aliloay/smart-lab-portal/docs/knowledge/obsidian/vault/12 - Generated Reports/Workflow drift.md

---
type: "report"
generated: true
updated: "2026-11-03T07:00:07+02:00"
---

# Workflow drift

New: none
Deleted: none
Changed:

No workflow was edited, activated or run. Accept the current state as the new baseline with `kb.py drift --accept`.
