aliloay/smart-lab-portal/docs/knowledge/obsidian/vault/02 - Systems/Environment monitoring.md

---
type: "system"
generated: true
updated: "2026-11-04T00:02:39+02:00"
---
# Environment monitoring

> Generated hub: notes whose path or workflow name matches this system's rules (shown). A navigation aid, not a verified dependency map.

- [[automation_n8n_json_08-sensor-thresholds.json]] (rule `(?i)sensor|environment|hazard`)
- [[automation_n8n_json_13-environment-hazard-escalation.json]] (rule `(?i)sensor|environment|hazard`)
- [[backend_app_services_environment.py]] (rule `(?i)sensor|environment|hazard`)
- [[firmware_SmartLab_Environment_Node_README.md]] (rule `SmartLab_Environment_Node`)
- [[firmware_SmartLab_Environment_Node_SmartLab_Environment_Node.ino]] (rule `SmartLab_Environment_Node`)
- [[Smart Lab 08 - Sensor threshold alerts]] (rule `(?i)sensor|environment|hazard`)
- [[Smart Lab 13 - Environment hazard escalation]] (rule `(?i)sensor|environment|hazard`)
- [[Smart Lab 14 - Environment _ bin node offline]] (rule `(?i)sensor|environment|hazard`)

Back to [[Home]]
