aliloay/smart-lab-portal/backend/data/marker_art/consumables-bin.jpg

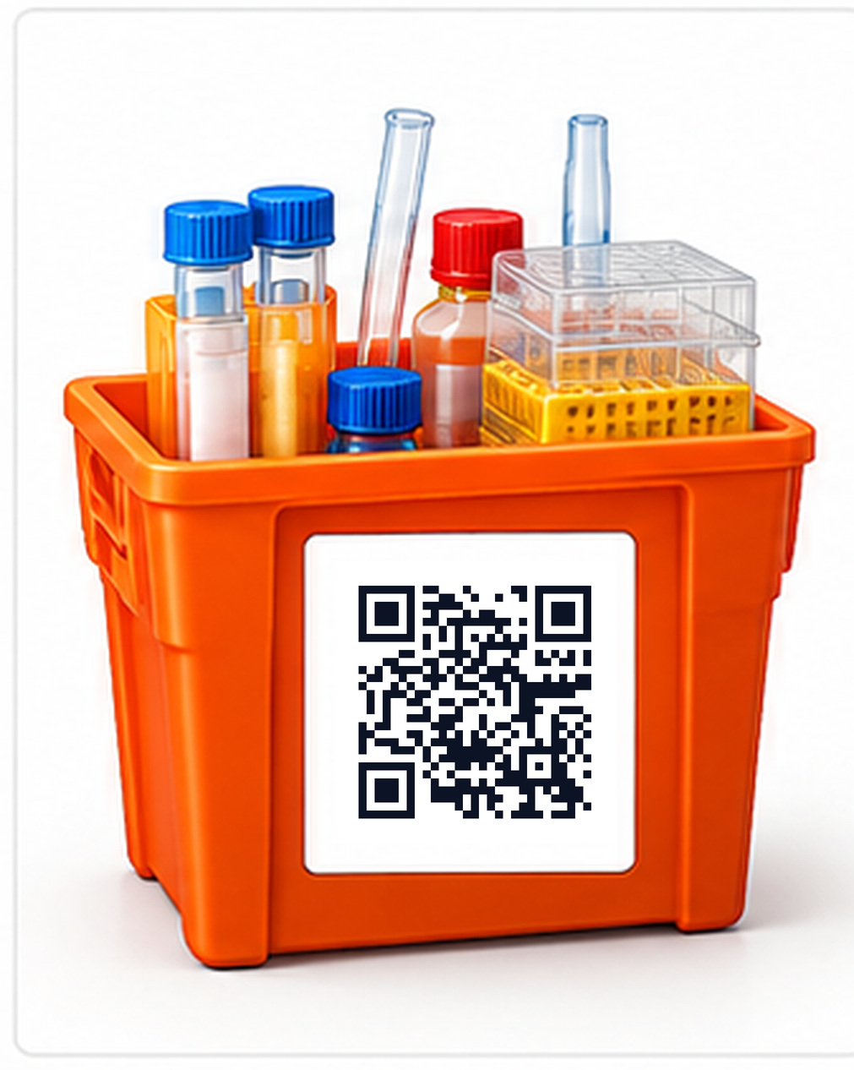
backend/data/marker_art/consumables-bin.jpg
