aliloay/smart-lab-portal/backend/data/marker_art/entry-camera.jpg

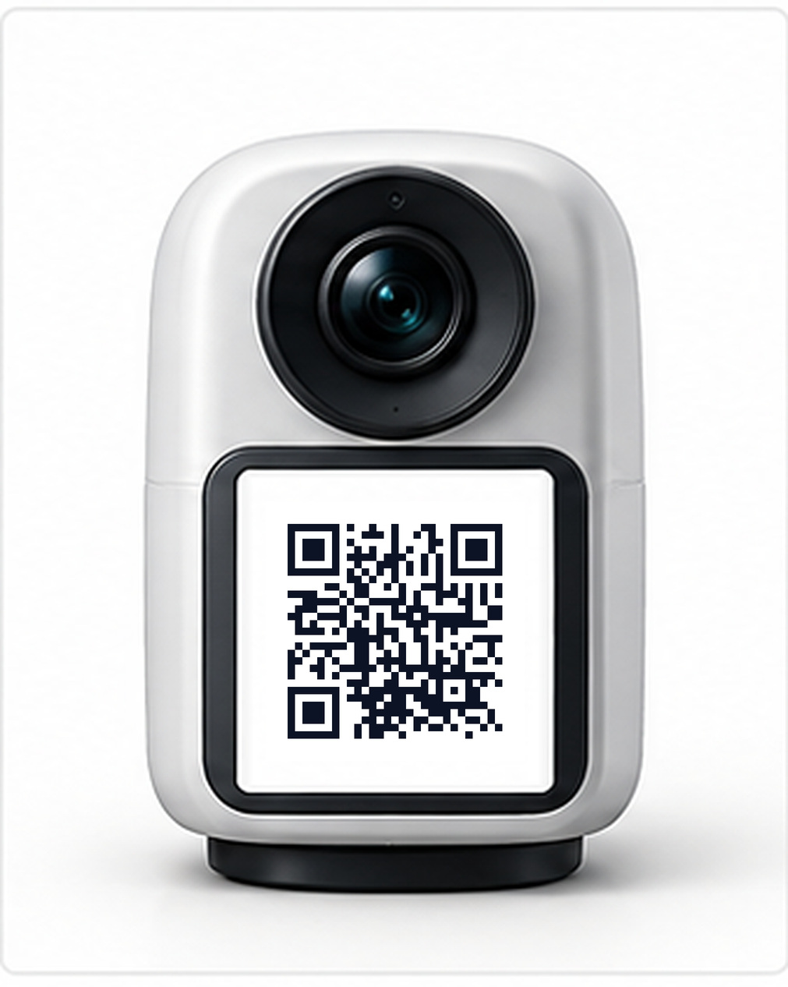
backend/data/marker_art/entry-camera.jpg
