aliloay/smart-lab-portal/backend/data/marker_art/face-server.jpg

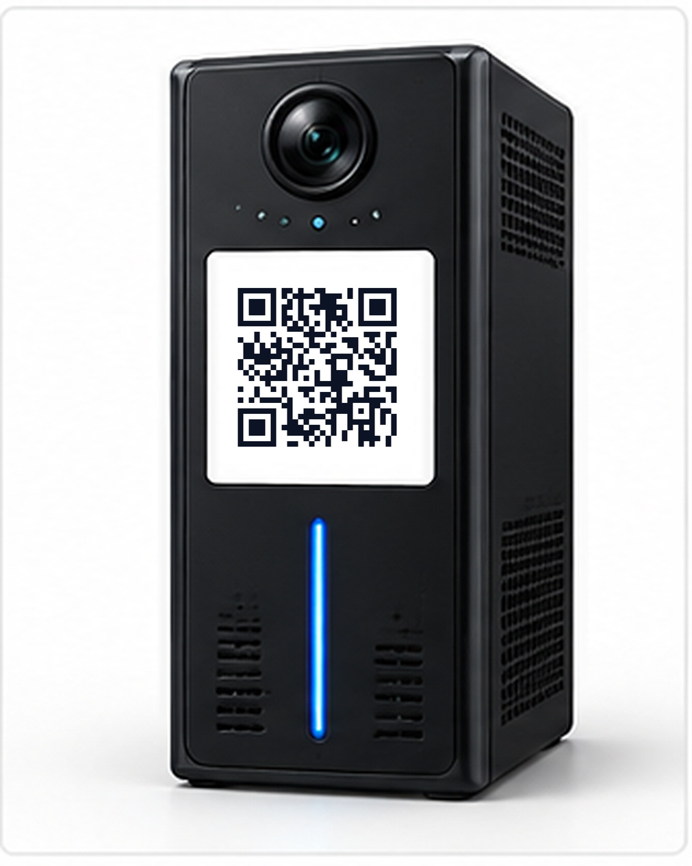
backend/data/marker_art/face-server.jpg
