aliloay/smart-lab-portal/backend/data/marker_art/security-camera-2.jpg

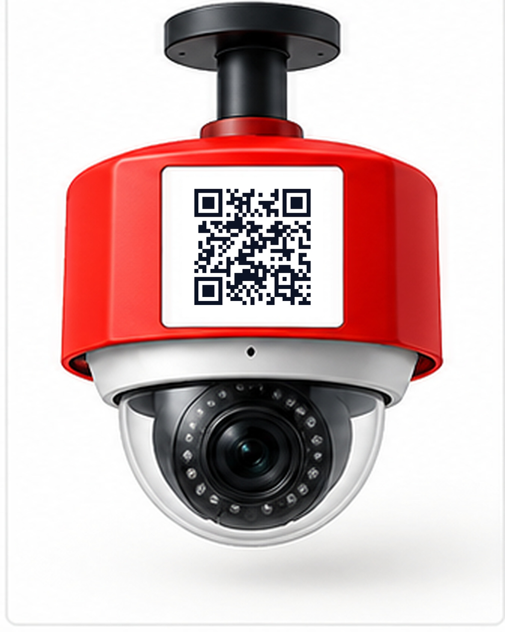
backend/data/marker_art/security-camera-2.jpg
