aliloay/smart-lab-portal/backend/data/marker_art/ur5e-robot.jpg

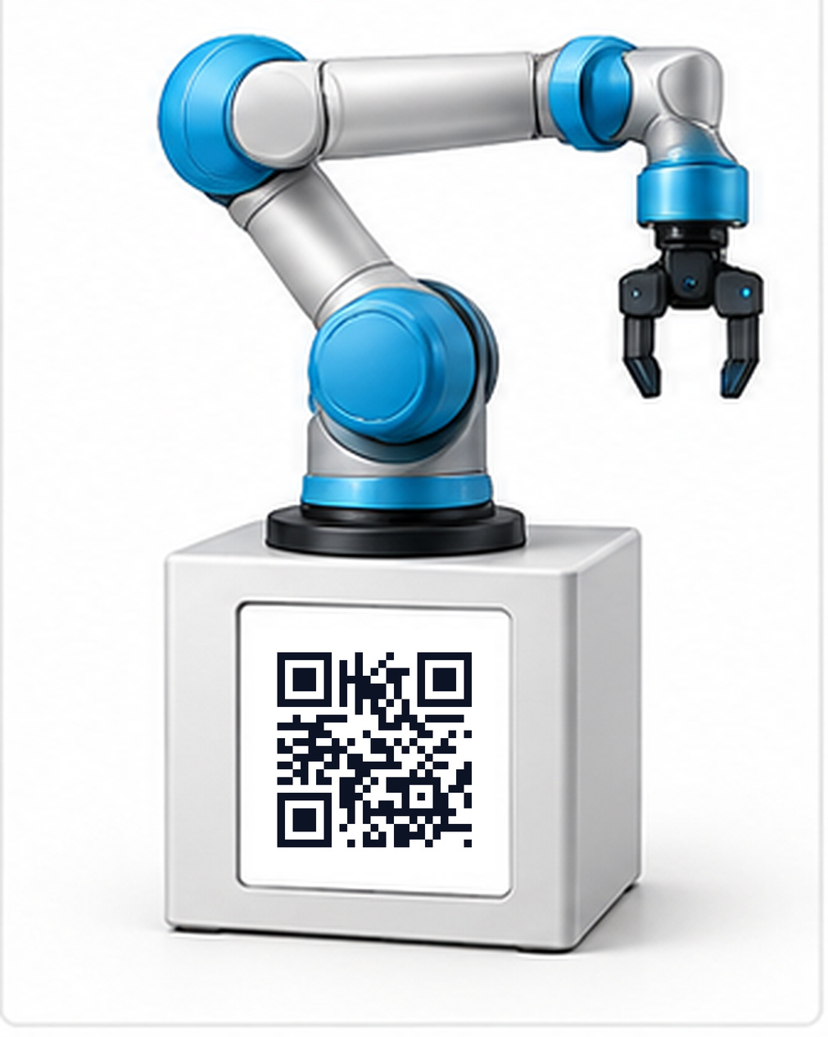
backend/data/marker_art/ur5e-robot.jpg
