aliloay/smart-lab-portal/backend/data/marker_pack/admin-laptop.png

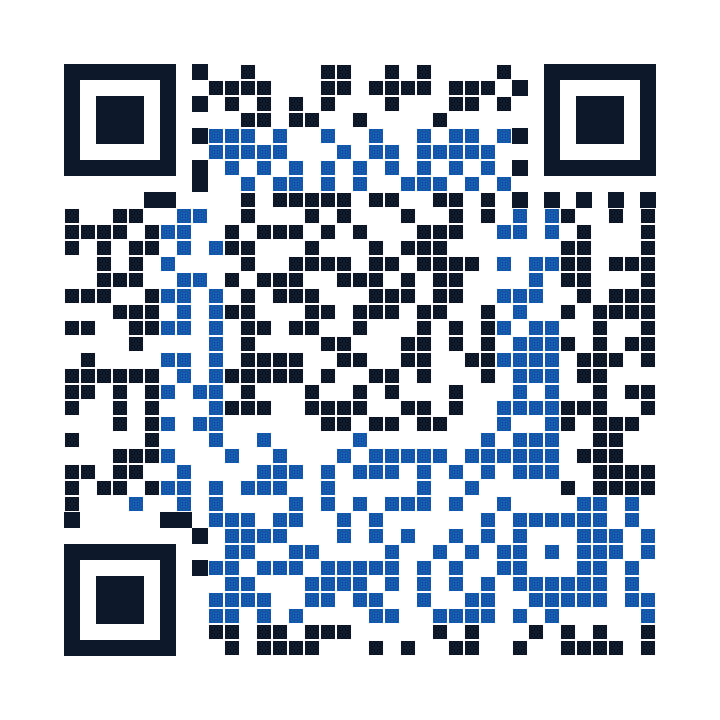
backend/data/marker_pack/admin-laptop.png
