aliloay/smart-lab-portal/backend/data/marker_pack/door-master.png

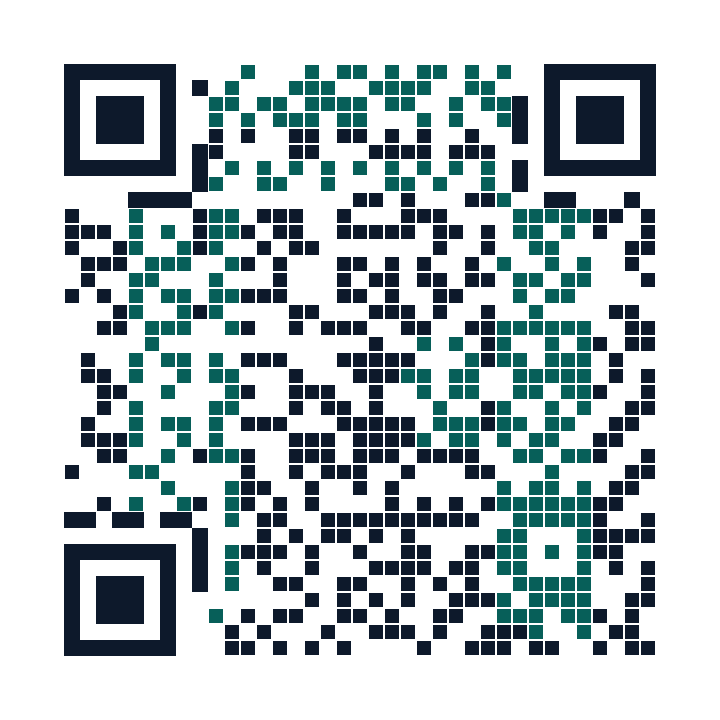
backend/data/marker_pack/door-master.png
