aliloay/smart-lab-portal/backend/data/marker_pack/fanuc-robot.png

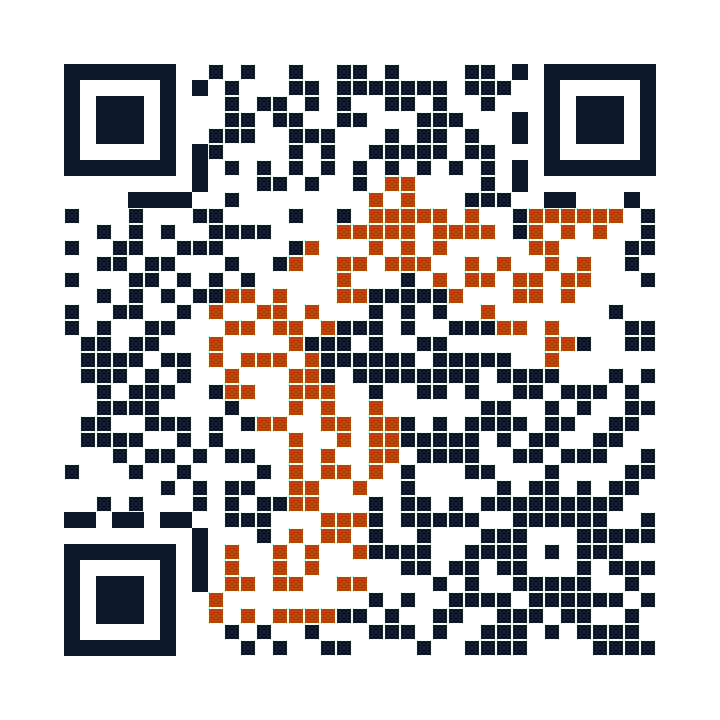
backend/data/marker_pack/fanuc-robot.png
