aliloay/smart-lab-portal/backend/data/marker_pack/ur5e-robot.png

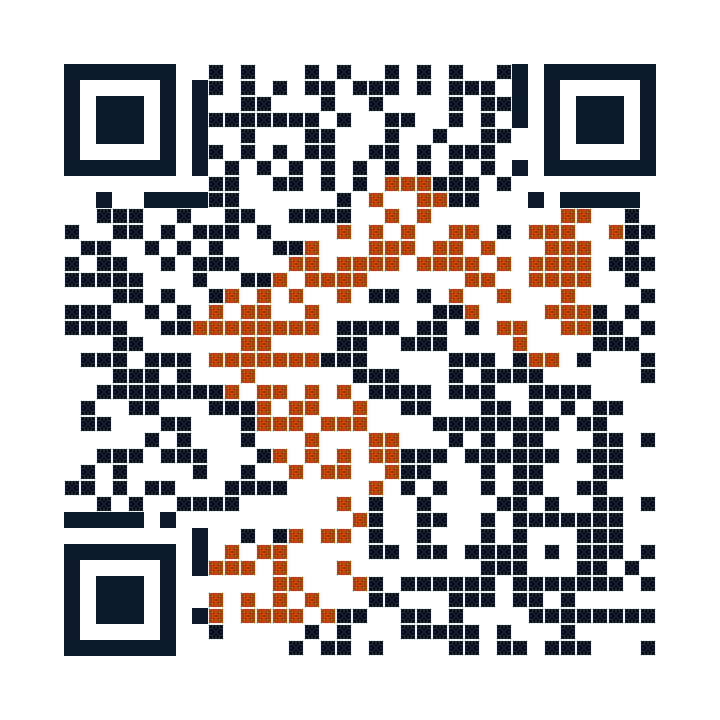
backend/data/marker_pack/ur5e-robot.png
