aliloay/smart-lab-portal/docs/images/nodes/consumables-node-render.png

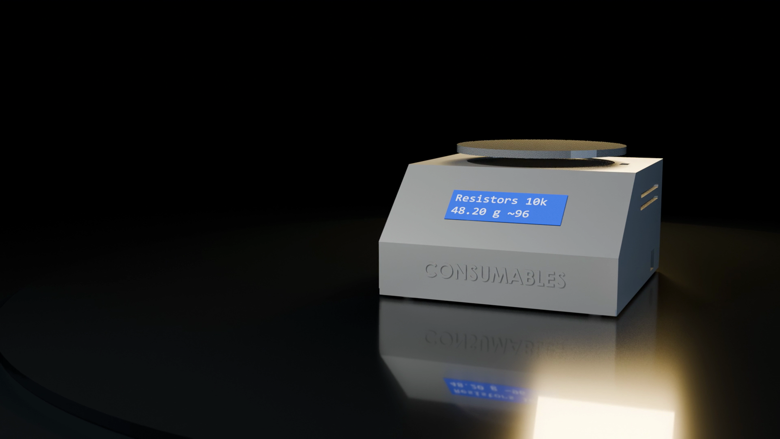
docs/images/nodes/consumables-node-render.png
