aliloay/smart-lab-portal/docs/media/ar/ur5e_cell_marker_photo.jpg

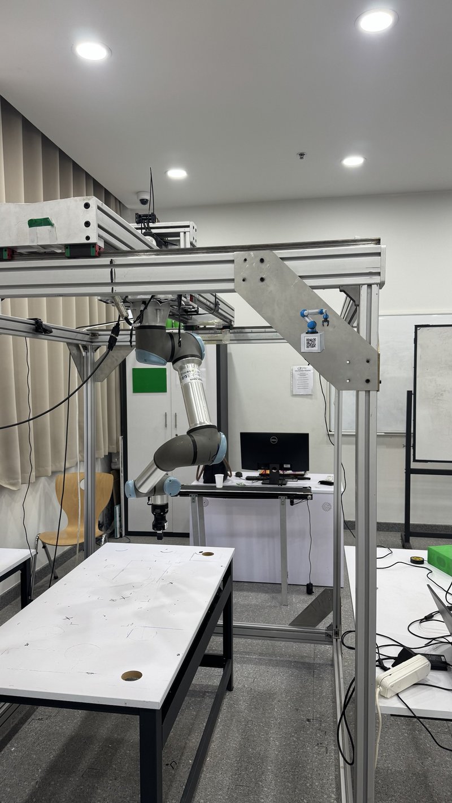
docs/media/ar/ur5e_cell_marker_photo.jpg
