aliloay/smart-lab-portal/docs/media/portal/dev_captures/incident_investigation.png

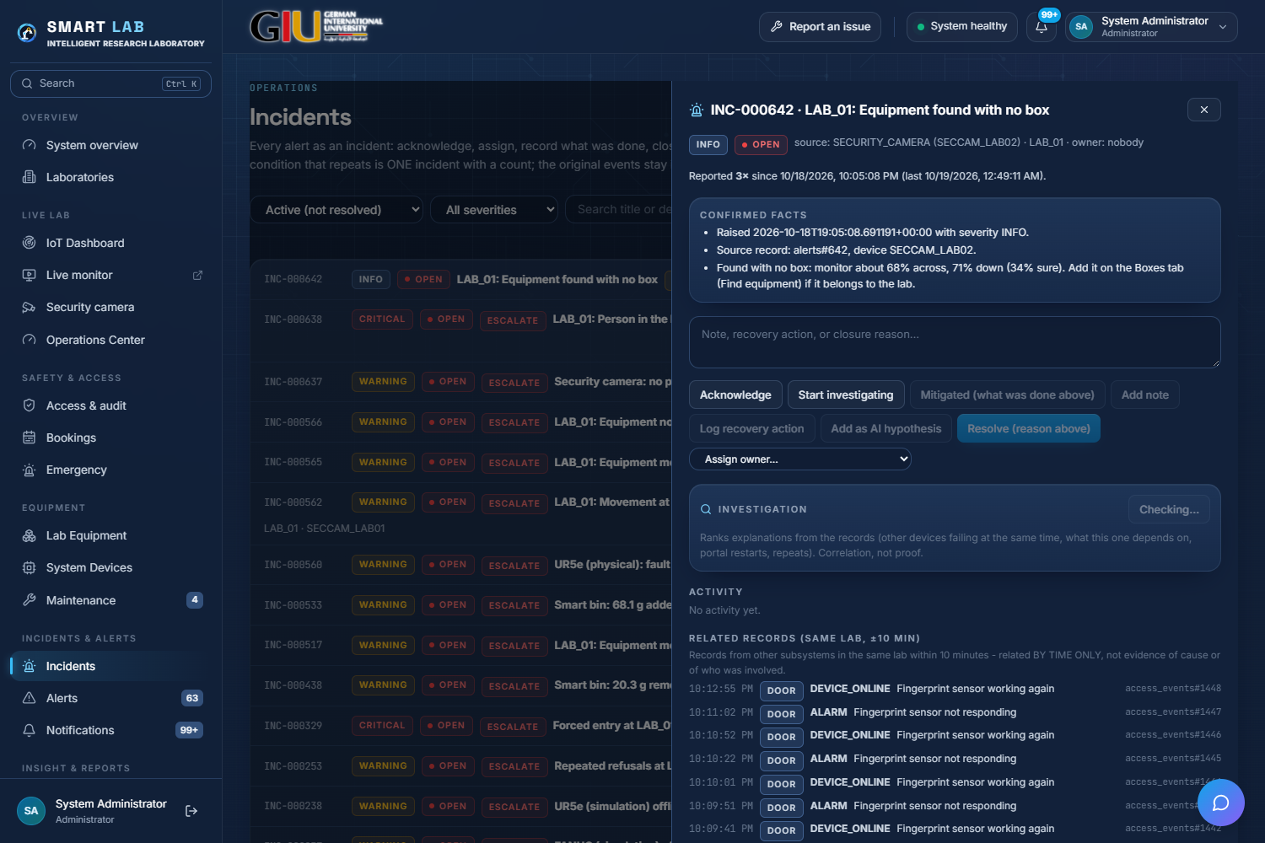
docs/media/portal/dev_captures/incident_investigation.png
