aliloay/smart-lab-portal/docs/media/portal/dev_captures/rel_briefing.png

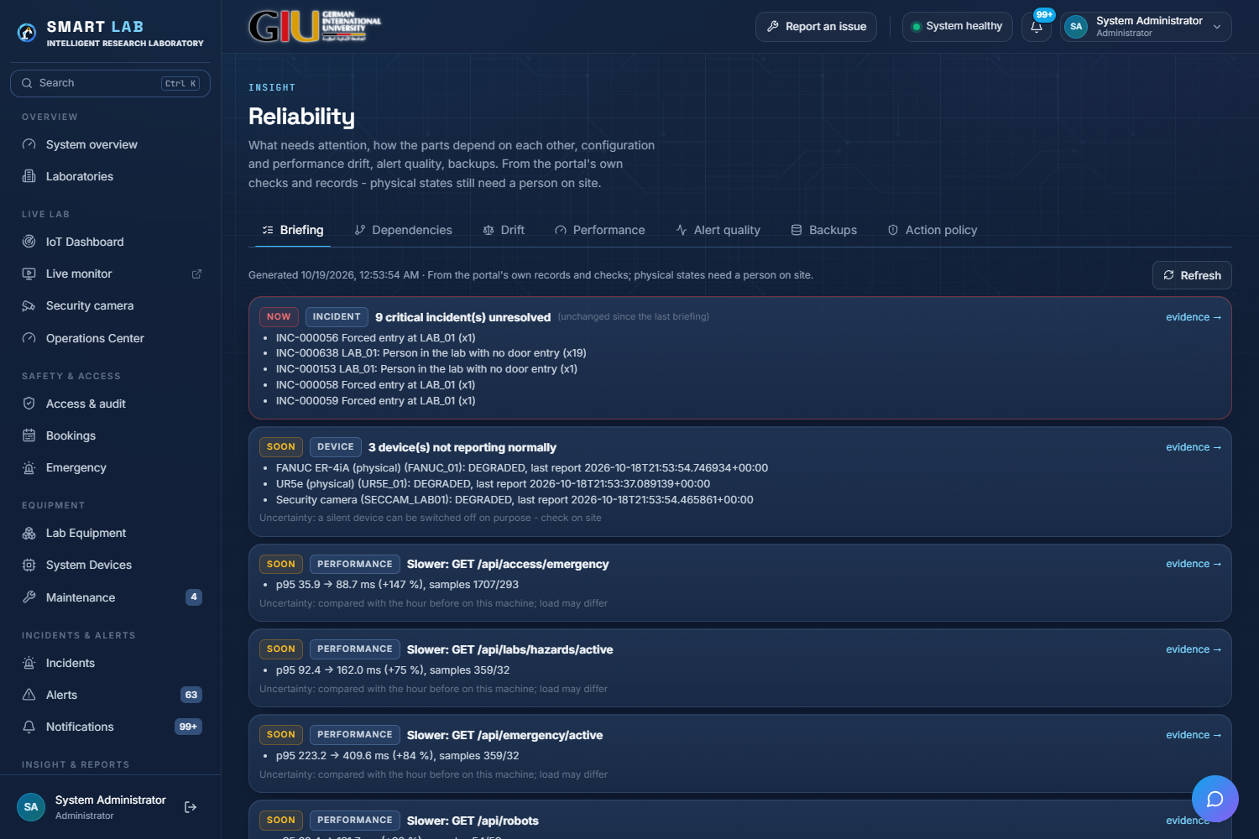
docs/media/portal/dev_captures/rel_briefing.png
