aliloay/smart-lab-portal/docs/media/portal/dev_captures/rel_quality.png

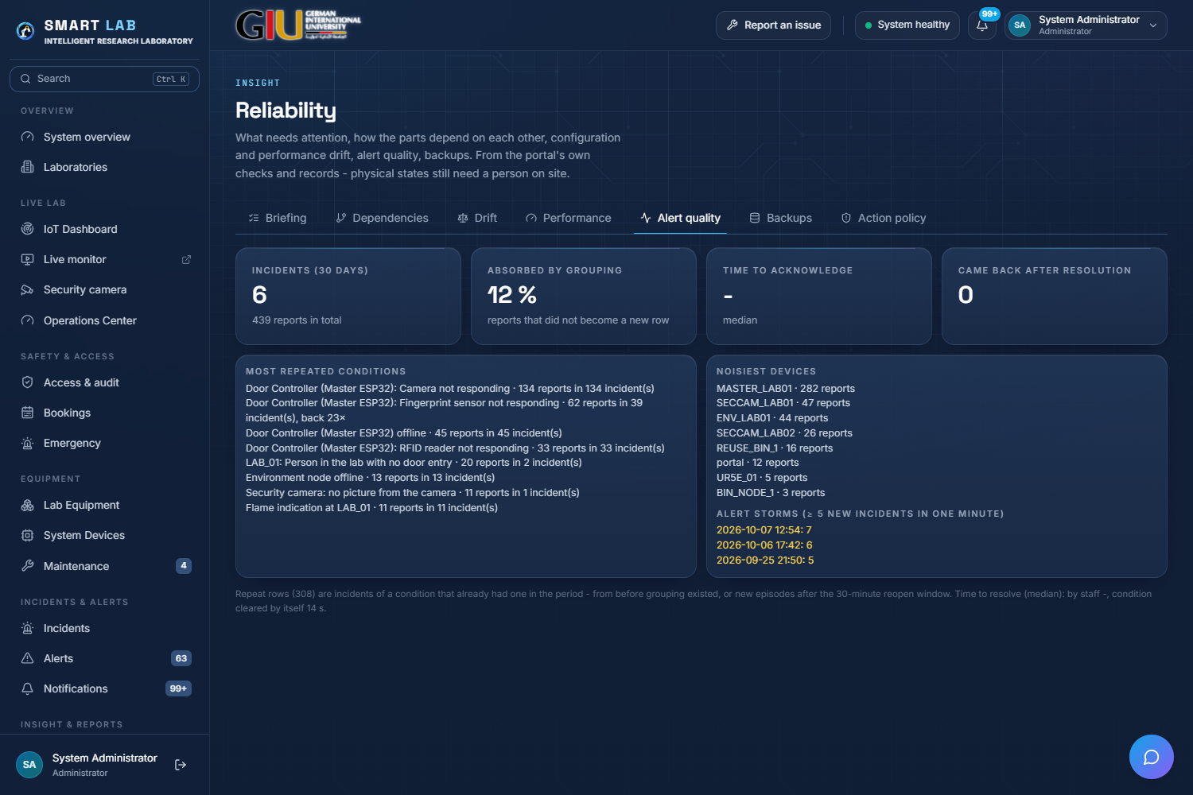
docs/media/portal/dev_captures/rel_quality.png
