aliloay/smart-lab-portal/docs/media/portal/dev_captures/rel_whatif.png

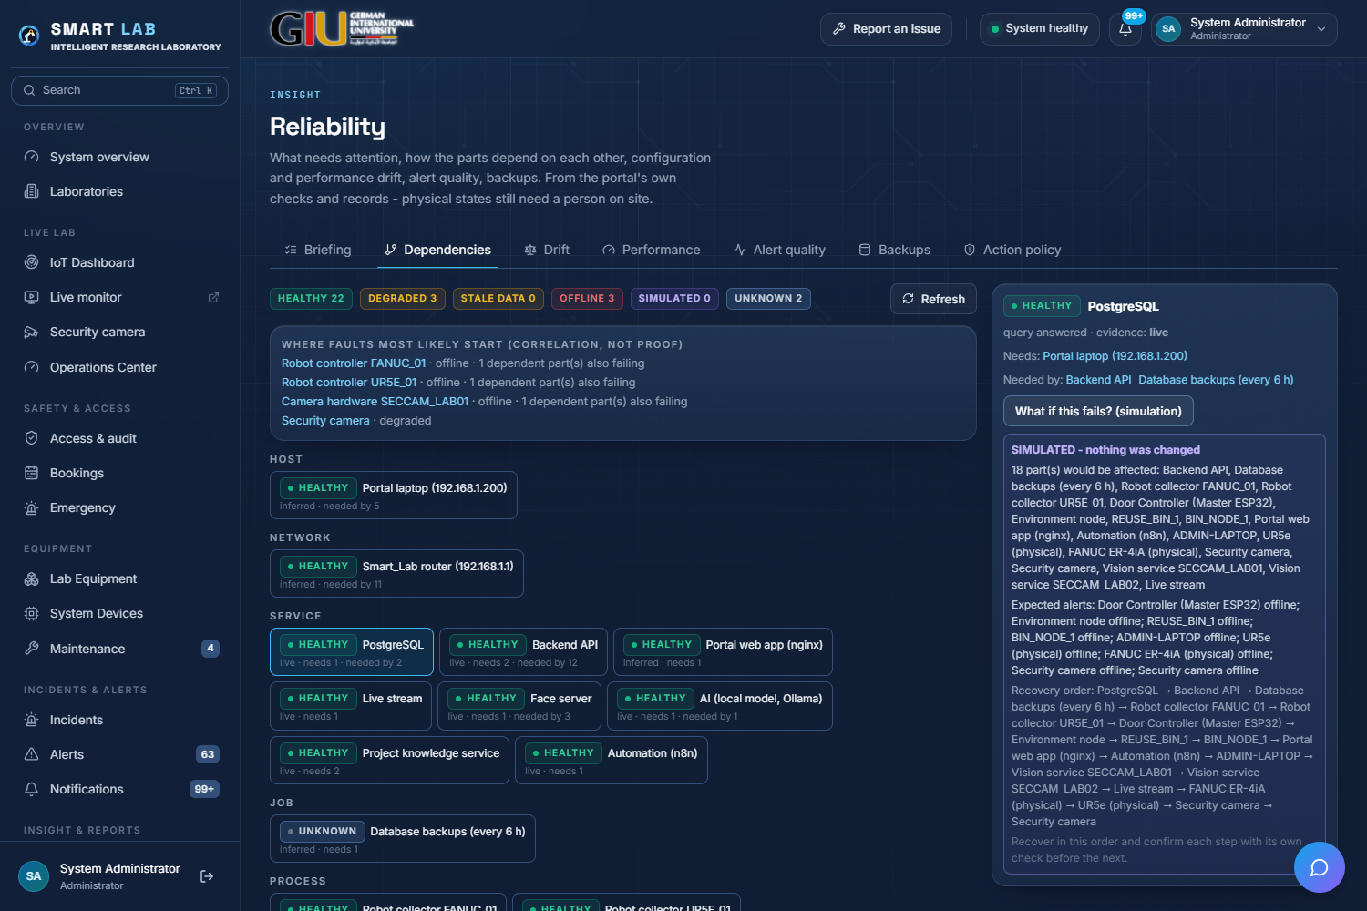
docs/media/portal/dev_captures/rel_whatif.png
