aliloay/smart-lab-portal/docs/media/portal/dev_captures/robot_10_control.png

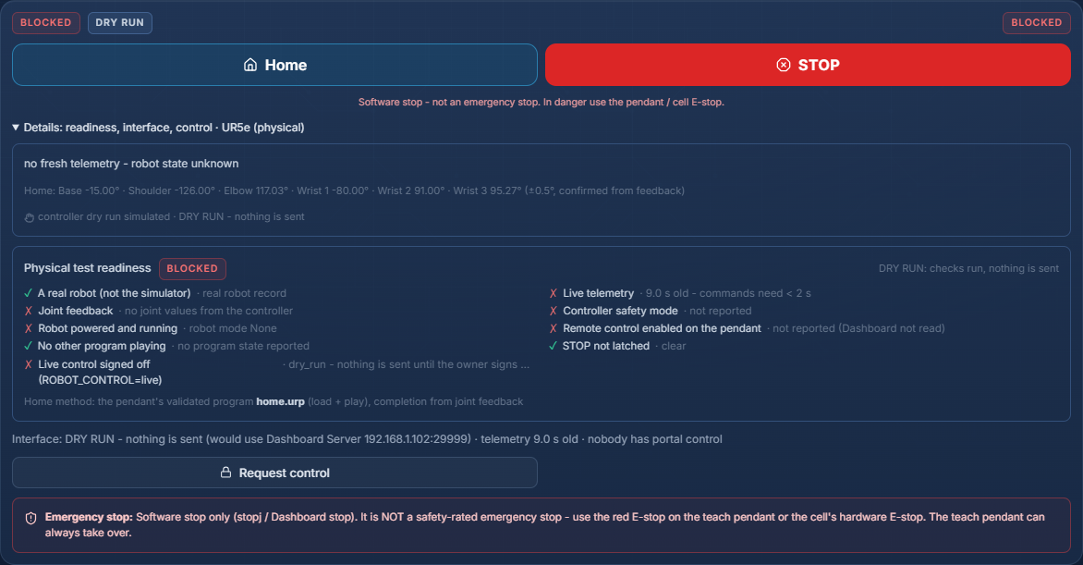
docs/media/portal/dev_captures/robot_10_control.png
