aliloay/smart-lab-portal/docs/media/portal/dev_captures/robot_11_control.png

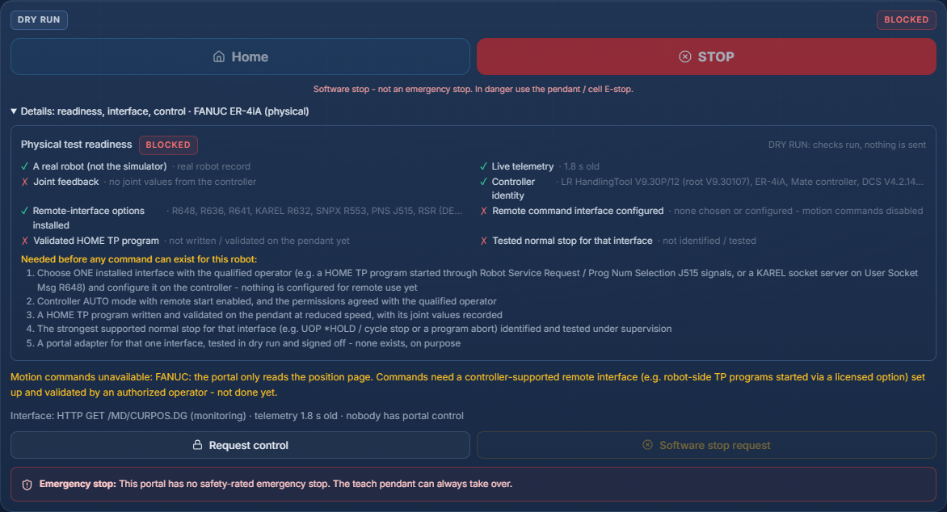
docs/media/portal/dev_captures/robot_11_control.png
