aliloay/smart-lab-portal/docs/paper_figures/portal_2026-10-19/00a_sign_in.png

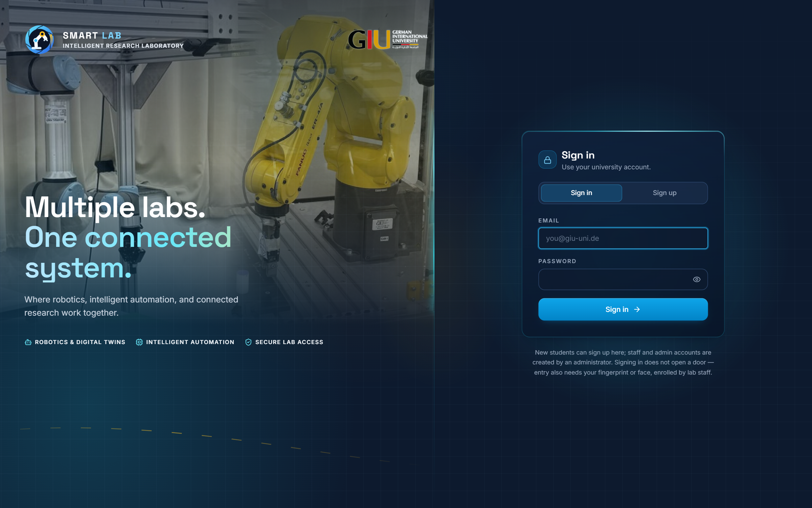
docs/paper_figures/portal_2026-10-19/00a_sign_in.png
