aliloay/smart-lab-portal/docs/paper_figures/portal_2026-10-19/02_laboratories.png

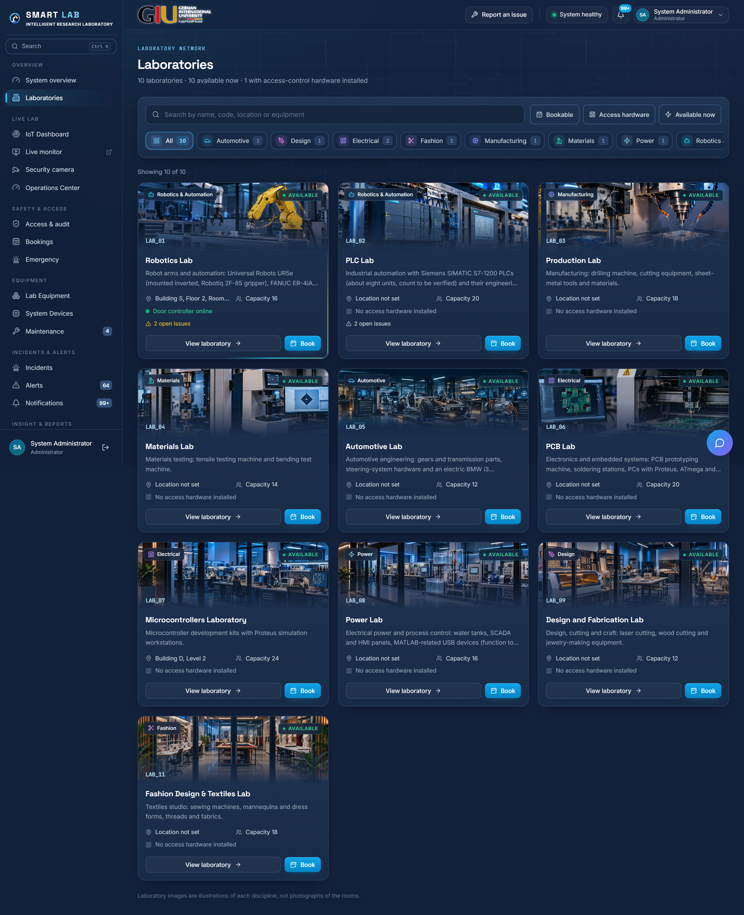
docs/paper_figures/portal_2026-10-19/02_laboratories.png
