aliloay/smart-lab-portal/docs/paper_figures/portal_2026-10-19/03_lab_robotics.png

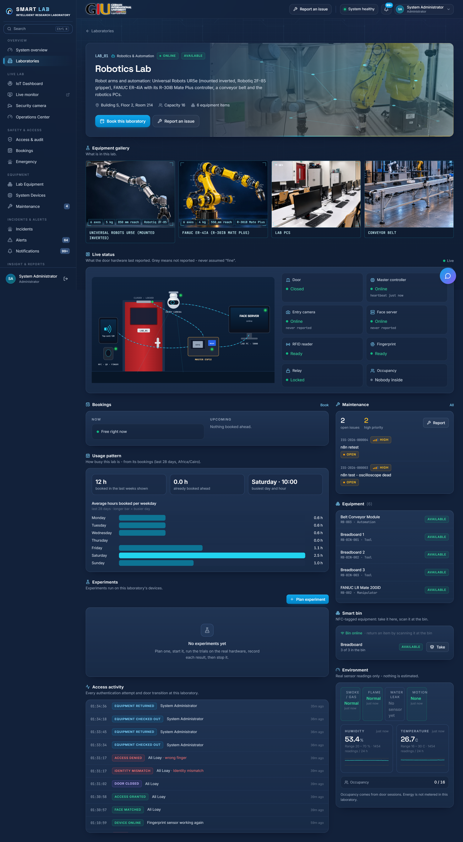
docs/paper_figures/portal_2026-10-19/03_lab_robotics.png
