aliloay/smart-lab-portal/docs/paper_figures/portal_2026-10-19/04_iot_dashboard.png

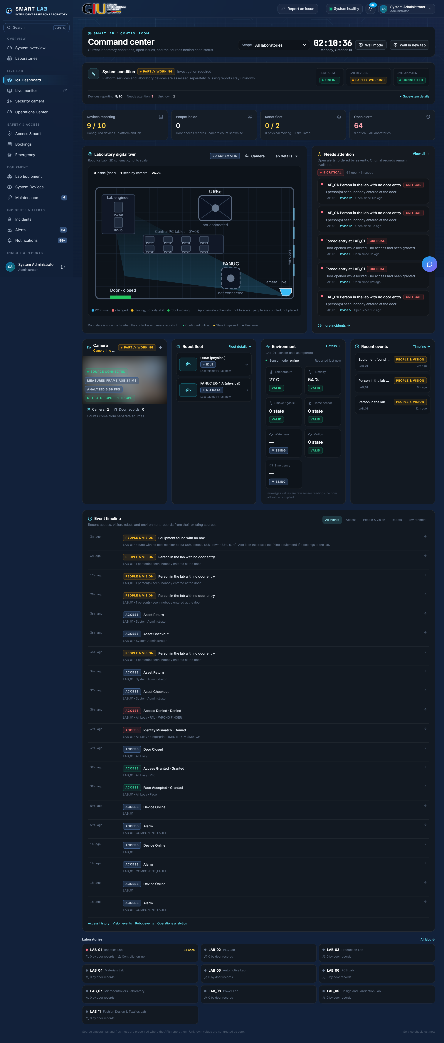
docs/paper_figures/portal_2026-10-19/04_iot_dashboard.png
