aliloay/smart-lab-portal/docs/paper_figures/portal_2026-10-19/05_live_monitor.png

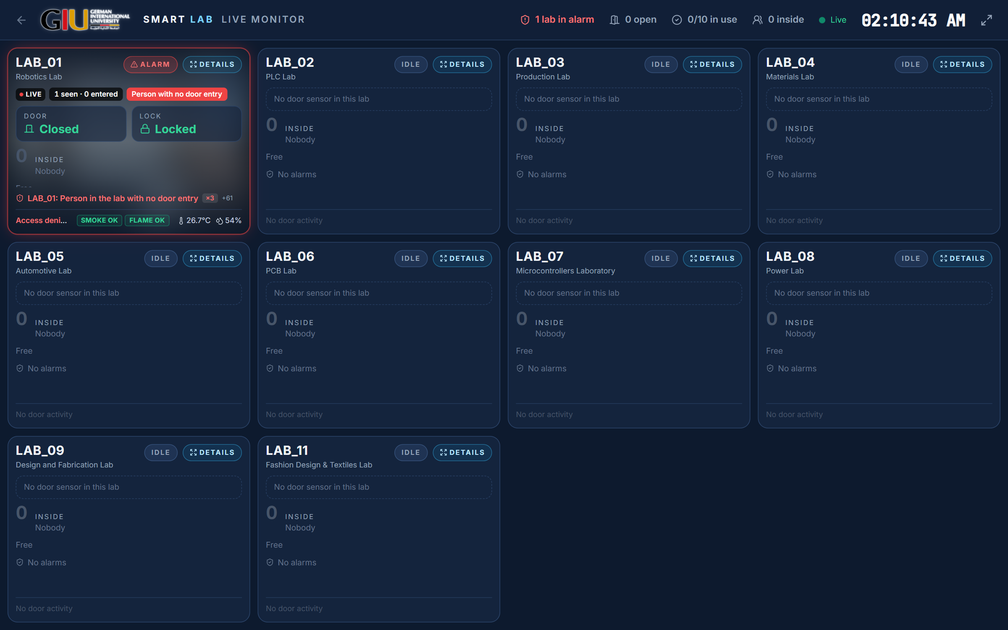
docs/paper_figures/portal_2026-10-19/05_live_monitor.png
