aliloay/smart-lab-portal/docs/paper_figures/portal_2026-10-19/06_security_cameras.png

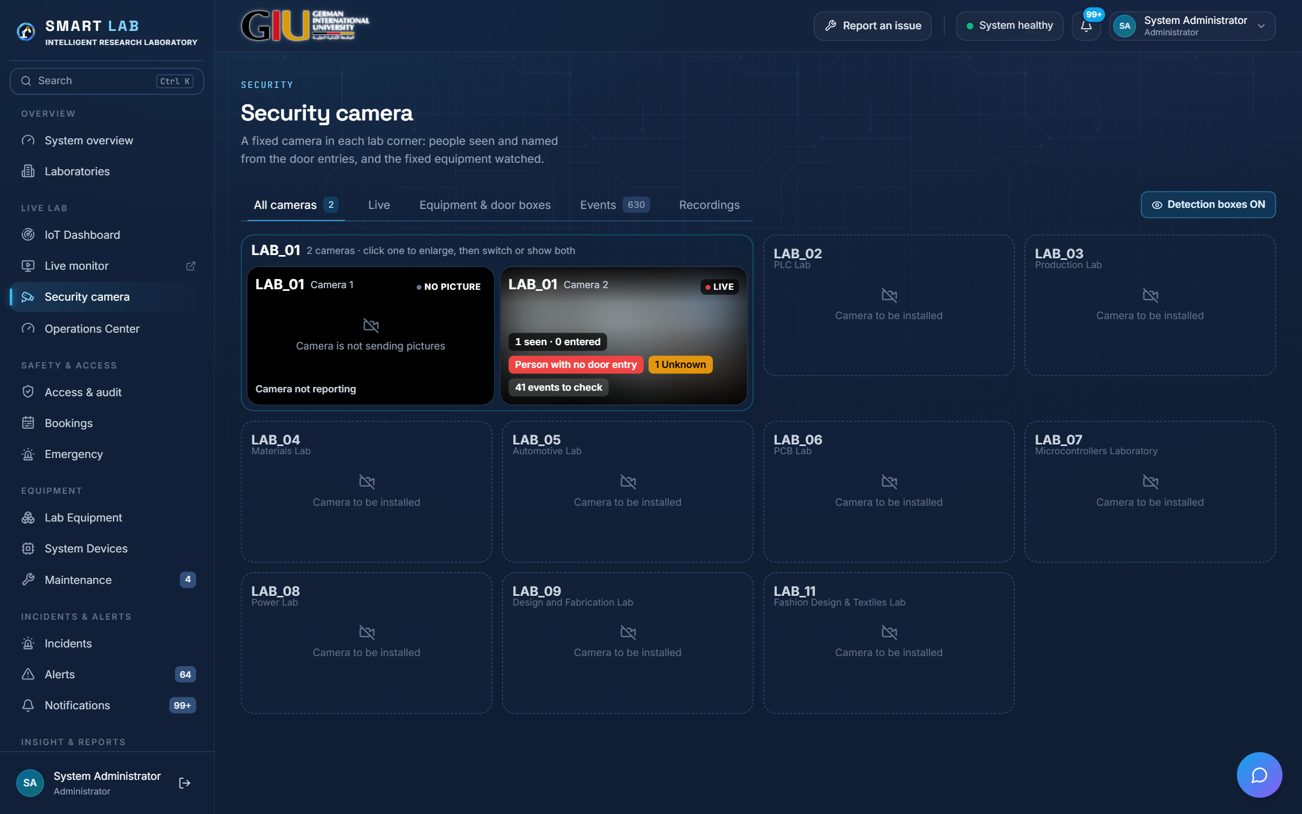
docs/paper_figures/portal_2026-10-19/06_security_cameras.png
