aliloay/smart-lab-portal/docs/paper_figures/portal_2026-10-19/08_access_audit.png

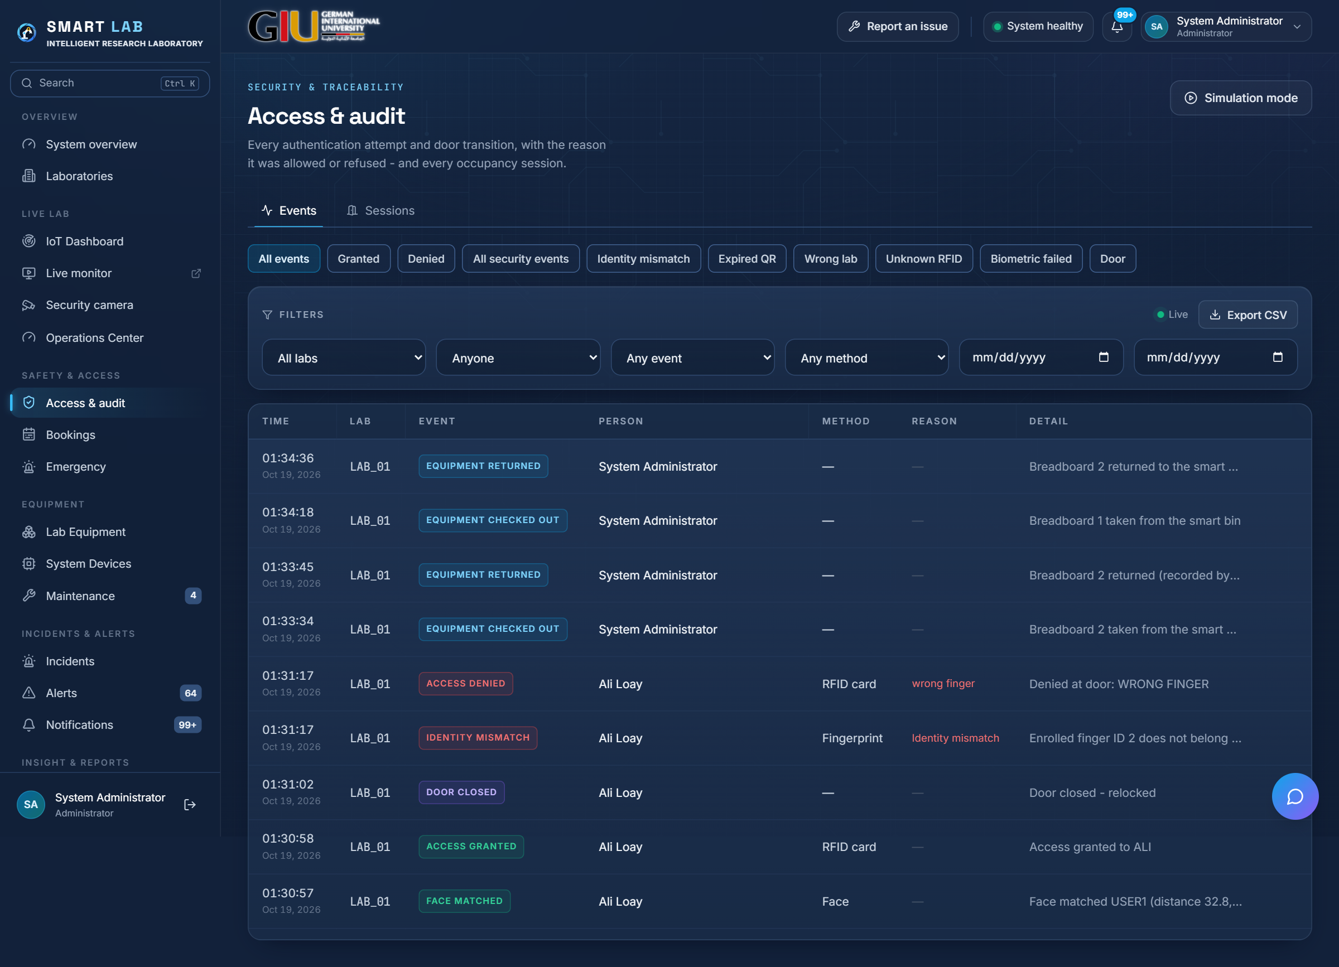
docs/paper_figures/portal_2026-10-19/08_access_audit.png
