aliloay/smart-lab-portal/docs/paper_figures/portal_2026-10-19/11_equipment_environment.png

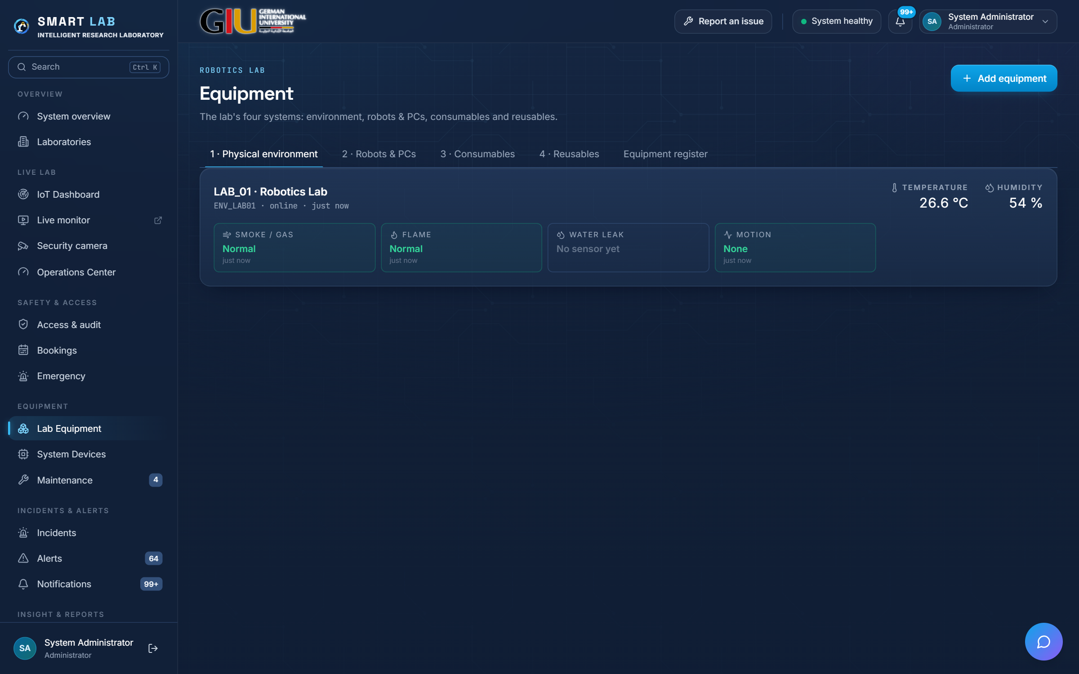
docs/paper_figures/portal_2026-10-19/11_equipment_environment.png
