aliloay/smart-lab-portal/docs/paper_figures/portal_2026-10-19/12_equipment_robots_pcs.png

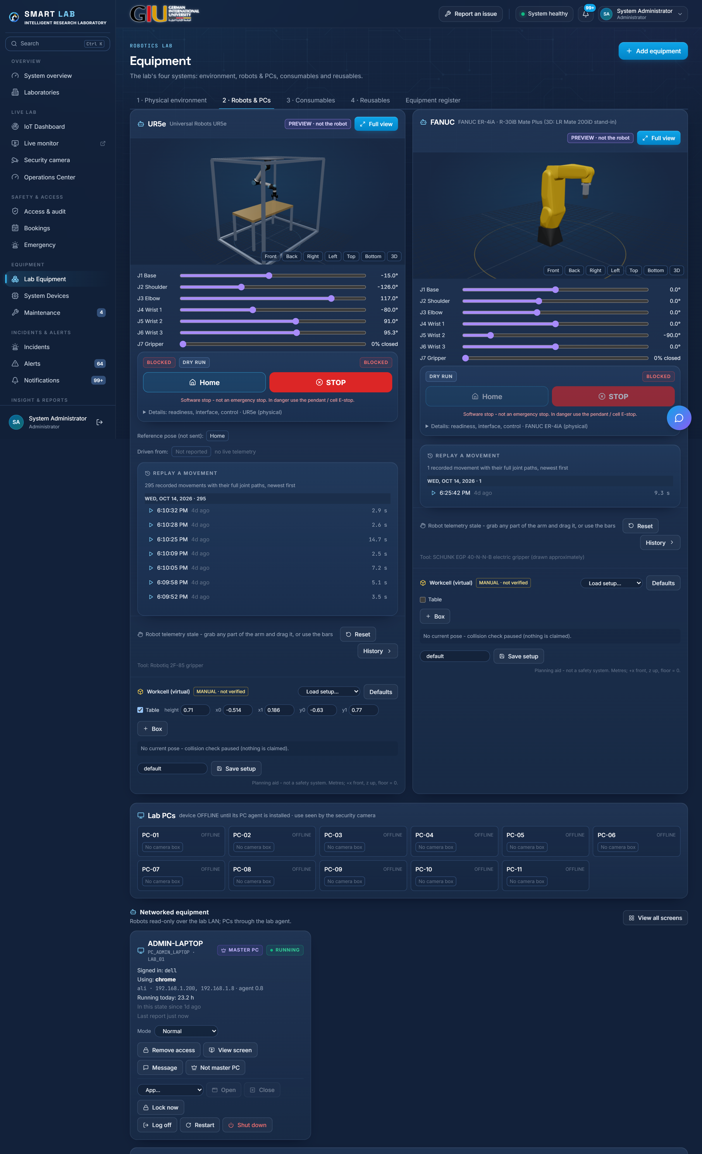
docs/paper_figures/portal_2026-10-19/12_equipment_robots_pcs.png
