aliloay/smart-lab-portal/docs/paper_figures/portal_2026-10-19/13_equipment_consumables.png

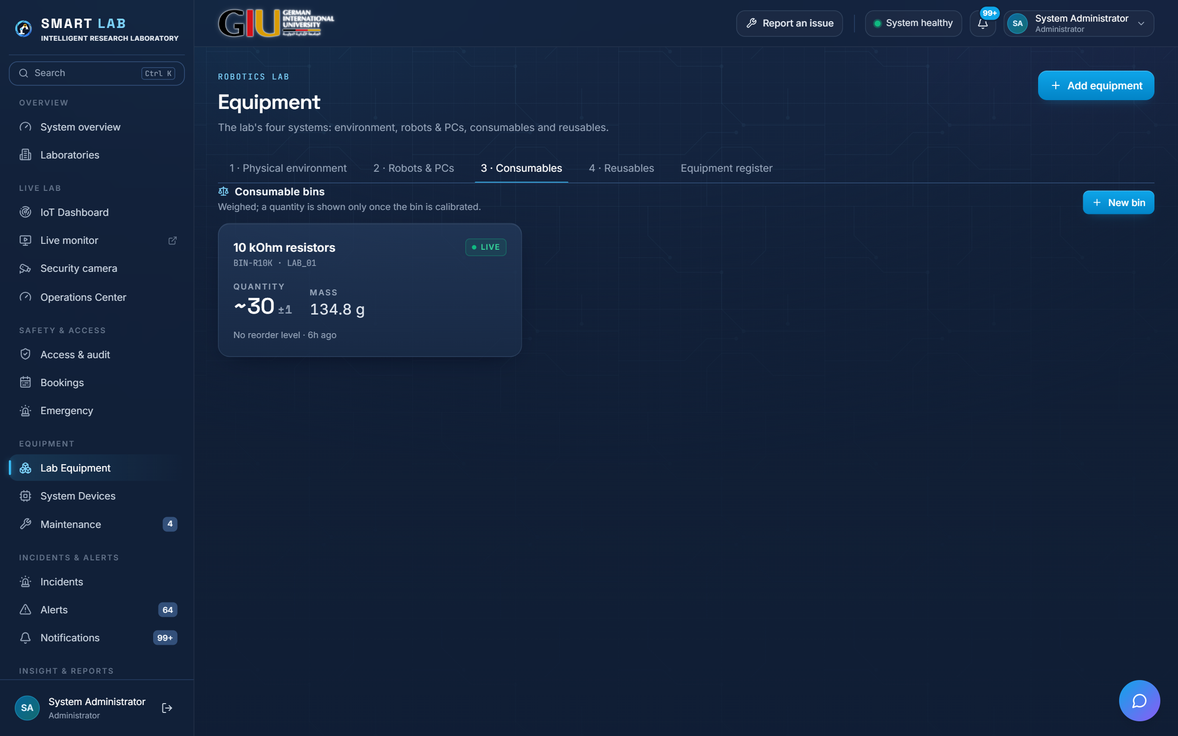
docs/paper_figures/portal_2026-10-19/13_equipment_consumables.png
