aliloay/smart-lab-portal/docs/paper_figures/portal_2026-10-19/14_equipment_reusables.png

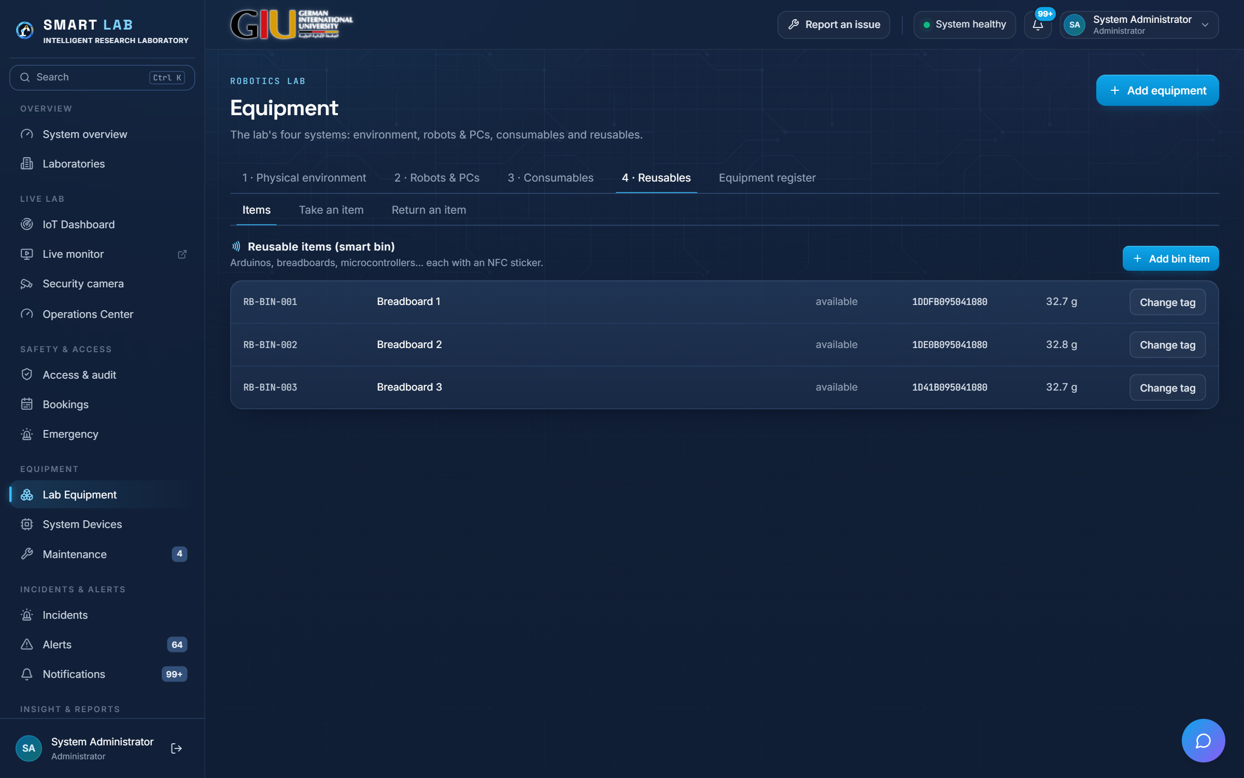
docs/paper_figures/portal_2026-10-19/14_equipment_reusables.png
