aliloay/smart-lab-portal/docs/paper_figures/portal_2026-10-19/15_equipment_register.png

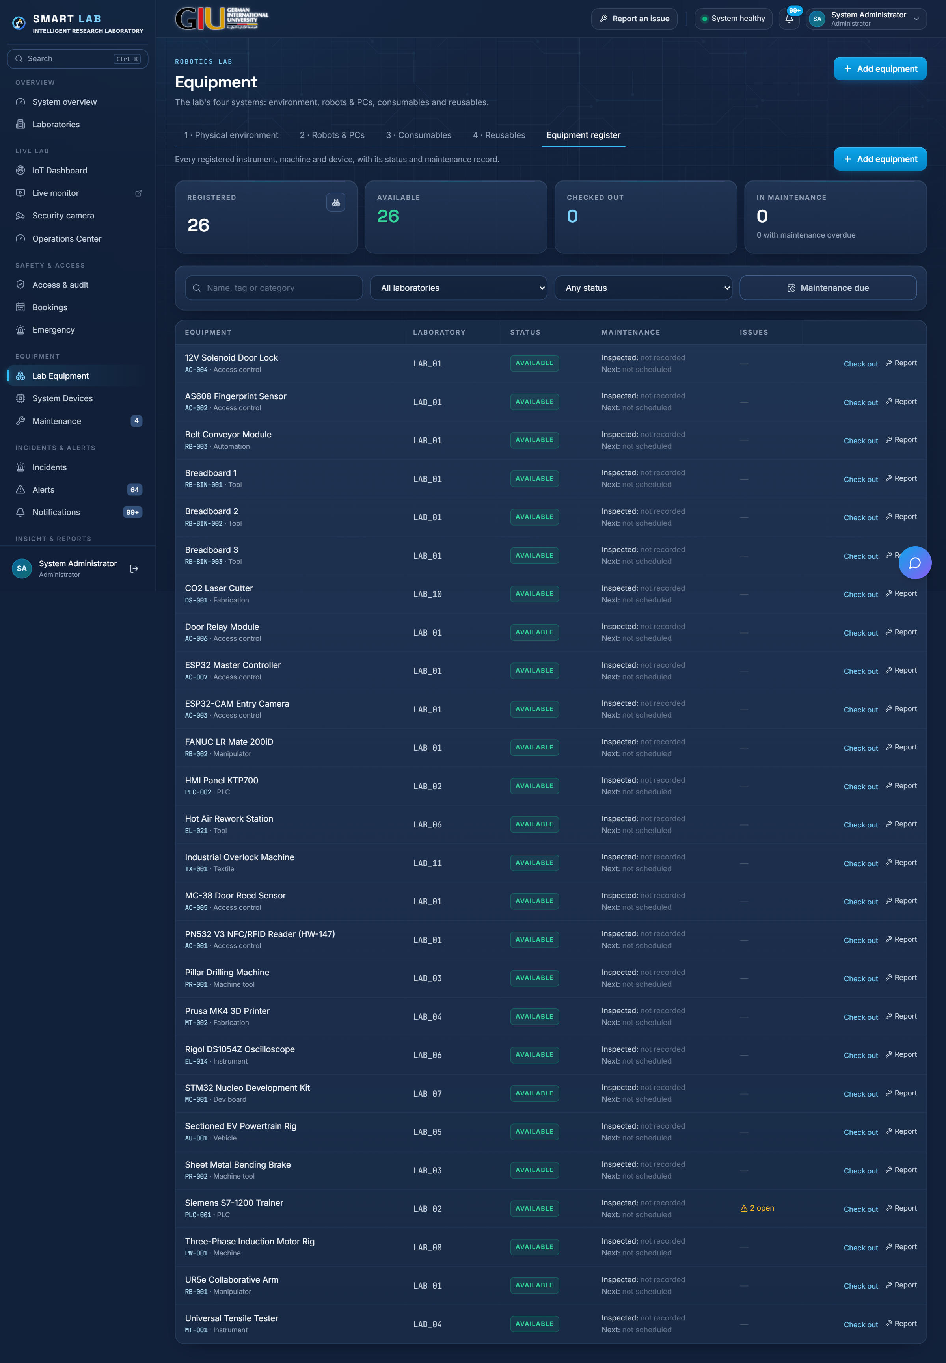
docs/paper_figures/portal_2026-10-19/15_equipment_register.png
