aliloay/smart-lab-portal/docs/paper_figures/portal_2026-10-19/16_system_devices.png

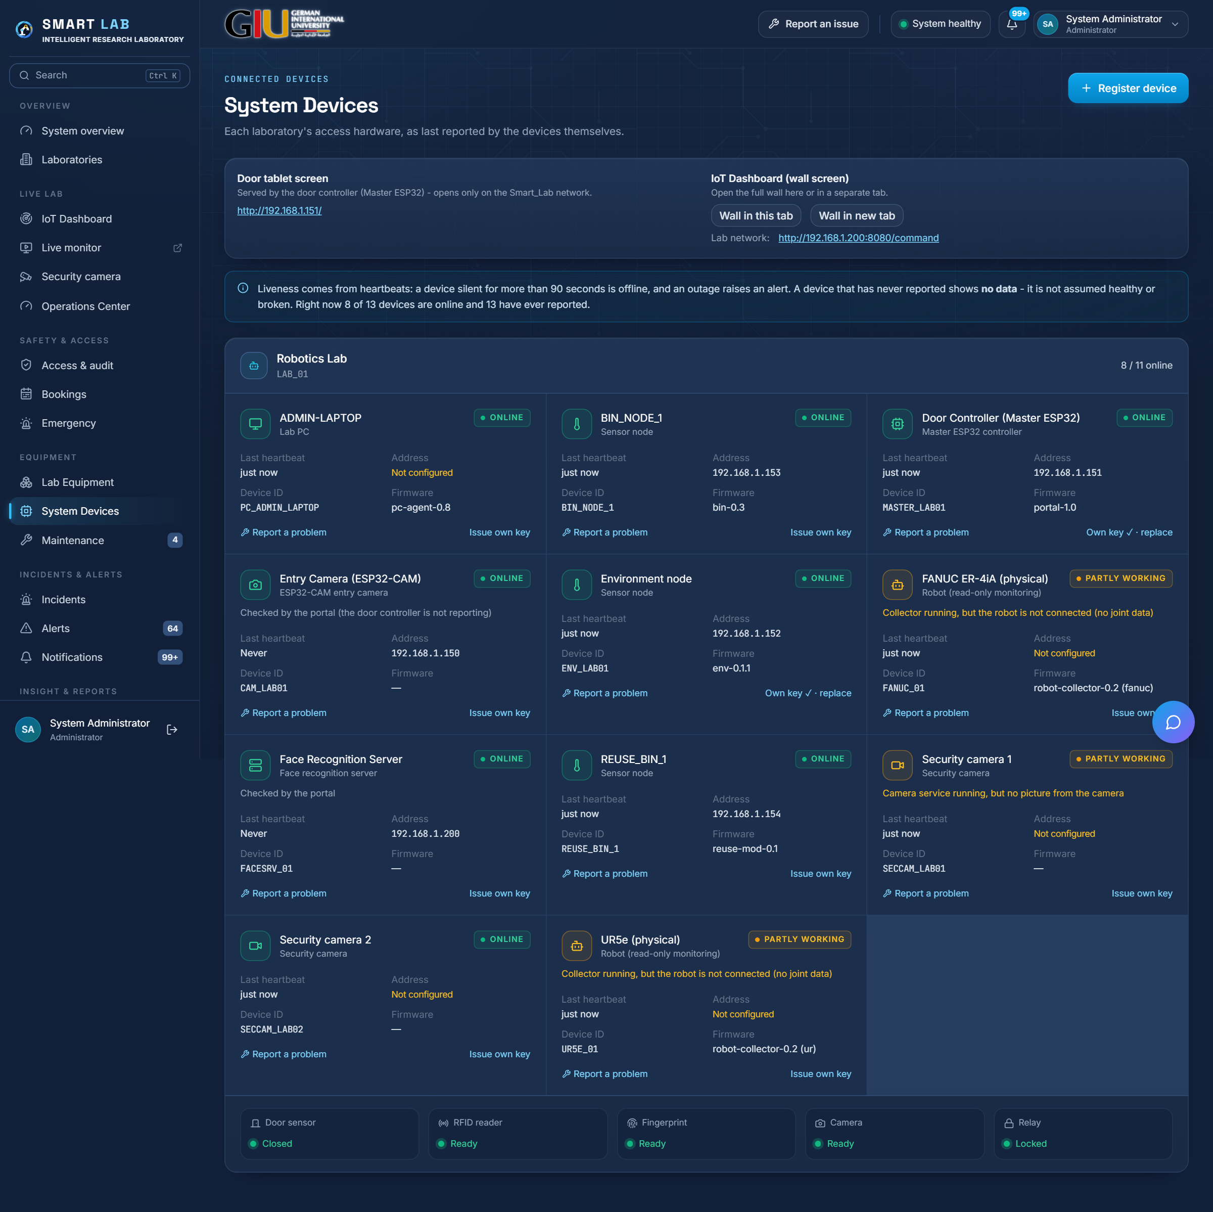
docs/paper_figures/portal_2026-10-19/16_system_devices.png
