aliloay/smart-lab-portal/docs/paper_figures/portal_2026-10-19/17_robot_ur5e_detail.png

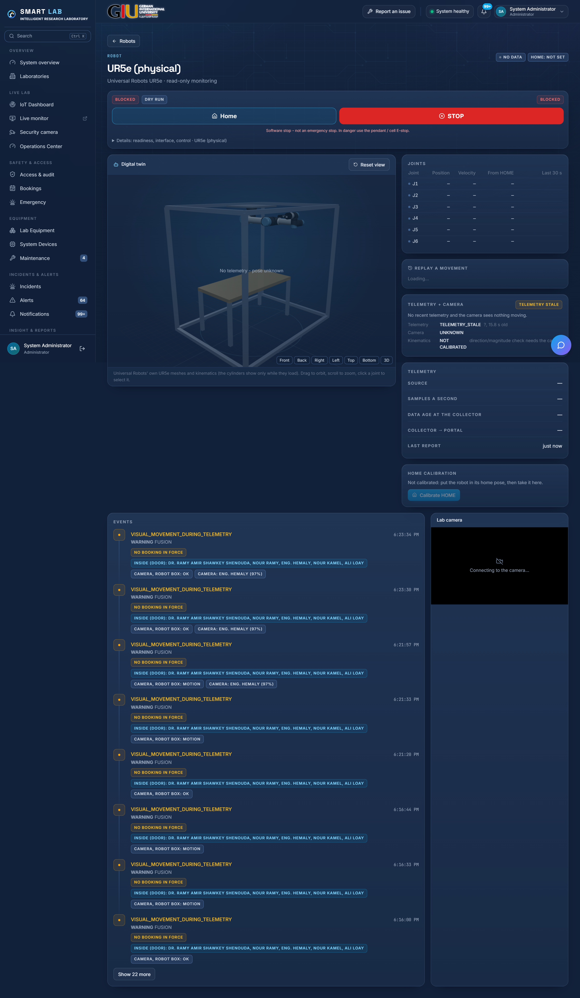
docs/paper_figures/portal_2026-10-19/17_robot_ur5e_detail.png
