aliloay/smart-lab-portal/docs/paper_figures/portal_2026-10-19/21_notifications.png

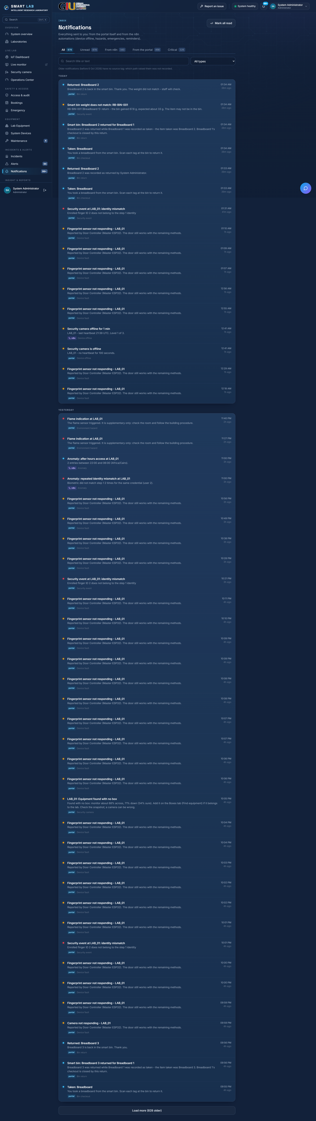
docs/paper_figures/portal_2026-10-19/21_notifications.png
