aliloay/smart-lab-portal/docs/paper_figures/portal_2026-10-19/24_reliability_dependencies.png

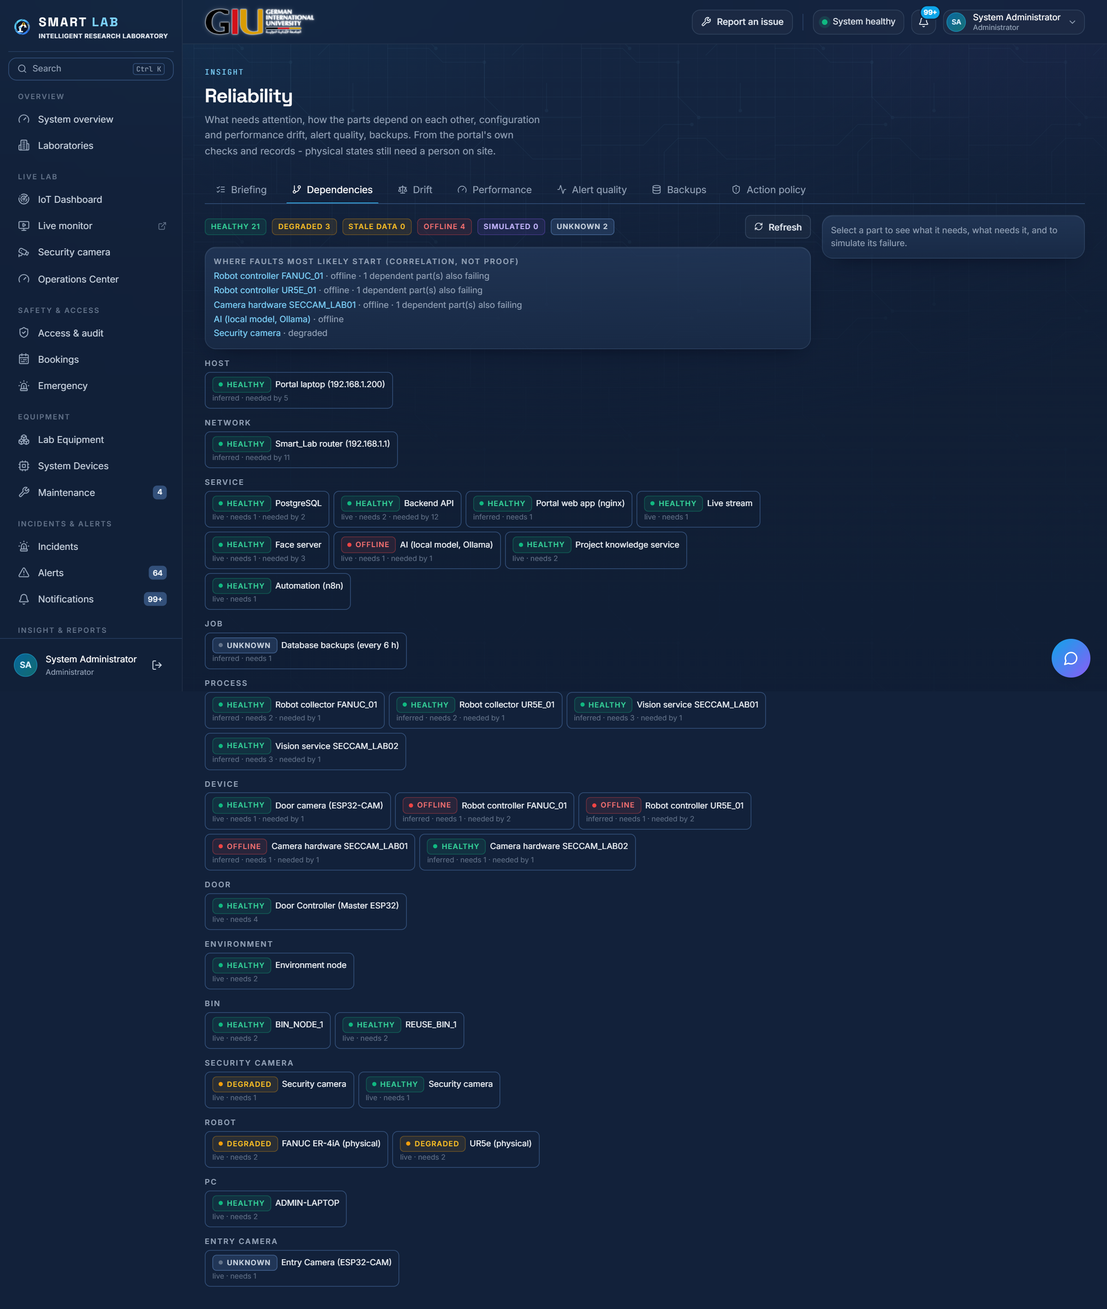
docs/paper_figures/portal_2026-10-19/24_reliability_dependencies.png
