aliloay/smart-lab-portal/docs/paper_figures/portal_2026-10-19/25_reliability_drift.png

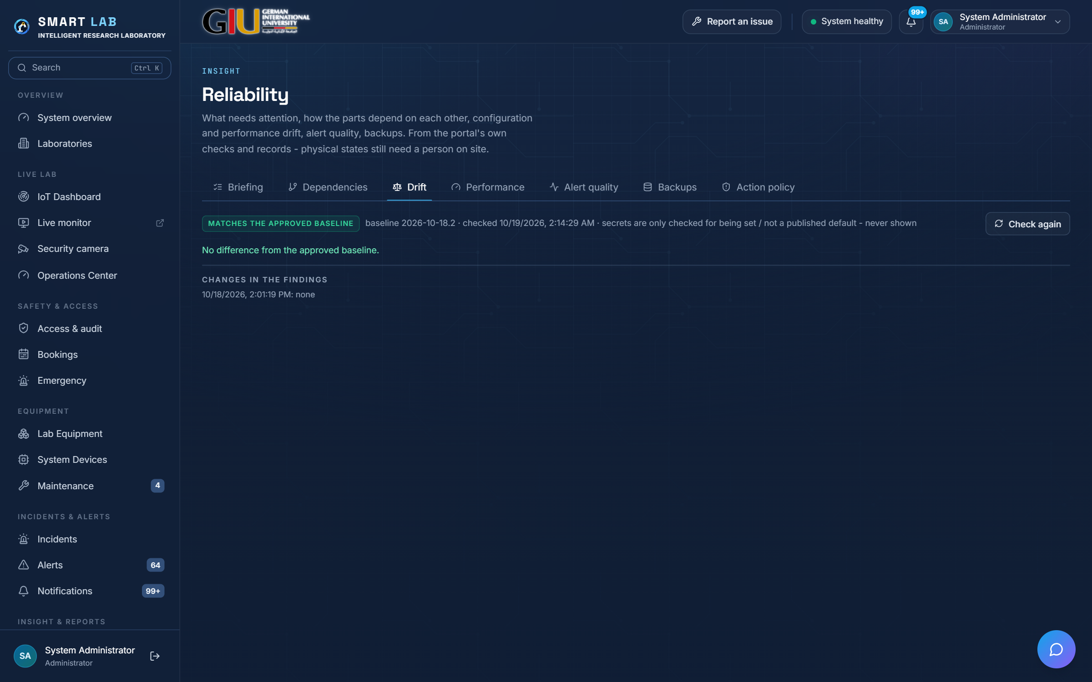
docs/paper_figures/portal_2026-10-19/25_reliability_drift.png
