aliloay/smart-lab-portal/docs/paper_figures/portal_2026-10-19/29_reliability_policy.png

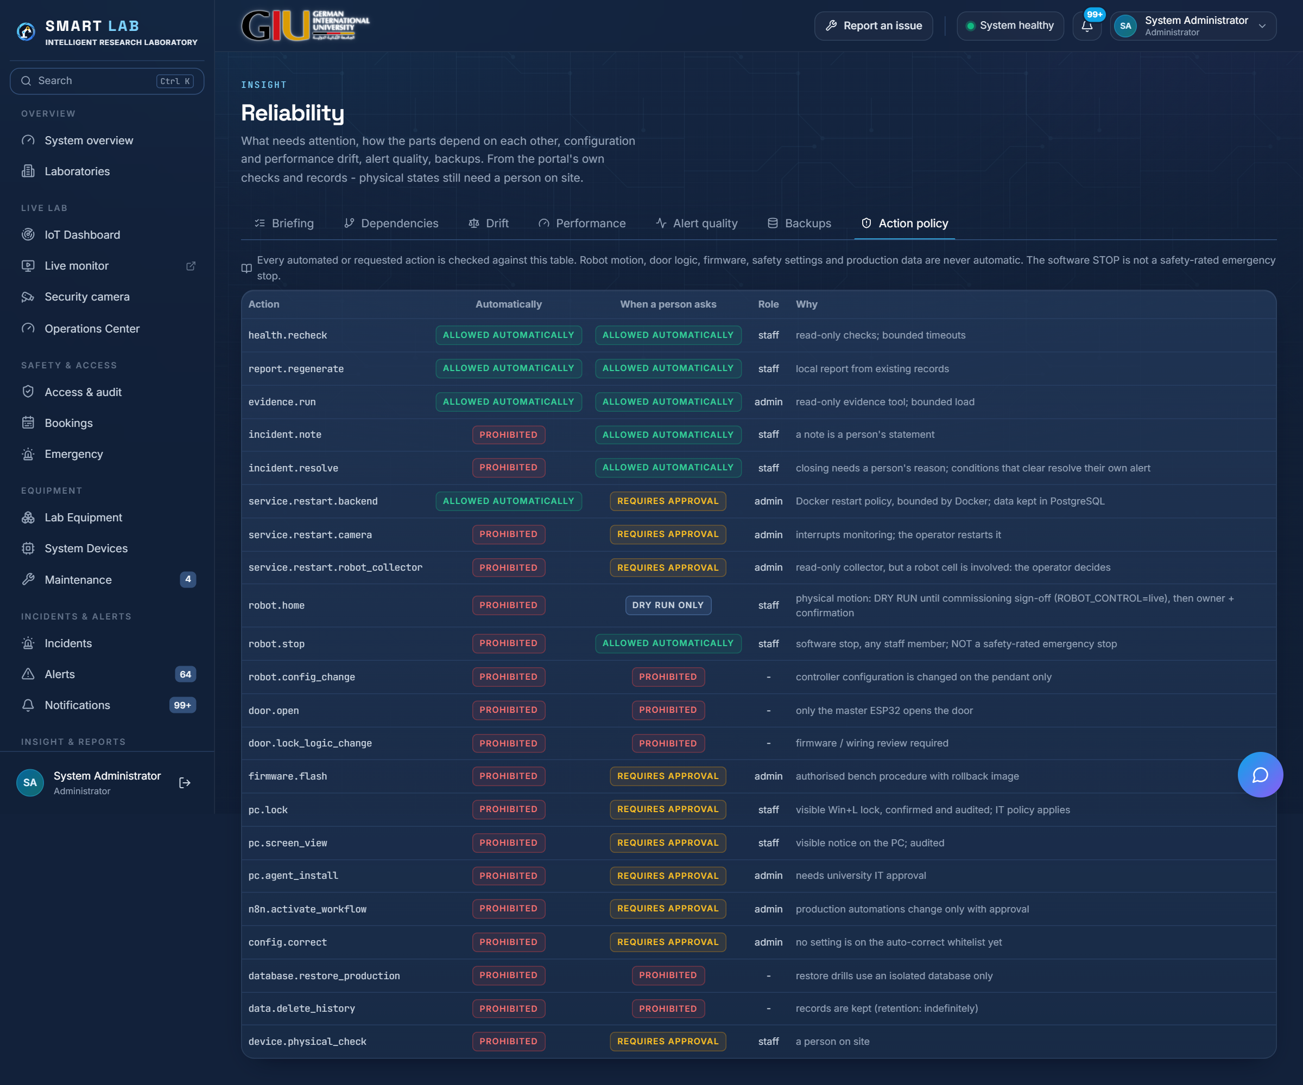
docs/paper_figures/portal_2026-10-19/29_reliability_policy.png
