aliloay/smart-lab-portal/docs/reports/dossier/enclosure_2026-10-20/DoorEnclosure_FitCoupon.png

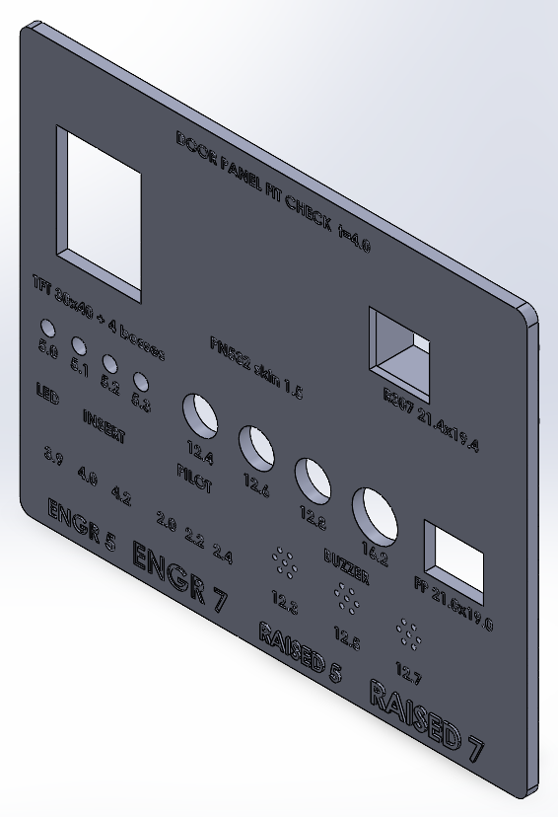
docs/reports/dossier/enclosure_2026-10-20/DoorEnclosure_FitCoupon.png
