aliloay/smart-lab-portal/docs/reports/dossier/enclosure_2026-10-20/DoorEnclosure_FrontPanel.png

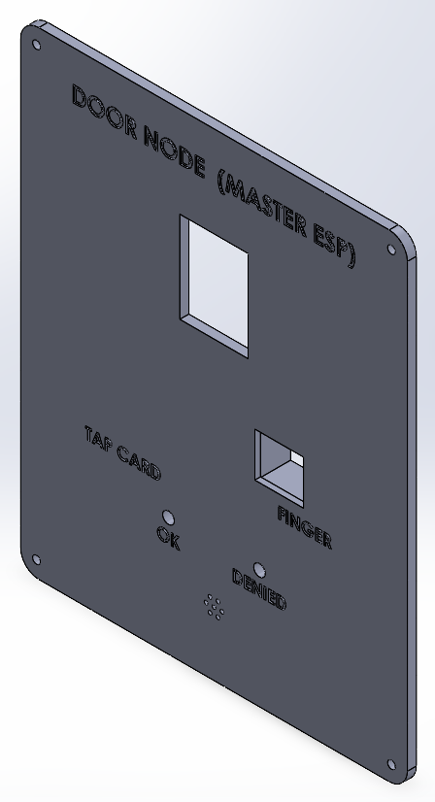
docs/reports/dossier/enclosure_2026-10-20/DoorEnclosure_FrontPanel.png
