aliloay/smart-lab-portal/docs/reports/dossier/enclosure_2026-10-20/sheet1.png

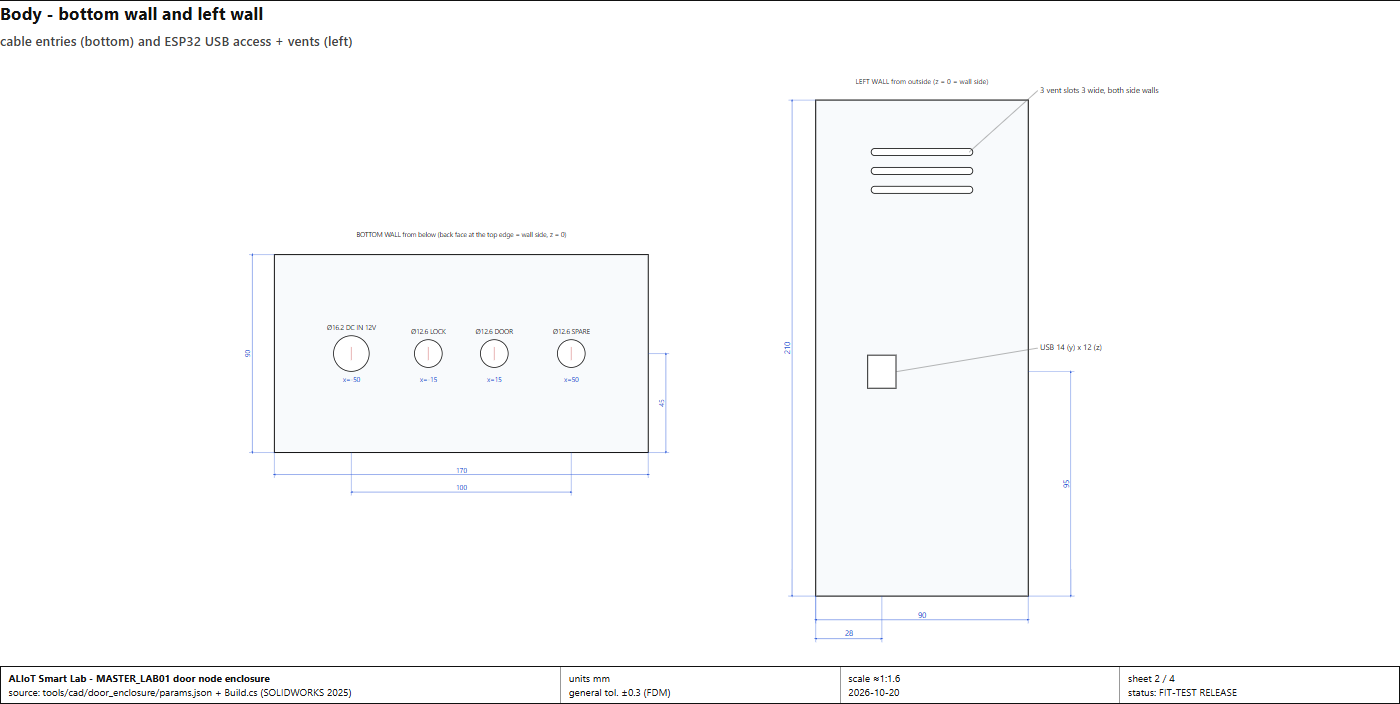
docs/reports/dossier/enclosure_2026-10-20/sheet1.png
