aliloay/smart-lab-portal/tools/cad/bin_enclosure/out/BinEnclosure_Body.png

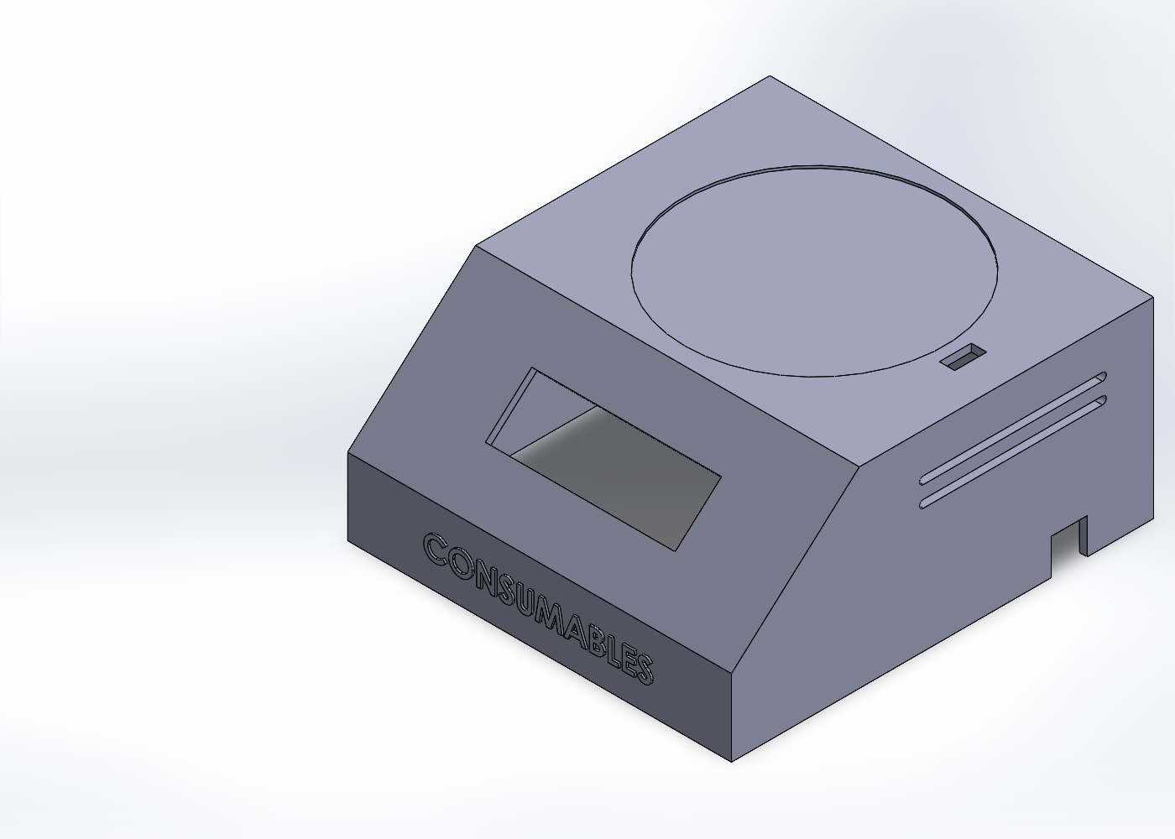
tools/cad/bin_enclosure/out/BinEnclosure_Body.png
