aliloay/smart-lab-portal/tools/cad/ctrl_enclosure/out/CtrlEnclosure_Body.png

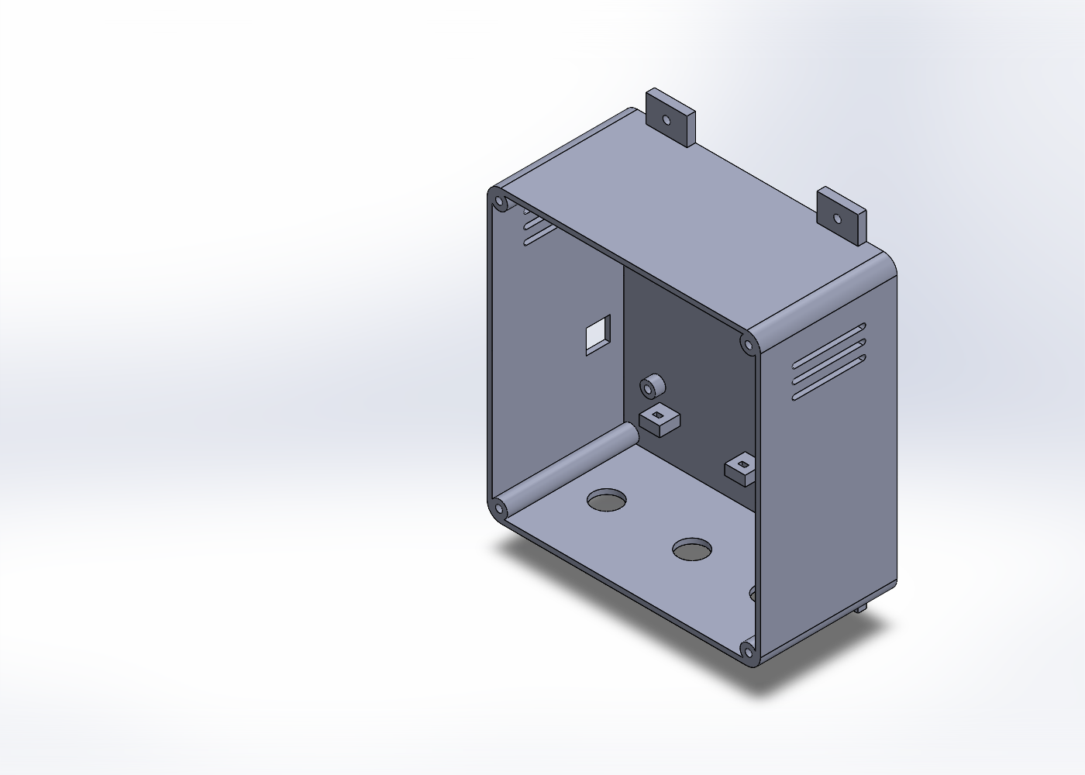
tools/cad/ctrl_enclosure/out/CtrlEnclosure_Body.png
