aliloay/smart-lab-portal/tools/cad/ctrl_enclosure/out/CtrlEnclosure_FrontPanel.png

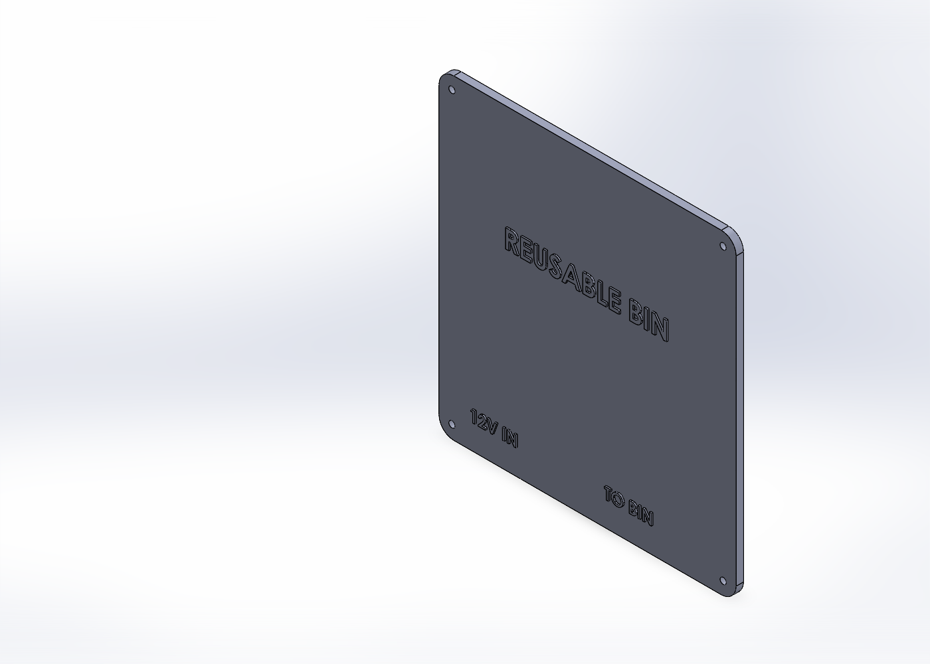
tools/cad/ctrl_enclosure/out/CtrlEnclosure_FrontPanel.png
