aliloay/smart-lab-portal/tools/cad/dock_enclosure/out/BinDock_PedalCover.png

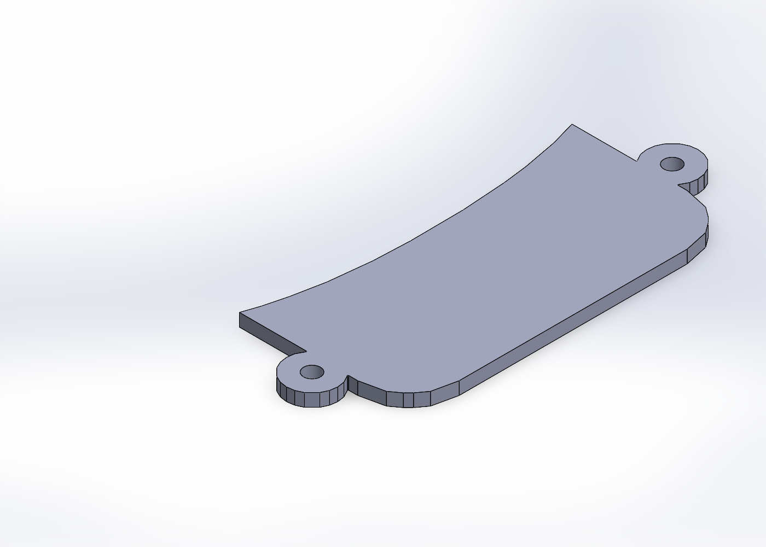
tools/cad/dock_enclosure/out/BinDock_PedalCover.png
