aliloay/smart-lab-portal/tools/cad/dock_enclosure/out/BinDock_Tray.png

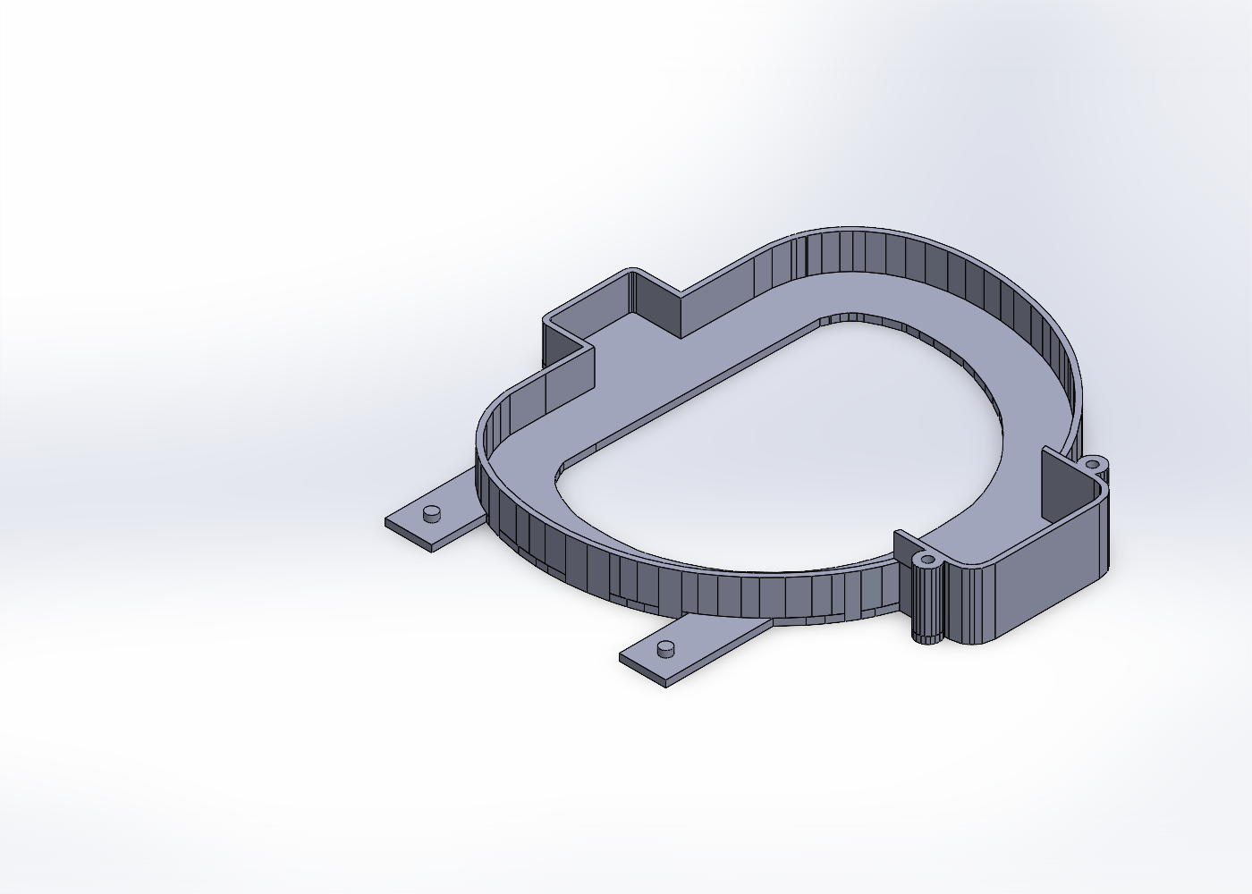
tools/cad/dock_enclosure/out/BinDock_Tray.png
