aliloay/smart-lab-portal/tools/cad/release_2026-10-25/2_Environment.jpg

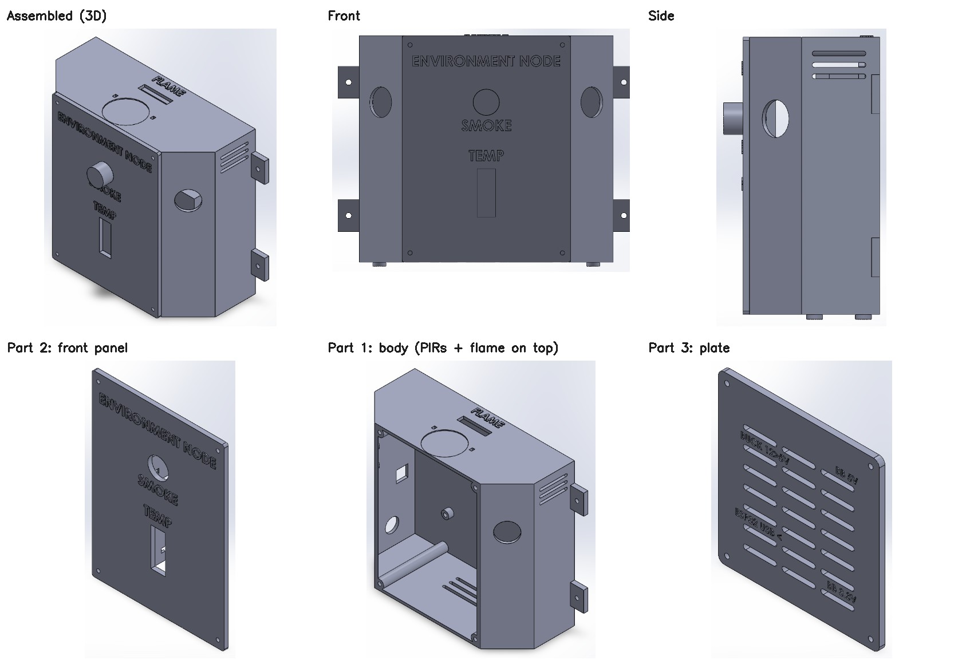
tools/cad/release_2026-10-25/2_Environment.jpg
