aliloay/smart-lab-portal/tools/cad/release_2026-10-25/3_ConsumablesBin.jpg

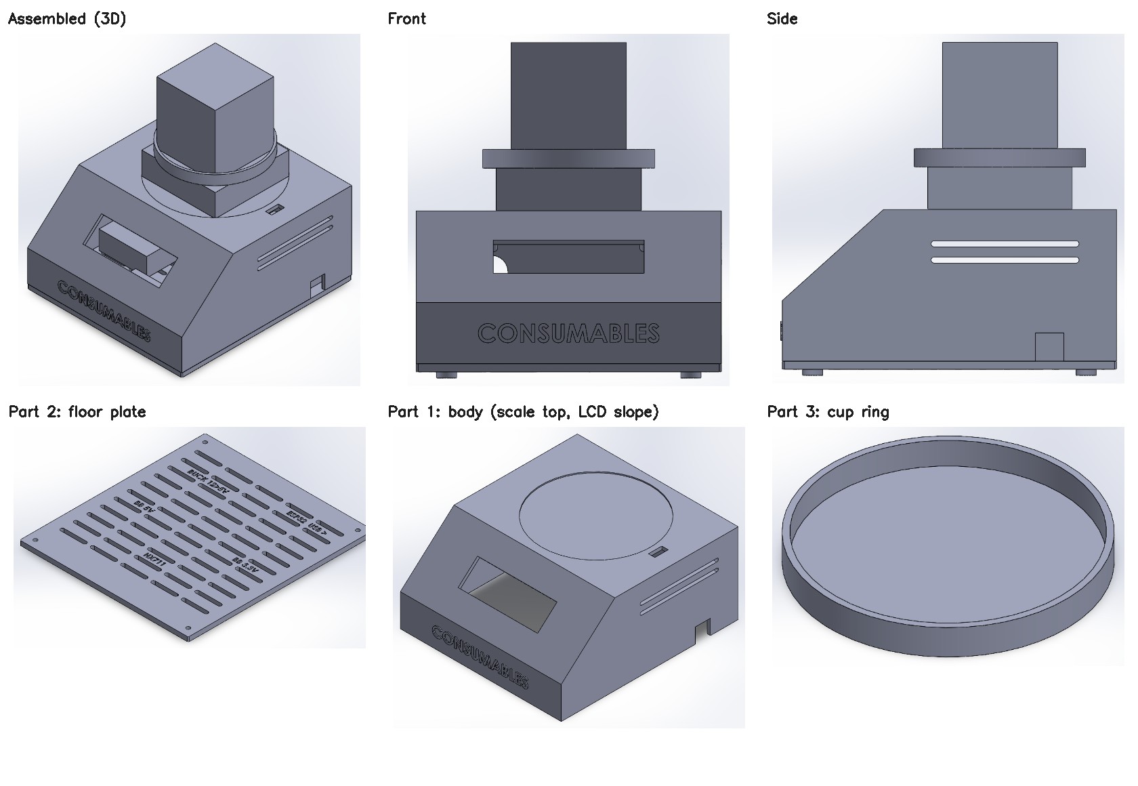
tools/cad/release_2026-10-25/3_ConsumablesBin.jpg
