aliloay/smart-lab-portal/docs/automation/workflow-inventory.md

# n8n workflow inventory

n8n is the **workflow orchestration layer**. It runs locally (`docker compose`, service `n8n`, bound to 127.0.0.1:5678) and only starts when `AUTOMATION_WEBHOOK_BASE` is set in `.env`. Every workflow is thin: n8n supplies the schedule or webhook trigger and the hand-off, while the **backend makes every decision** (`backend/app/api/routes/automation.py`). n8n does not do computer vision, access control or door decisions.

## How the pieces fit

1. A trigger fires (schedule or webhook from the backend).
2. n8n calls a backend automation endpoint, which evaluates the rule against the database and returns findings.
3. n8n splits the findings and posts each one to `/api/automation/notify` (in-portal notifications, e-mail when configured).
4. n8n records the run at `/api/automation/runs`, so the portal shows when each workflow last ran and what it found.

Requests carry the automation key from the n8n environment (`AUTOMATION_API_KEY`, set in `.env`); no credential is stored in the exported JSON.

## Files

| Path | Purpose |
|---|---|
| `automation/n8n/json/*.json` | The 23 workflow exports (import into n8n: Workflows → Import from file) |
| `automation/n8n/gen.py`, `build_json.mjs`, `src/` | Generators that produce the JSON from one definition |
| `automation/n8n/export_workflows.py` | Exports the live workflows back to JSON (read-only against n8n) |
| `automation/n8n/test-automation.ps1`, `test_automation.bat` | Calls the backend endpoints the workflows use |

## Workflow reference (generated from the exports, 9 Nov 2026)

`active` is the flag stored in the repo copy. The live n8n instance keeps its own activation state; check it in the n8n editor.

| File | Name | Trigger | Steps | Backend endpoints | Purpose (from the workflow note) | active in export |
|---|---|---|---|---|---|---|
| 01-booking-confirmation.json | Smart Lab 01 - Booking confirmation briefing | Webhook `smartlab-booking-confirmed` | Booking Confirmed Event → Get Booking Readiness → Lab Needs Heads-up? → Send Briefing To Student → Record Run | `/api/automation/notify`<br>`/api/automation/runs`<br>`=/api/automation/bookings/{{ $json.body.object.id }}` | Booking confirmation briefing The portal already confirms the booking. This adds a heads-up only when the lab is not in a normal state (controller offline, critical issue, equipment in maintenance). Readiness is decided  | False |
| 02-booking-reminders.json | Smart Lab 02 - Upcoming booking reminders | Every 5 min | Every 5 Minutes → Get Bookings Starting Soon → One Item Per Booking → Not Reminded Yet → Raise Reminder → Record Run | `/api/automation/bookings/upcoming?within_minutes=20`<br>`/api/automation/runs`<br>`=/api/automation/bookings/{{ $json.booking_id }}/remind` | Upcoming booking reminders Idempotent: the backend raises at most one reminder per booking - shared with the portal's own lazy reminder, so a retry or both paths firing never sends two. | False |
| 03-access-denial-intelligence.json | Smart Lab 03 - Access denial intelligence | Webhook `smartlab-access-denied` | Access Denied Event → Evaluate Denial Burst → Is It A Burst? → Raise Security Alert → Notify Staff → Record Run | `/api/automation/alerts`<br>`/api/automation/notify`<br>`/api/automation/runs`<br>`=/api/automation/access/denials{{ $json.body.lab_id ? "?lab_id=" + $json.body.lab_id : "" }}` | Access denial intelligence 1 refusal = normal (early, wrong code). 3 within 10 min = warning (thresholds in backend config). One alert per burst via dedupe key.  This workflow NEVER locks or unlocks anything - the door d | False |
| 04-device-offline-escalation.json | Smart Lab 04 - Device offline alert with escalation | Webhook `smartlab-device-offline`, Every 5 min | Device Offline Event → Get Offline Devices → One Item Per Device → Notify By Escalation Level → Record Run → Every 5 Minutes | `/api/automation/devices/offline`<br>`/api/automation/notify`<br>`/api/automation/runs` | Device offline escalation Level 1 at the stale threshold -> staff; level 2 at 15 min -> staff again; level 3 at 60 min -> administrators, critical. One notification per outage per level (dedupe key). The scheduled scan a | False |
| 05-maintenance-automation.json | Smart Lab 05 - Maintenance automation | Webhook `smartlab-issue-created`, Daily 8:00 | Issue Created Event → Get Issue Context → Urgent And Lab In Use? → Notify Staff Of Impact → Record Run → Daily 08:00 → Get Maintenance Digest → Anything Needs Attention? → Send Maintenance Digest | `/api/automation/maintenance`<br>`/api/automation/notify`<br>`/api/automation/runs`<br>`=/api/automation/issues/{{ $json.body.object.id }}` | Maintenance automation Event path: a HIGH/CRITICAL issue in a lab with bookings in the next 24 h is flagged to staff at once. Daily path: overdue (per published SLA), urgent unassigned, and equipment due for maintenance  | False |
| 06-daily-report.json | Smart Lab 06 - Daily lab report | Daily 20:00 | Daily 20:00 → Build Report In Backend → Send To Administrators → Record Run | `/api/automation/notify`<br>`/api/automation/reports/daily`<br>`/api/automation/runs` | Daily lab report The backend computes every figure from recorded rows (no estimates); n8n only schedules and delivers. Idempotent per day via dedupe key. Add an Email/Slack node in parallel to Send To Administrators for  | False |
| 07-weekly-report.json | Smart Lab 07 - Weekly lab report | Daily 7:00 | Mondays 07:00 → Build Report In Backend → Send To Administrators → Record Run | `/api/automation/notify`<br>`/api/automation/reports/weekly`<br>`/api/automation/runs` | Weekly lab report The backend computes every figure from recorded rows (no estimates), including the previous week for comparison; n8n only schedules and delivers. Idempotent per period via dedupe key. | False |
| 08-sensor-thresholds.json | Smart Lab 08 - Sensor threshold alerts | Every 10 min | Every 10 Minutes → Evaluate Sensors In Backend → One Item Per Breach → Raise Threshold Alert → Notify Staff → Record Run | `/api/automation/alerts`<br>`/api/automation/notify`<br>`/api/automation/runs`<br>`/api/automation/sensors/evaluate?max_age_minutes=30` | Sensor thresholds (configuration-driven) Thresholds live in backend SENSOR_THRESHOLDS (metric=min:max). Stale readings are never treated as OK. With no sensor node installed the backend returns no_data and this workflow  | False |
| 09-pre-booking-check.json | Smart Lab 09 - Pre-booking lab readiness check | Every 15 min | Every 15 Minutes → Get Bookings In Next Hour → One Item Per Booking → Lab Not Ready → Warn Student → Warn Staff → Record Run | `/api/automation/bookings/upcoming?within_minutes=60`<br>`/api/automation/notify`<br>`/api/automation/runs` | Pre-booking check Warns the student and staff when a lab is not ready (controller offline, critical issue). It never cancels or changes a booking. | False |
| 10-post-session.json | Smart Lab 10 - Post-session follow-up | Every 30 min | Every 30 Minutes → Get Bookings That Just Ended → One Item Per Booking → Send Follow-up → Record Run | `/api/automation/bookings/ended?minutes=60`<br>`/api/automation/notify`<br>`/api/automation/runs` | Post-session Attended: summary, and says 'exit not recorded' honestly when no exit was observed. Missed: a gentle no-show note. Text is composed by the backend. | False |
| 11-data-quality.json | Smart Lab 11 - Daily data quality check | Daily 6:00 | Daily 06:00 → Run Checks In Backend → Any Check Failing? → Notify Administrators → Record Run | `/api/automation/data-quality`<br>`/api/automation/notify`<br>`/api/automation/runs` | Data quality Read-only consistency checks (stale sessions, entries on cancelled bookings, unattributed events, devices never reporting, implausible sensor values...). Nothing is modified - a human decides. | False |
| 12-anomaly-detection.json | Smart Lab 12 - Rule-based anomaly detection | Every 1 h | Every Hour → Run Anomaly Rules → One Item Per Anomaly → Notify Staff → Record Run | `/api/automation/anomalies?hours=24`<br>`/api/automation/notify`<br>`/api/automation/runs` | Rule-based anomaly detection Explainable rules only, evaluated in the backend: denial bursts, repeated identity mismatch, after-hours access, forced entry / door held open, device flapping, refusals far above the lab's o | False |
| 13-environment-hazard-escalation.json | Smart Lab 13 - Environment hazard escalation | Every 5 min | Every 5 Minutes → Check In Backend → One Item Per Finding → Notify Staff → Record Run | `/api/automation/notify`<br>`/api/automation/robotics/hazards`<br>`/api/automation/runs` | Environment hazard escalation The backend alerts at once when smoke, flame, a leak or the emergency signal is reported; this re-notifies when it is still active after 5 min. Indicators only - not a certified fire or safe | False |
| 14-node-offline.json | Smart Lab 14 - Environment / bin node offline | Every 15 min | Every 15 Minutes → Check In Backend → One Item Per Finding → Notify Staff → Record Run | `/api/automation/notify`<br>`/api/automation/robotics/env-offline`<br>`/api/automation/runs` | Environment / bin node offline A sensor or bin node stopped sending heartbeats - its readings are stale, never shown as current. | False |
| 15-low-stock.json | Smart Lab 15 - Consumable below reorder level | Every 1 h | Every Hour → Check In Backend → One Item Per Finding → Notify Staff → Record Run | `/api/automation/notify`<br>`/api/automation/robotics/low-stock`<br>`/api/automation/runs` | Consumable below reorder level Estimated quantity at or below the bin's reorder level. Only calibrated bins are estimated. | False |
| 16-unattended-stock-change.json | Smart Lab 16 - Stock change with nobody inside | Every 1 h | Every Hour → Check In Backend → One Item Per Finding → Notify Staff → Record Run | `/api/automation/notify`<br>`/api/automation/robotics/unattended-stock`<br>`/api/automation/runs` | Stock change with nobody inside A withdrawal recorded while no access session was open. A record to check, never an accusation. | False |
| 17-asset-overdue.json | Smart Lab 17 - Reusable item overdue | Every 1 h | Every Hour → Check In Backend → One Item Per Finding → Notify Staff → Record Run | `/api/automation/notify`<br>`/api/automation/robotics/assets-overdue`<br>`/api/automation/runs` | Reusable item overdue A smart-bin item checked out for more than 24 h. | False |
| 18-robot-offline-fault.json | Smart Lab 18 - Robot offline or fault | Every 5 min | Every 5 Minutes → Check In Backend → One Item Per Finding → Notify Staff → Record Run | `/api/automation/notify`<br>`/api/automation/robotics/robots`<br>`/api/automation/runs` | Robot offline or fault From the read-only collector: the robot stopped reporting or reported a fault. Nothing commands the robot. | False |
| 19-robot-without-booking.json | Smart Lab 19 - Robot running without a booking | Every 15 min | Every 15 Minutes → Check In Backend → One Item Per Finding → Notify Staff → Record Run | `/api/automation/notify`<br>`/api/automation/robotics/robot-unbooked`<br>`/api/automation/runs` | Robot running without a booking The robot entered RUNNING with no booking in force for its lab. | False |
| 20-pc-offline.json | Smart Lab 20 - Lab PC offline | Every 15 min | Every 15 Minutes → Check In Backend → One Item Per Finding → Notify Staff → Record Run | `/api/automation/notify`<br>`/api/automation/robotics/pcs-offline`<br>`/api/automation/runs` | Lab PC offline A lab PC agent stopped reporting. | False |
| 21-exam-violations.json | Smart Lab 21 - Exam-mode reports | Every 5 min | Every 5 Minutes → Check In Backend → One Item Per Finding → Notify Staff → Record Run | `/api/automation/notify`<br>`/api/automation/robotics/exam-violations`<br>`/api/automation/runs` | Exam-mode reports Programs the PC agent saw running in exam mode. Staff decide what a report means; nothing is automatic. | False |
| 22-robotics-daily.json | Smart Lab 22 - Robotics Lab daily summary | Daily 7:00 | Daily 07:00 → Check In Backend → One Item Per Finding → Notify Staff → Record Run | `/api/automation/notify`<br>`/api/automation/robotics/daily`<br>`/api/automation/runs` | Robotics Lab daily summary Robot run time, consumable withdrawals, items out, environment alerts - from recorded data only. | False |
| 23-emergency.json | Smart Lab 23 - Emergency: warn people inside, check the door | Webhook `smartlab-emergency-set` | Emergency Set → Get Emergency State → One Item Per Person Inside → Warn Person Inside → Give The Door 30 s → Check Door Applied It → Door Has Not Applied It? → Alert Admins → Record Run | `/api/automation/notify`<br>`/api/automation/runs`<br>`=/api/automation/emergency/{{ $json.body.lab_id }}`<br>`=/api/automation/emergency/{{ $json.lab_id }}` | Emergency Set by an admin in the Emergency tab. 1) Everyone INSIDE that lab gets a notice telling them what to do (leave / lockdown / the admin's message). 2) After 30 s: if the door controller has not confirmed the new  | False |

## Verification status

- The exports parse as JSON and reference only backend endpoints that exist in `automation.py` (checked by name, 9 Nov 2026).
- `backend/tests` covers the automation endpoints (`test_automation.py`).
- End-to-end runs against the live n8n are recorded in docs/N8N_RECOVERY_2026-10-14.md; they were not re-run for this release (the live n8n is never edited, activated or deactivated from scripts).
