aliloay/smart-lab-portal/tools/cad/bin_enclosure/out/BinEnclosure_Assembly.STEP

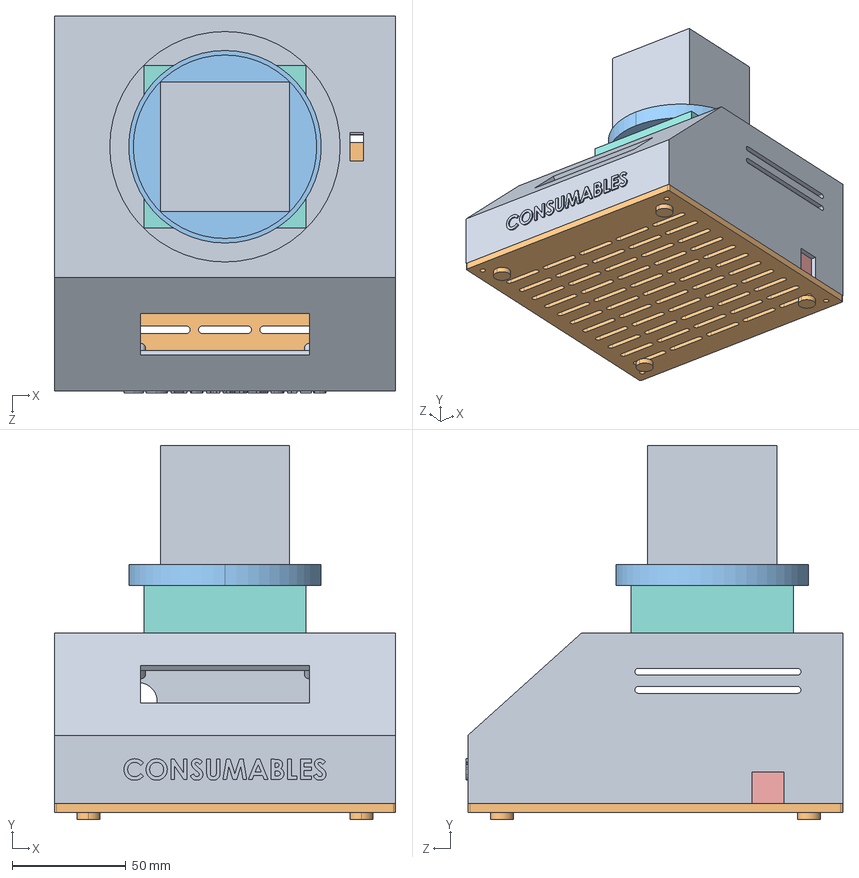
[picture p55: CAD file, 2026-11-10]
tools/cad/bin_enclosure/out/BinEnclosure_Assembly.STEP
150.0 x 164.5 x 165.8 mm
BinEnclosure_Body
BinEnclosure_Floor
BinEnclosure_CupRing
Env_buck
Env_esp32
Env_bb_5v
Env_bb_3v3
Env_hx711
Env_scale
Env_cup
