aliloay/smart-lab-portal/tools/cad/ctrl_enclosure/out/CtrlEnclosure_Assembly.SLDASM

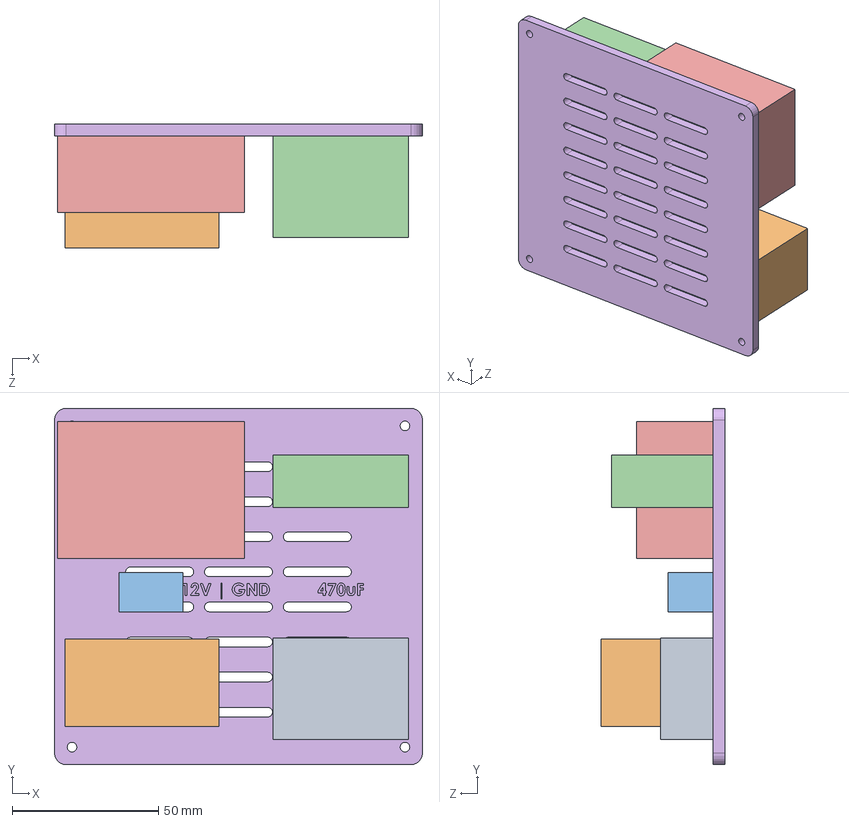
[picture p56: CAD file, 2026-11-10]
tools/cad/ctrl_enclosure/out/CtrlEnclosure_Assembly.SLDASM
126.0 x 122.0 x 42.3 mm
CtrlEnclosure_ElectronicsPlate
Env_buck
Env_bb_5v
Env_wago1
Env_esp32
Env_bb_3v3
