aliloay/smart-lab-portal/tools/cad/door_enclosure/DoorEnclosure_FitTestRelease_2026-10-20/DoorEnclosure_Assembly.SLDASM

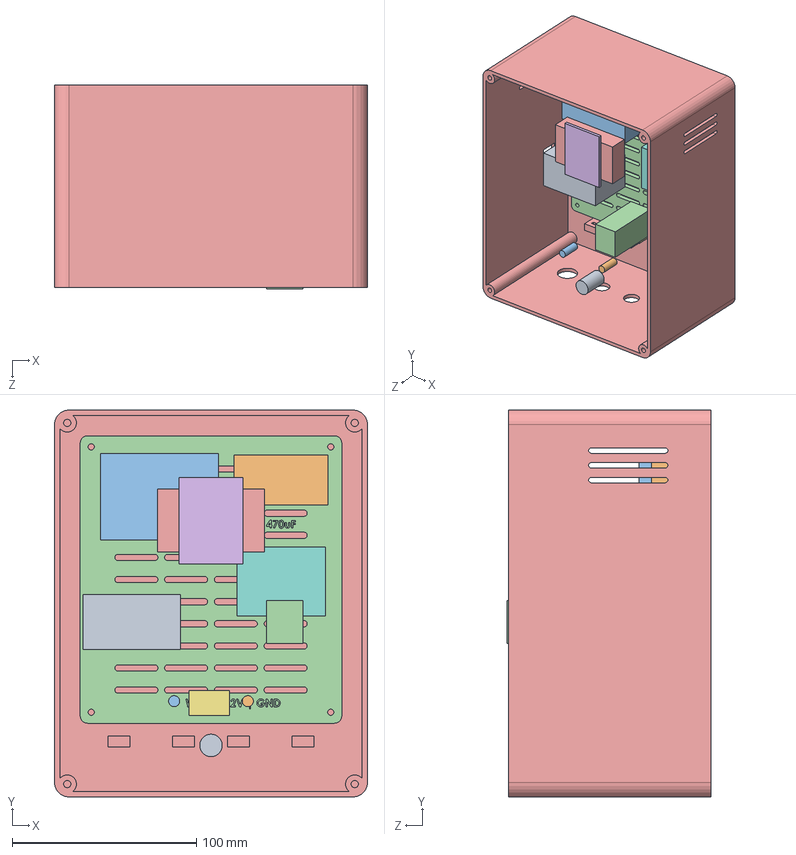
[picture p57: CAD file, 2026-11-10]
tools/cad/door_enclosure/DoorEnclosure_FitTestRelease_2026-10-20/DoorEnclosure_Assembly.SLDASM
170.0 x 210.0 x 110.9 mm
DoorEnclosure_Body
DoorEnclosure_ElectronicsPlate
Env_buck
Env_relay
Env_esp32
Env_driver_bb
Env_wago1
Env_tft_glass
Env_tft_pcb
Env_fp
Env_led_g
Env_led_r
Env_buzzer
