aliloay/smart-lab-portal/tools/cad/door_enclosure/out_final_2026-10-24/DoorEnclosure_Assembly.STEP

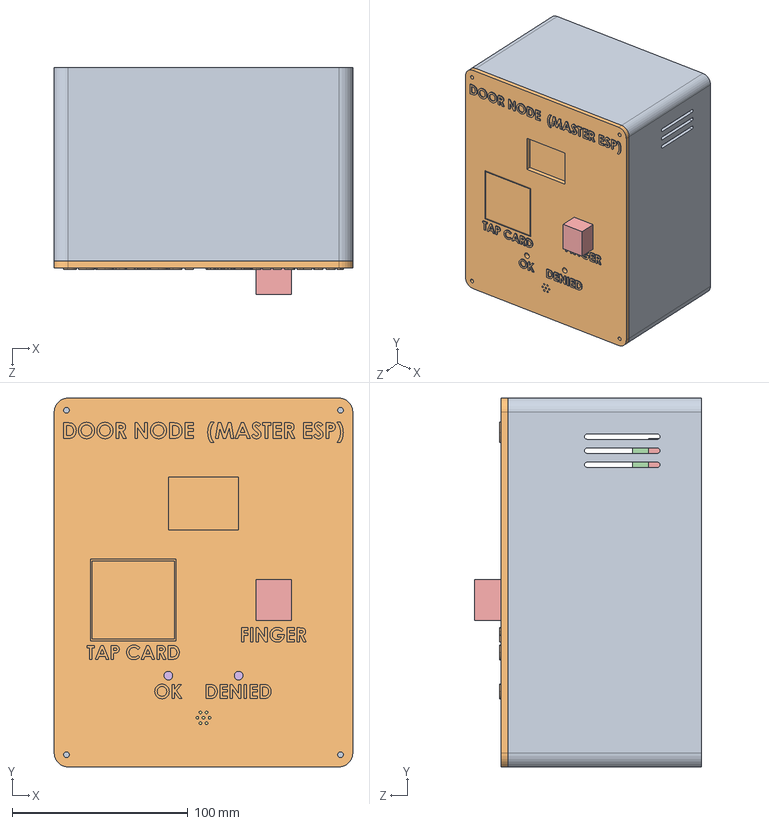
[picture p58: CAD file, 2026-11-10]
tools/cad/door_enclosure/out_final_2026-10-24/DoorEnclosure_Assembly.STEP
170.0 x 210.0 x 129.0 mm
DoorEnclosure_Body
DoorEnclosure_FrontPanel
DoorEnclosure_ElectronicsPlate
Env_buck
Env_relay
Env_cap
Env_esp32
Env_driver_bb
Env_wago1
Env_wago2
Env_tft_glass
Env_tft_pcb
Env_nfc
Env_fp
Env_led_g
Env_led_r
Env_buzzer
