aliloay/smart-lab-portal/tools/cad/door_enclosure/out_final_2026-10-24_cam/DoorEnclosure_Assembly.SLDASM

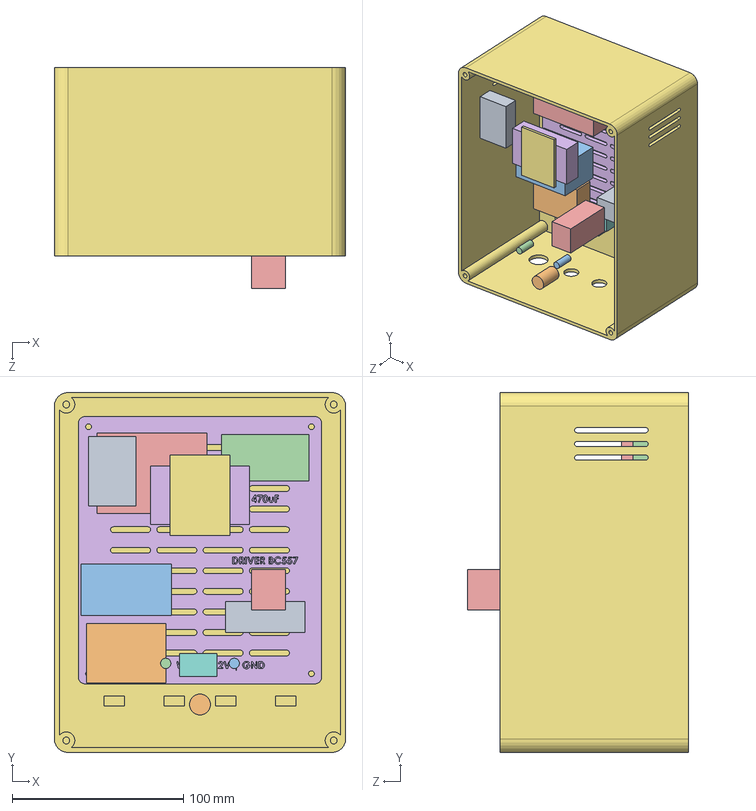
[picture p59: CAD file, 2026-11-10]
tools/cad/door_enclosure/out_final_2026-10-24_cam/DoorEnclosure_Assembly.SLDASM
170.0 x 210.0 x 129.0 mm
DoorEnclosure_Body
DoorEnclosure_ElectronicsPlate
Env_buck
Env_relay
Env_esp32
Env_bb_3v3
Env_bb_5v
Env_wago1
Env_tft_glass
Env_tft_pcb
Env_fp
Env_led_g
Env_led_r
Env_buzzer
Env_esp32cam
