aliloay/smart-lab-portal/tools/cad/door_enclosure_tol_backup_2026-10-21/owner_saved/DoorEnclosure_Assembly.SLDASM

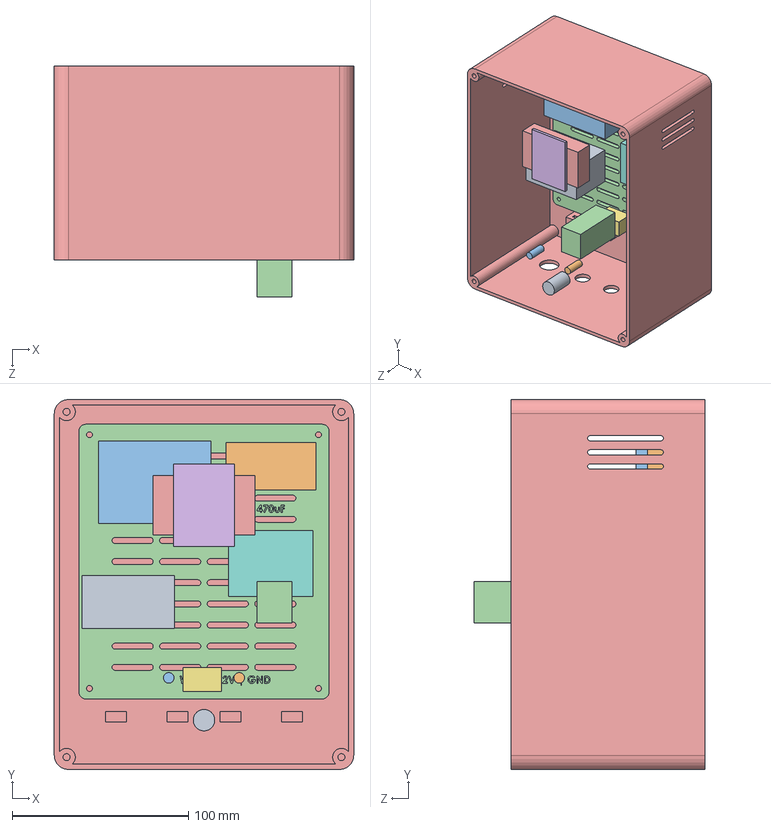
[picture p60: CAD file, 2026-11-10]
tools/cad/door_enclosure_tol_backup_2026-10-21/owner_saved/DoorEnclosure_Assembly.SLDASM
170.0 x 210.0 x 130.9 mm
DoorEnclosure_Body
DoorEnclosure_ElectronicsPlate
Env_buck
Env_relay
Env_esp32
Env_driver_bb
Env_wago1
Env_tft_glass
Env_tft_pcb
Env_fp
Env_led_g
Env_led_r
Env_buzzer
