aliloay/smart-lab-portal/tools/cad/dock_enclosure/out/BinDock_Assembly.SLDASM

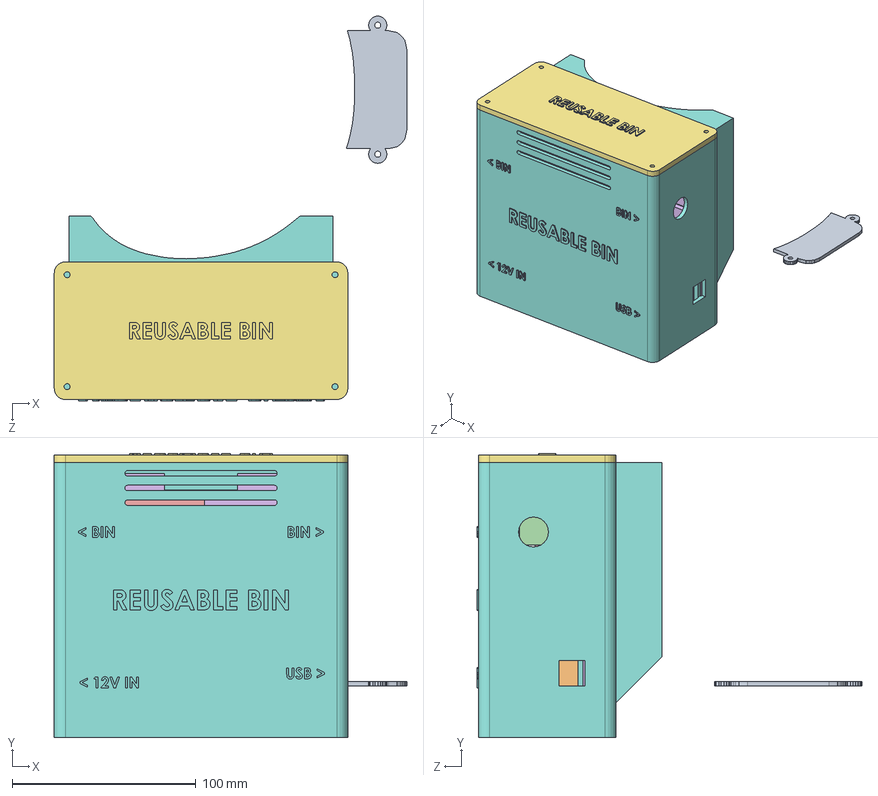
[picture p61: CAD file, 2026-11-10]
tools/cad/dock_enclosure/out/BinDock_Assembly.SLDASM
192.1 x 154.8 x 209.8 mm
BinDock_PedalCover
BinDock_Body
BinDock_Lid
BinDock_ElectronicsPlate
Env_buck
Env_bb_5v
Env_wago1
Env_esp32
Env_bb_3v3
