aliloay/smart-lab-portal/tools/cad/bin_enclosure/out/envelopes/Env_bb_5v.SLDPRT

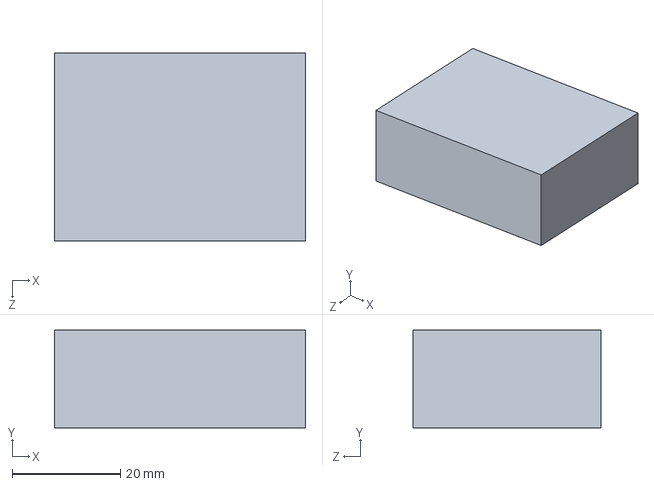
[picture p62: CAD file, 2026-11-10]
tools/cad/bin_enclosure/out/envelopes/Env_bb_5v.SLDPRT
46.3 x 18.0 x 34.7 mm
