aliloay/smart-lab-portal/tools/cad/dock_enclosure/out/BinDock_Body.SLDPRT

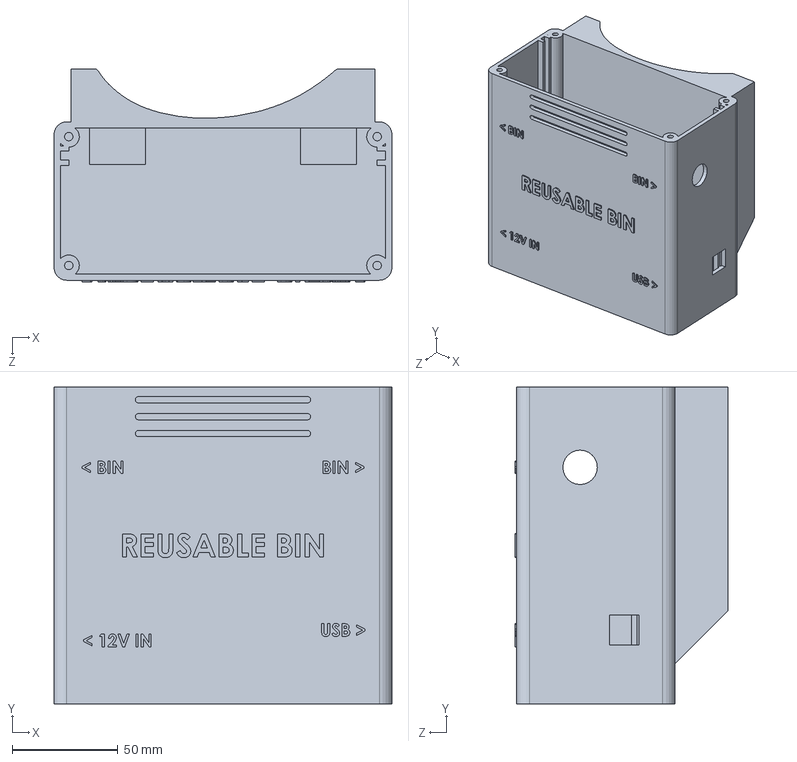
[picture p63: CAD file, 2026-11-10]
tools/cad/dock_enclosure/out/BinDock_Body.SLDPRT
160.0 x 150.0 x 100.8 mm
