aliloay/smart-lab-portal/tools/cad/dock_enclosure/out/envelopes/Env_buck.SLDPRT

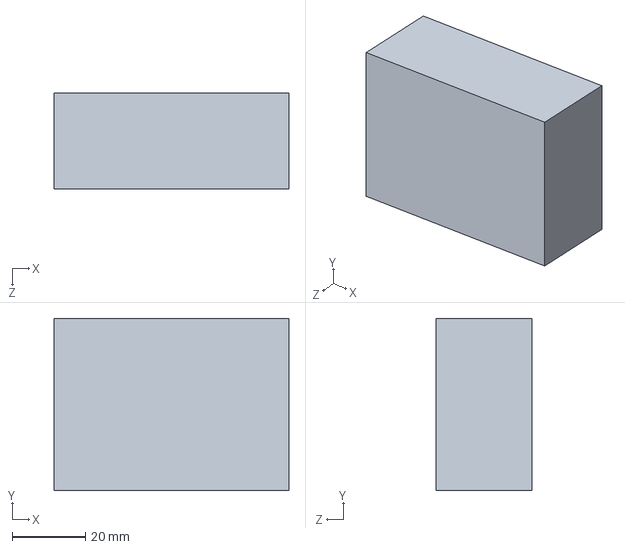
[picture p64: CAD file, 2026-11-10]
tools/cad/dock_enclosure/out/envelopes/Env_buck.SLDPRT
64.0 x 46.9 x 26.2 mm
