aliloay/smart-lab-portal/tools/cad/door_enclosure/DoorEnclosure_FitTestRelease_2026-10-20/DoorEnclosure_FrontPanel.STEP

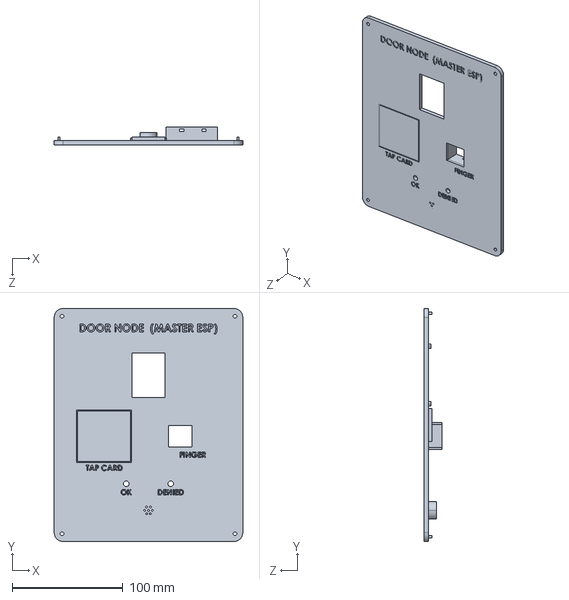
[picture p65: CAD file, 2026-11-10]
tools/cad/door_enclosure/DoorEnclosure_FitTestRelease_2026-10-20/DoorEnclosure_FrontPanel.STEP
170.0 x 210.0 x 16.0 mm
