aliloay/smart-lab-portal/tools/cad/door_enclosure/DoorEnclosure_FitTestRelease_2026-10-20/envelopes/Env_driver_bb.SLDPRT

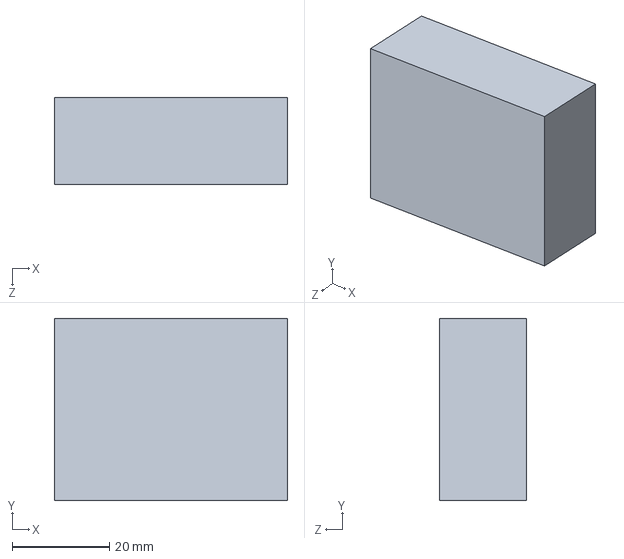
[picture p66: CAD file, 2026-11-10]
tools/cad/door_enclosure/DoorEnclosure_FitTestRelease_2026-10-20/envelopes/Env_driver_bb.SLDPRT
48.0 x 37.5 x 18.0 mm
