aliloay/smart-lab-portal/tools/cad/door_enclosure/out_final_2026-10-24/DoorEnclosure_ElectronicsPlate.STEP

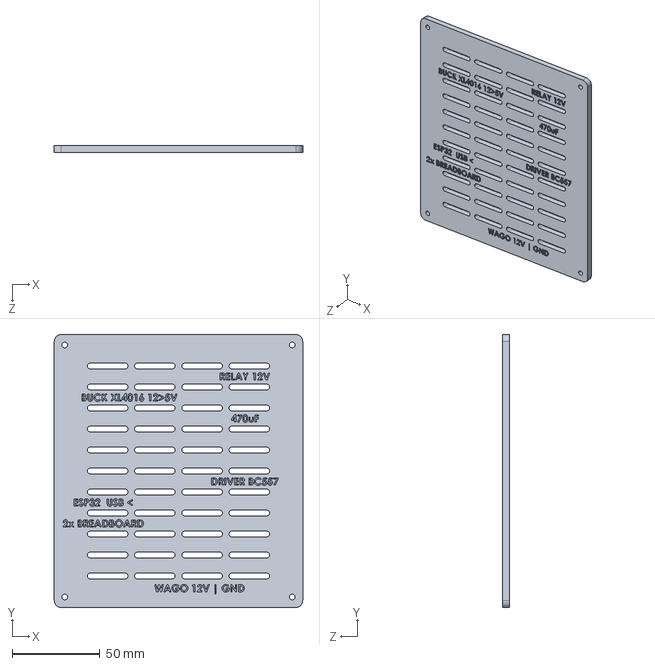
[picture p67: CAD file, 2026-11-10]
tools/cad/door_enclosure/out_final_2026-10-24/DoorEnclosure_ElectronicsPlate.STEP
142.0 x 156.0 x 4.00 mm
