aliloay/smart-lab-portal/tools/cad/door_enclosure/out_final_2026-10-24/envelopes/Env_led_r.SLDPRT

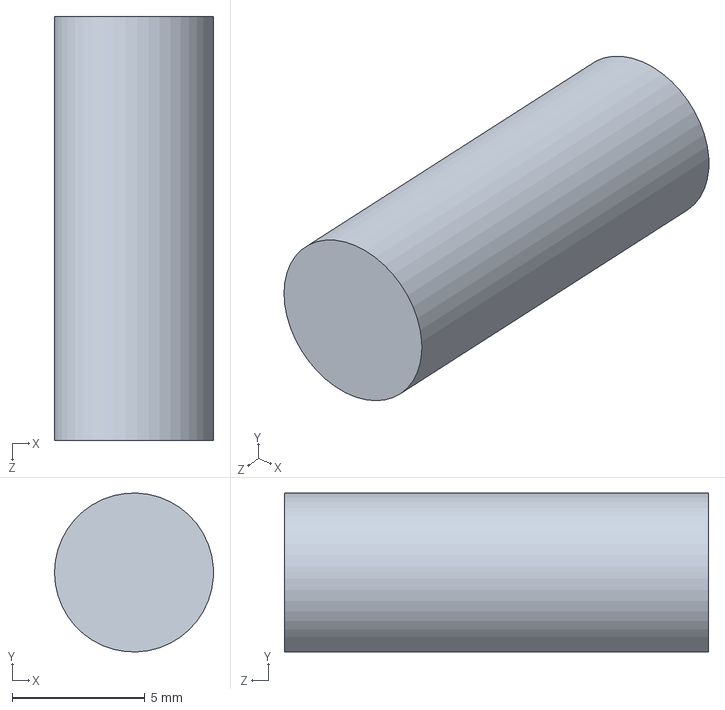
[picture p68: CAD file, 2026-11-10]
tools/cad/door_enclosure/out_final_2026-10-24/envelopes/Env_led_r.SLDPRT
6.00 x 6.00 x 16.0 mm
