aliloay/smart-lab-portal/tools/cad/door_enclosure/out_final_2026-10-24_cam/DoorEnclosure_FrontPanel.STEP

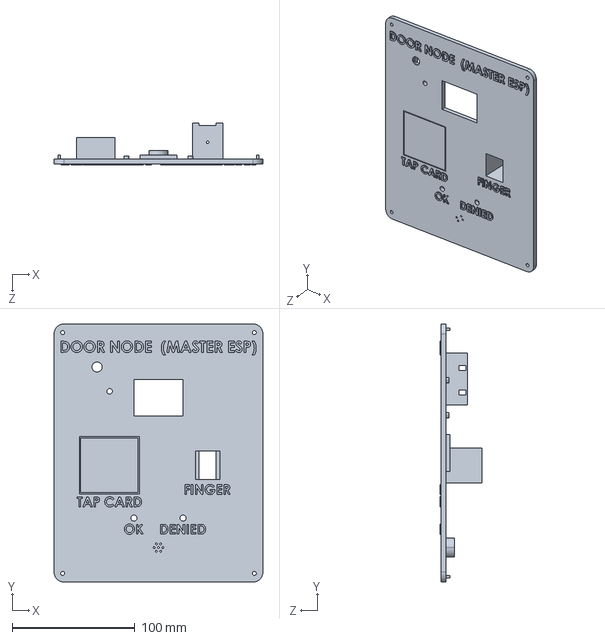
[picture p69: CAD file, 2026-11-10]
tools/cad/door_enclosure/out_final_2026-10-24_cam/DoorEnclosure_FrontPanel.STEP
170.0 x 210.0 x 33.9 mm
