aliloay/smart-lab-portal/tools/cad/door_enclosure/out_final_2026-10-24_cam/envelopes/Env_esp32cam.SLDPRT

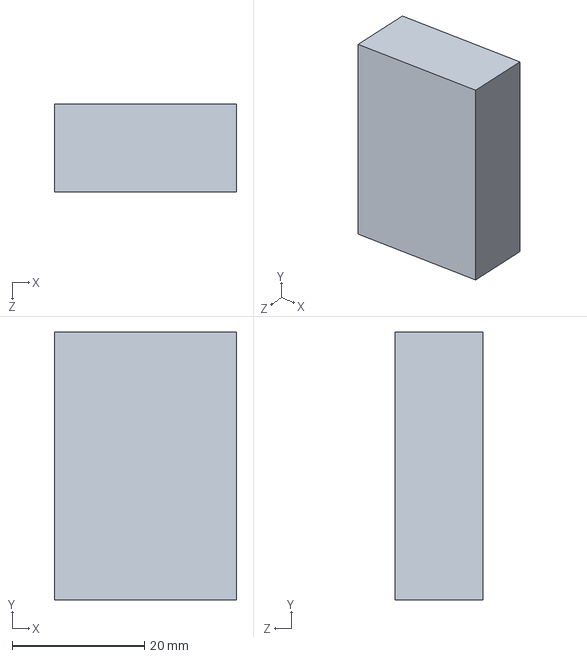
[picture p70: CAD file, 2026-11-10]
tools/cad/door_enclosure/out_final_2026-10-24_cam/envelopes/Env_esp32cam.SLDPRT
27.6 x 40.5 x 13.3 mm
