aliloay/smart-lab-portal/tools/cad/door_enclosure/out_owner_backup_2026-10-24/DoorEnclosure_Body.SLDPRT

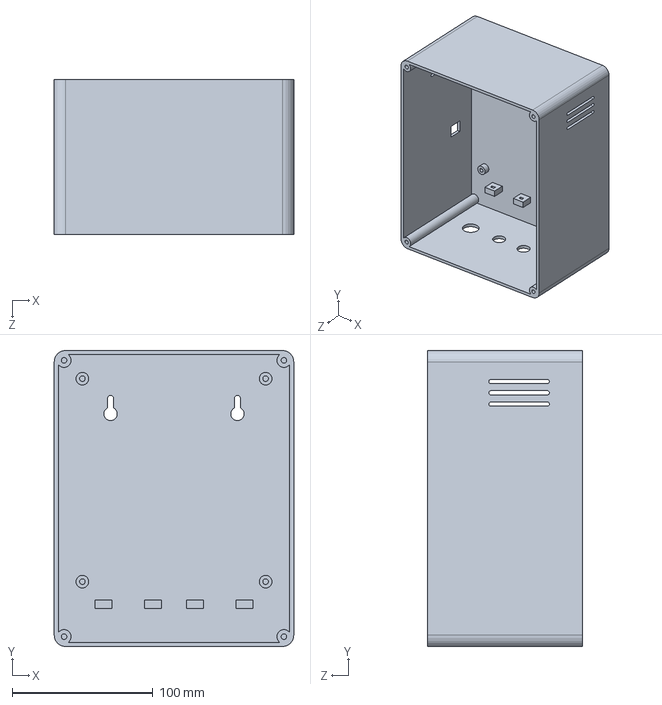
[picture p71: CAD file, 2026-11-10]
tools/cad/door_enclosure/out_owner_backup_2026-10-24/DoorEnclosure_Body.SLDPRT
170.0 x 210.0 x 110.0 mm
