aliloay/smart-lab-portal/tools/cad/door_enclosure_tol_backup_2026-10-21/owner_saved/envelopes/Env_tft_glass.SLDPRT

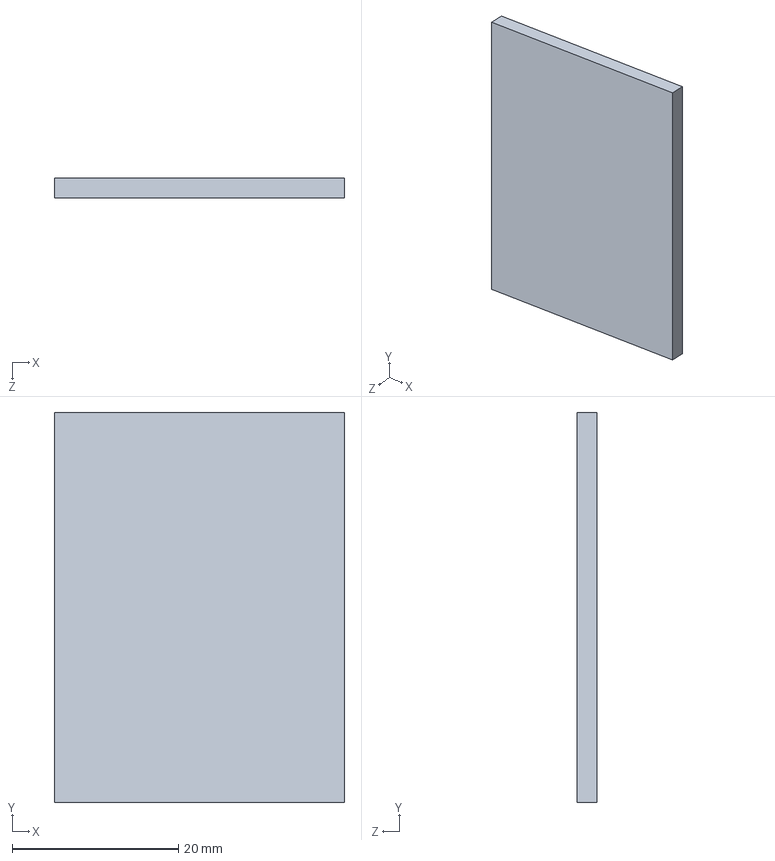
[picture p72: CAD file, 2026-11-10]
tools/cad/door_enclosure_tol_backup_2026-10-21/owner_saved/envelopes/Env_tft_glass.SLDPRT
34.9 x 46.9 x 2.40 mm
