aliloay/smart-lab-portal/tools/cad/env_enclosure/out/envelopes/Env_mq_can.SLDPRT

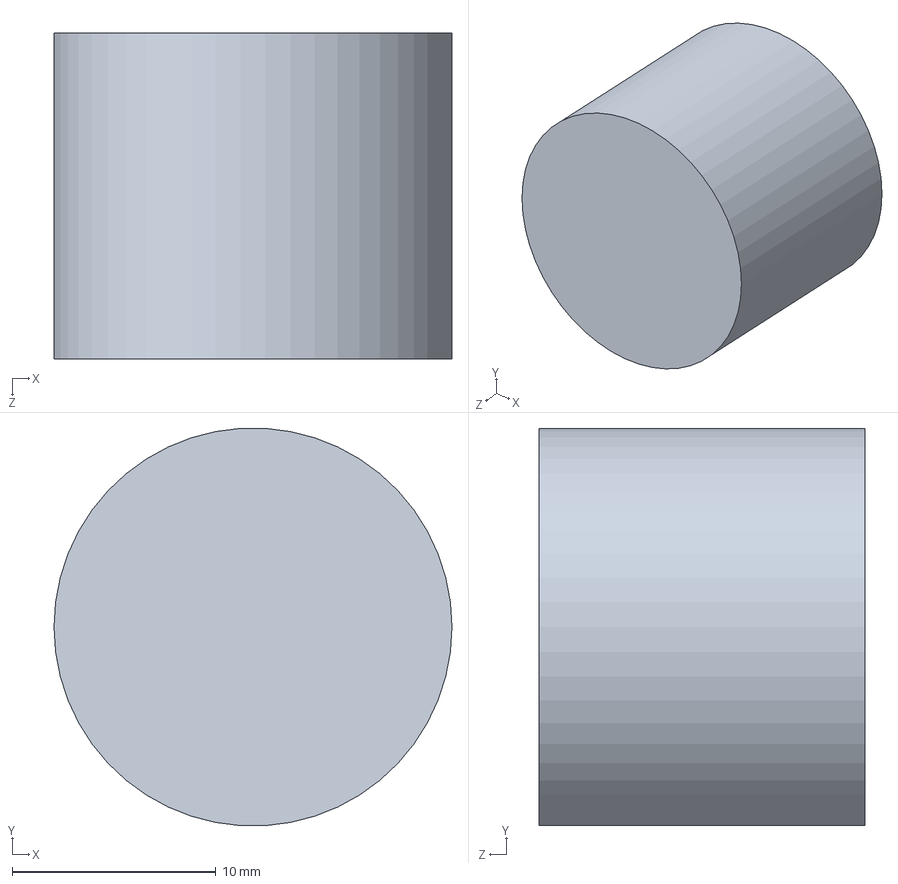
[picture p73: CAD file, 2026-11-10]
tools/cad/env_enclosure/out/envelopes/Env_mq_can.SLDPRT
19.5 x 19.5 x 16.0 mm
