aliloay/smart-lab-portal/tools/cad/env_enclosure/out/EnvEnclosure_Body.SLDPRT

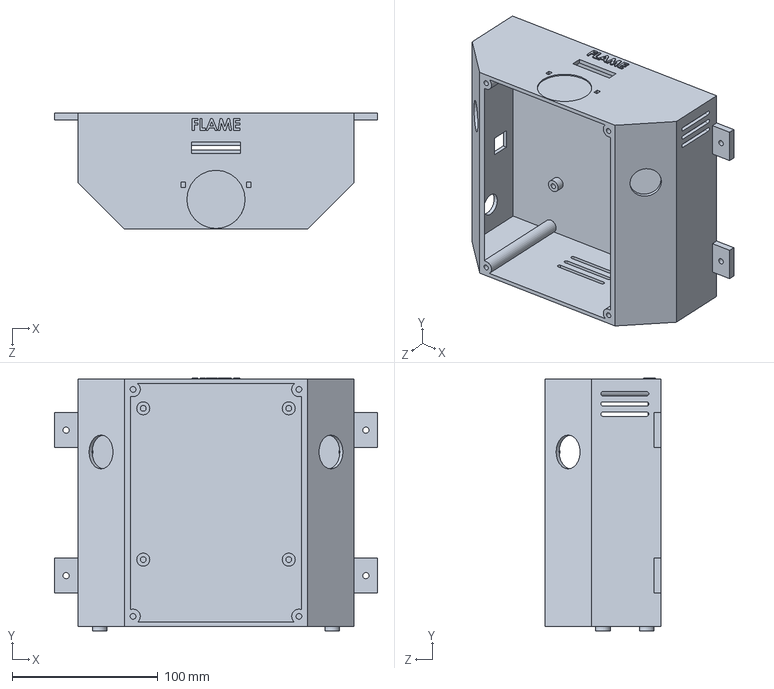
[picture p74: CAD file, 2026-11-10]
tools/cad/env_enclosure/out/EnvEnclosure_Body.SLDPRT
222.0 x 173.8 x 80.0 mm
