aliloay/smart-lab-portal/tools/cad/release_2026-10-25/3_ConsumablesBin/BinEnclosure_Body.STL

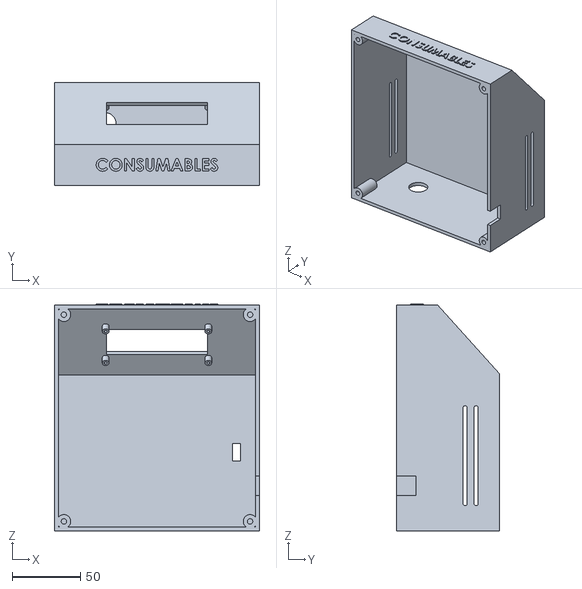
[picture p75: CAD file, 2026-11-08]
tools/cad/release_2026-10-25/3_ConsumablesBin/BinEnclosure_Body.STL
150.0 x 75.0 x 165.8
