aliloay/smart-lab-portal/tools/cad/bin_enclosure/out/BinEnclosure_Floor.SLDPRT

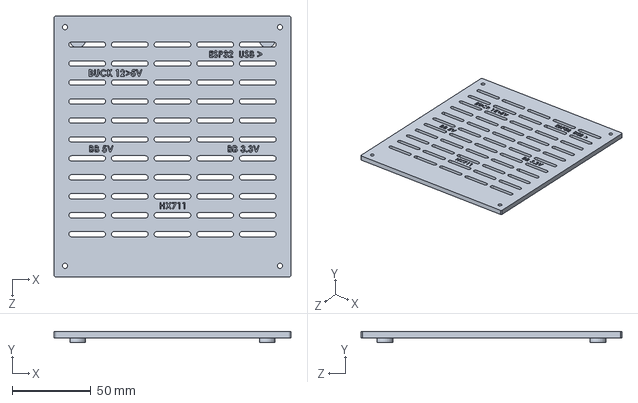
[picture p76: CAD file, 2026-11-10]
tools/cad/bin_enclosure/out/BinEnclosure_Floor.SLDPRT
150.0 x 7.00 x 165.0 mm
