aliloay/smart-lab-portal/tools/cad/bin_enclosure/out/envelopes/Env_esp32.SLDPRT

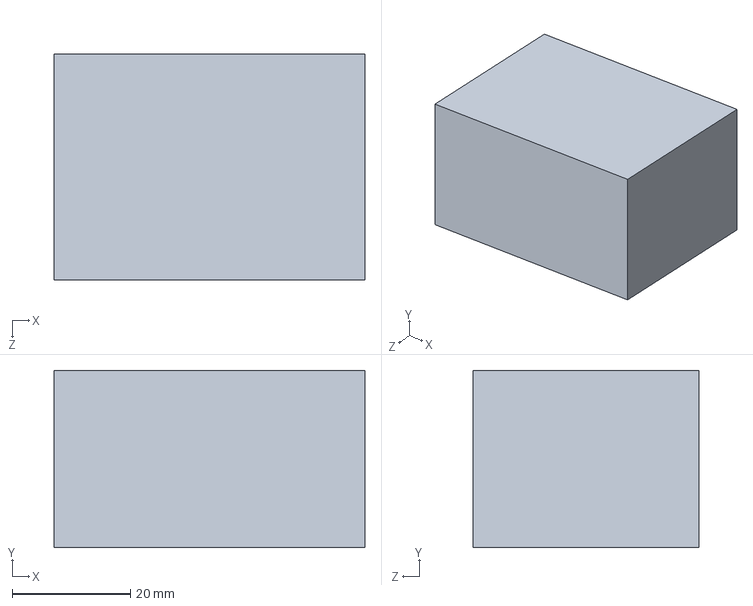
[picture p77: CAD file, 2026-11-10]
tools/cad/bin_enclosure/out/envelopes/Env_esp32.SLDPRT
52.7 x 30.0 x 38.3 mm
