aliloay/smart-lab-portal/tools/cad/ctrl_enclosure/out/CtrlEnclosure_FrontPanel.STEP

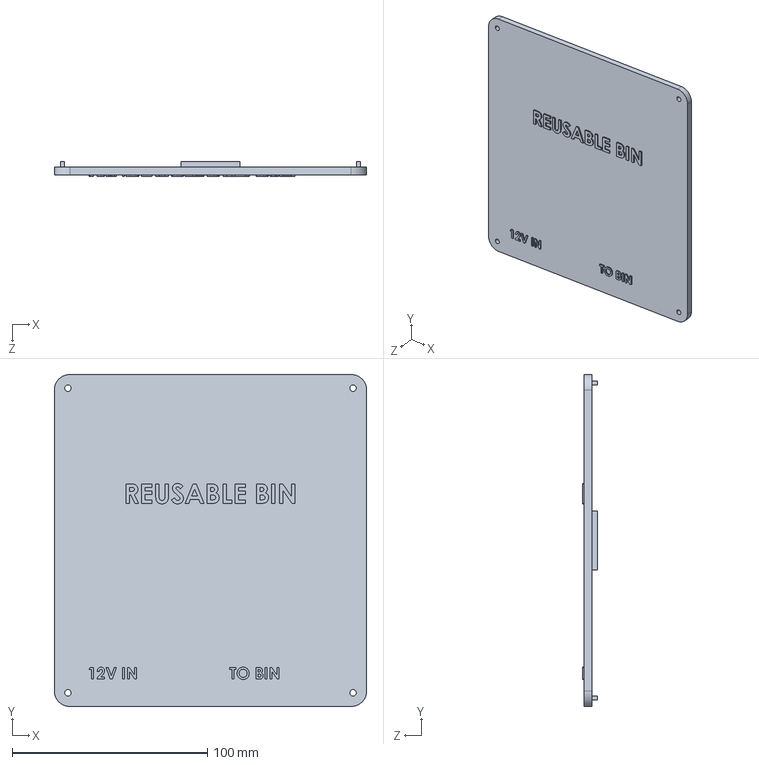
[picture p78: CAD file, 2026-11-10]
tools/cad/ctrl_enclosure/out/CtrlEnclosure_FrontPanel.STEP
160.0 x 170.0 x 7.80 mm
