aliloay/smart-lab-portal/tools/cad/dock_enclosure/out/BinDock_ElectronicsPlate.SLDPRT

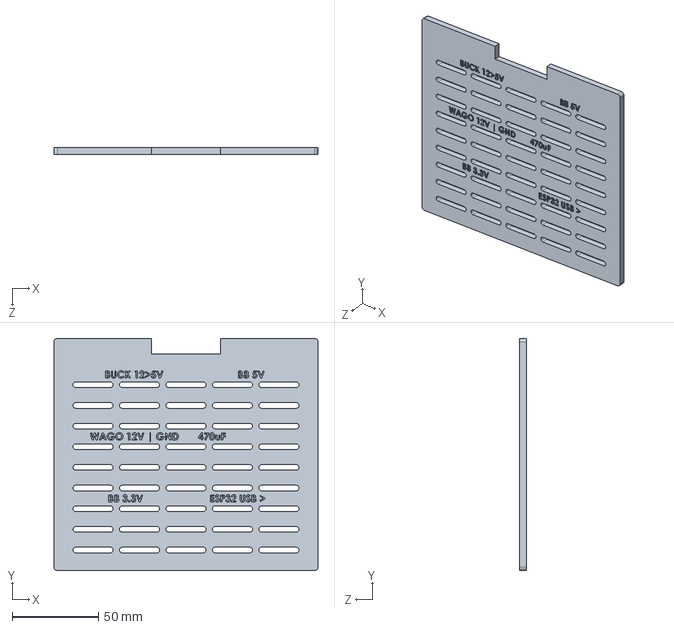
[picture p79: CAD file, 2026-11-10]
tools/cad/dock_enclosure/out/BinDock_ElectronicsPlate.SLDPRT
153.4 x 135.0 x 4.00 mm
