aliloay/smart-lab-portal/tools/cad/dock_enclosure/out/envelopes/Env_wago1.SLDPRT

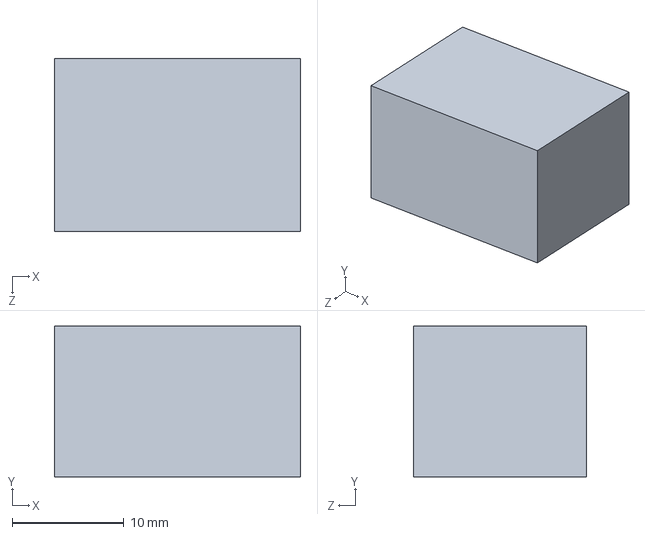
[picture p80: CAD file, 2026-11-10]
tools/cad/dock_enclosure/out/envelopes/Env_wago1.SLDPRT
22.0 x 13.5 x 15.5 mm
