aliloay/smart-lab-portal/tools/cad/door_enclosure/DoorEnclosure_FitTestRelease_2026-10-20/envelopes/Env_relay.SLDPRT

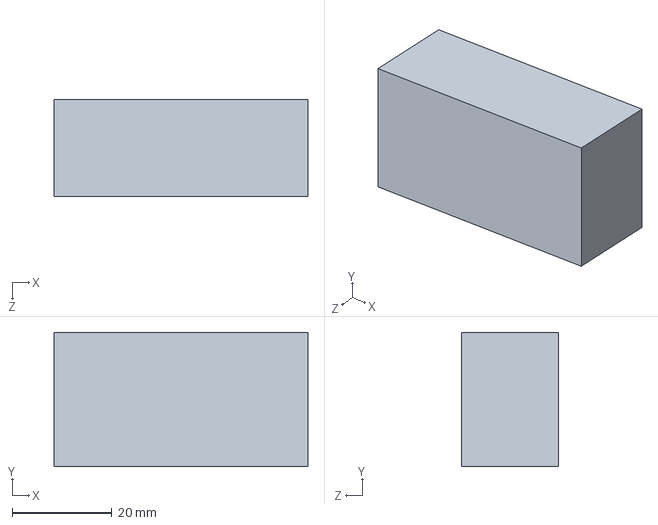
[picture p81: CAD file, 2026-11-10]
tools/cad/door_enclosure/DoorEnclosure_FitTestRelease_2026-10-20/envelopes/Env_relay.SLDPRT
51.0 x 27.0 x 19.5 mm
