aliloay/smart-lab-portal/tools/cad/door_enclosure/out_final_2026-10-24/envelopes/Env_esp32.SLDPRT

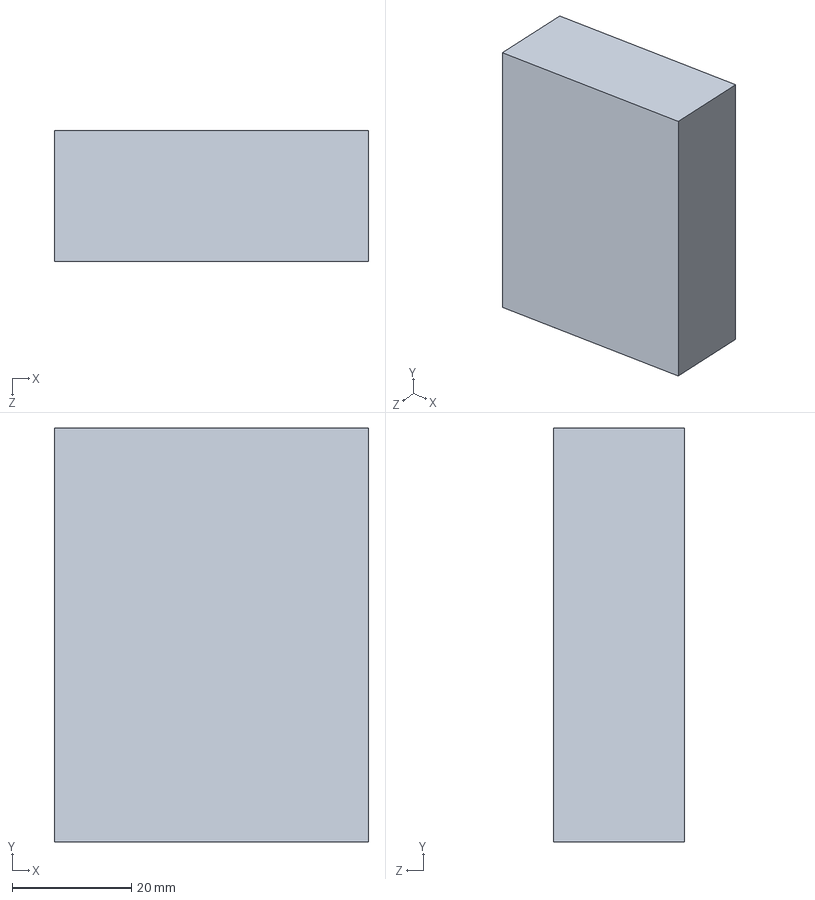
[picture p82: CAD file, 2026-11-10]
tools/cad/door_enclosure/out_final_2026-10-24/envelopes/Env_esp32.SLDPRT
52.7 x 69.4 x 22.0 mm
