aliloay/smart-lab-portal/tools/cad/door_enclosure/out_owner_backup_2026-10-24/envelopes/Env_buzzer.SLDPRT

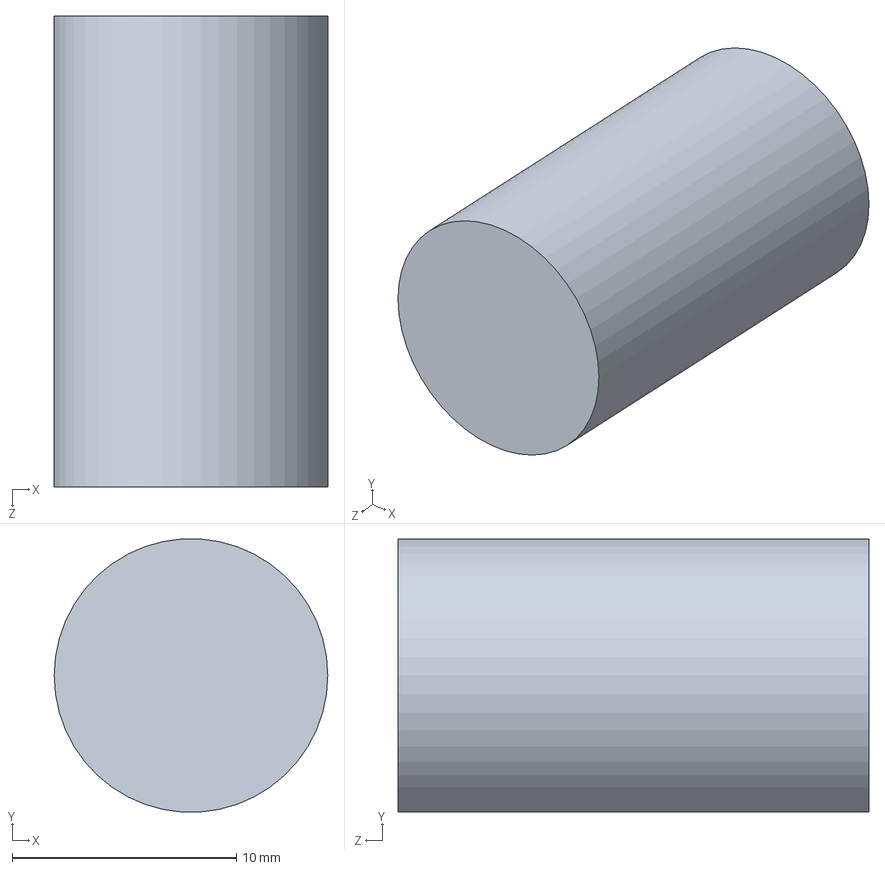
[picture p83: CAD file, 2026-11-10]
tools/cad/door_enclosure/out_owner_backup_2026-10-24/envelopes/Env_buzzer.SLDPRT
12.2 x 12.2 x 21.0 mm
