aliloay/smart-lab-portal/tools/cad/env_enclosure/out/envelopes/Env_mq_board.SLDPRT

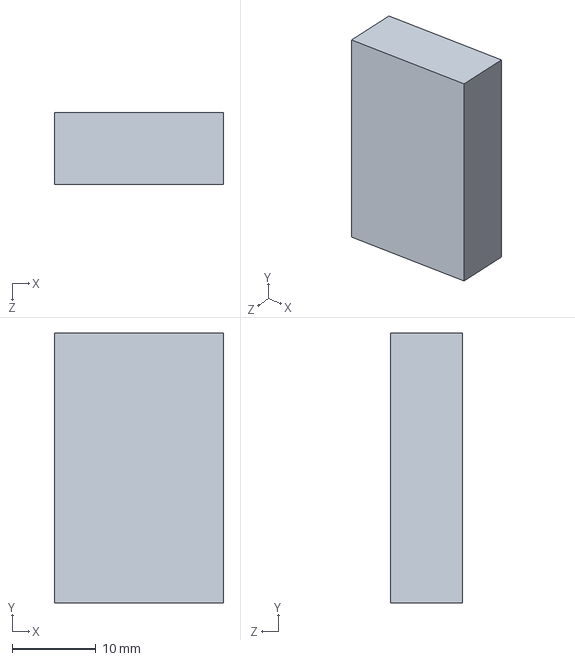
[picture p84: CAD file, 2026-11-10]
tools/cad/env_enclosure/out/envelopes/Env_mq_board.SLDPRT
20.2 x 32.2 x 8.60 mm
