aliloay/smart-lab-portal/tools/cad/env_enclosure/out/EnvEnclosure_FrontPanel.STEP

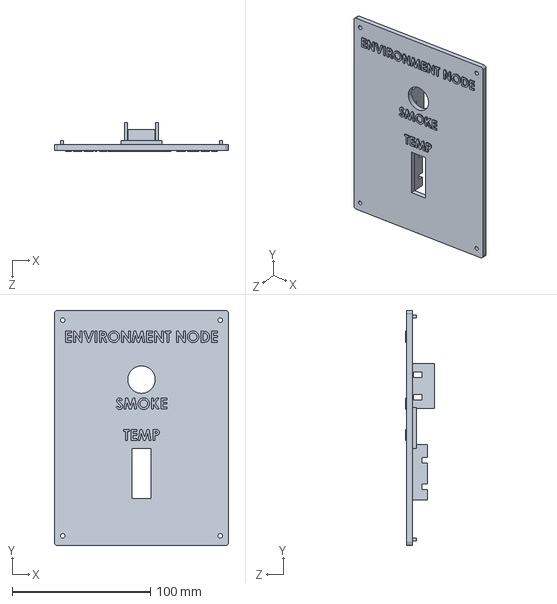
[picture p85: CAD file, 2026-11-10]
tools/cad/env_enclosure/out/EnvEnclosure_FrontPanel.STEP
126.0 x 170.0 x 20.8 mm
