aliloay/smart-lab-portal/tools/cad/bin_enclosure/out/envelopes/Env_hx711.SLDPRT

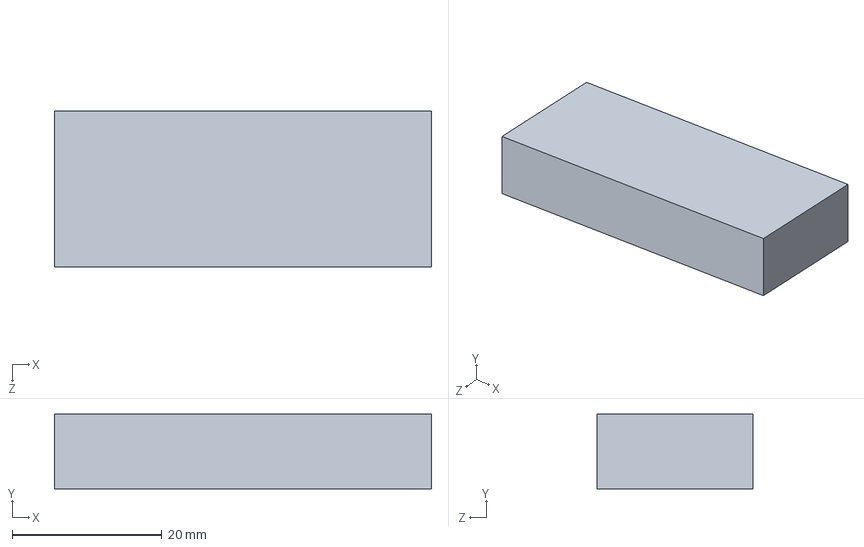
[picture p86: CAD file, 2026-11-10]
tools/cad/bin_enclosure/out/envelopes/Env_hx711.SLDPRT
50.3 x 10.0 x 20.8 mm
