aliloay/smart-lab-portal/tools/cad/ctrl_enclosure/out/CtrlEnclosure_ElectronicsPlate.SLDPRT

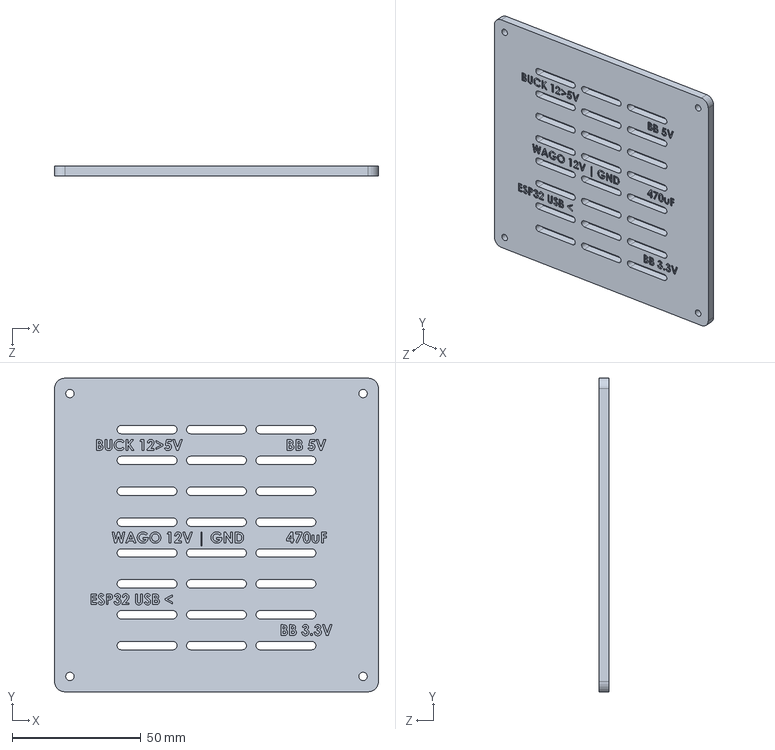
[picture p87: CAD file, 2026-11-10]
tools/cad/ctrl_enclosure/out/CtrlEnclosure_ElectronicsPlate.SLDPRT
126.0 x 122.0 x 4.00 mm
