aliloay/smart-lab-portal/tools/cad/dock_enclosure/out/BinDock_Lid.SLDPRT

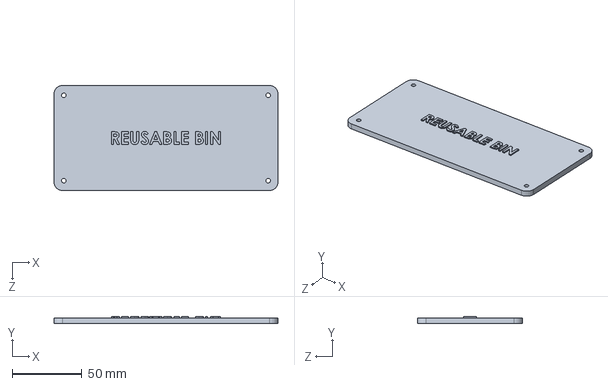
[picture p88: CAD file, 2026-11-10]
tools/cad/dock_enclosure/out/BinDock_Lid.SLDPRT
160.0 x 4.80 x 75.0 mm
