aliloay/smart-lab-portal/tools/cad/door_enclosure/DoorEnclosure_FitTestRelease_2026-10-20/DoorEnclosure_Body.SLDPRT

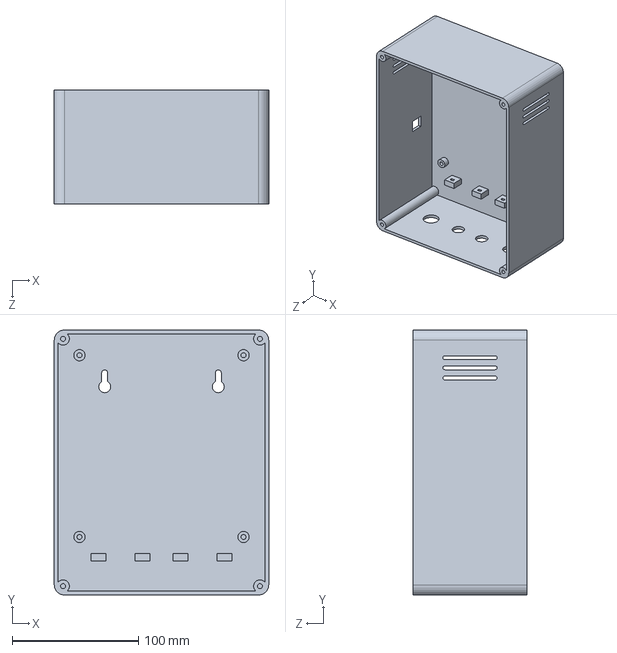
[picture p89: CAD file, 2026-11-10]
tools/cad/door_enclosure/DoorEnclosure_FitTestRelease_2026-10-20/DoorEnclosure_Body.SLDPRT
170.0 x 210.0 x 90.0 mm
