aliloay/smart-lab-portal/tools/cad/door_enclosure/DoorEnclosure_FitTestRelease_2026-10-20/envelopes/Env_buzzer.SLDPRT

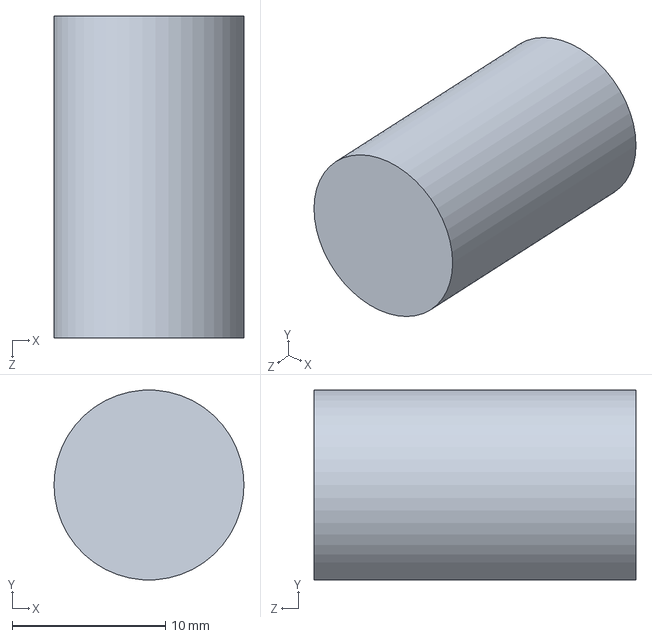
[picture p90: CAD file, 2026-11-10]
tools/cad/door_enclosure/DoorEnclosure_FitTestRelease_2026-10-20/envelopes/Env_buzzer.SLDPRT
12.4 x 12.4 x 21.0 mm
