aliloay/smart-lab-portal/tools/cad/door_enclosure/out_final_2026-10-24/envelopes/Env_tft_pcb.SLDPRT

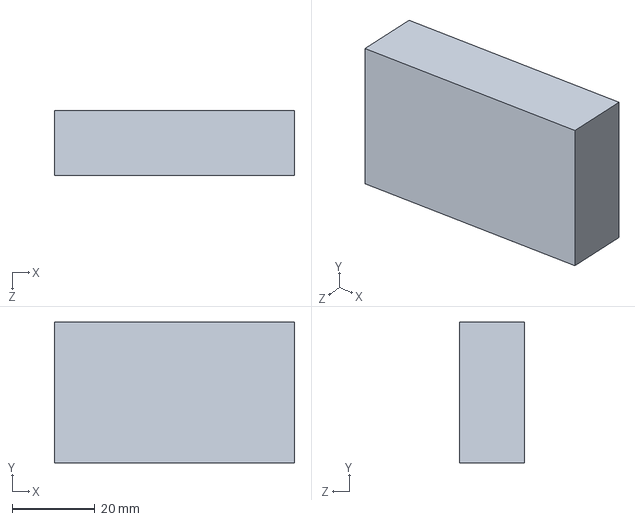
[picture p91: CAD file, 2026-11-10]
tools/cad/door_enclosure/out_final_2026-10-24/envelopes/Env_tft_pcb.SLDPRT
58.0 x 34.0 x 15.6 mm
