aliloay/smart-lab-portal/tools/cad/door_enclosure/out_final_2026-10-24_cam/DoorEnclosure_Body.STEP

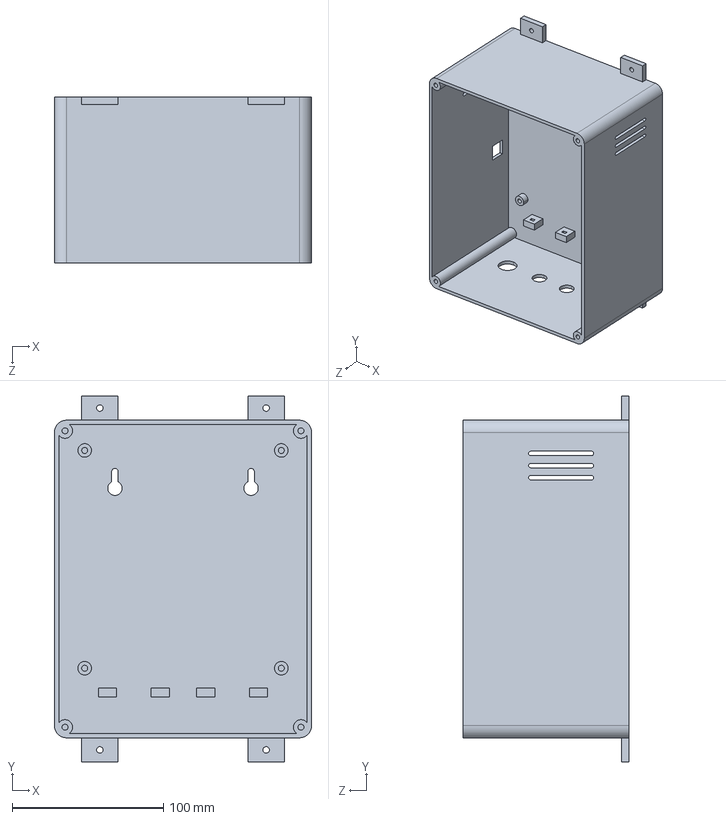
[picture p92: CAD file, 2026-11-10]
tools/cad/door_enclosure/out_final_2026-10-24_cam/DoorEnclosure_Body.STEP
170.0 x 242.0 x 110.0 mm
