aliloay/smart-lab-portal/tools/cad/door_enclosure/out_final_2026-10-24_cam/envelopes/Env_fp.SLDPRT

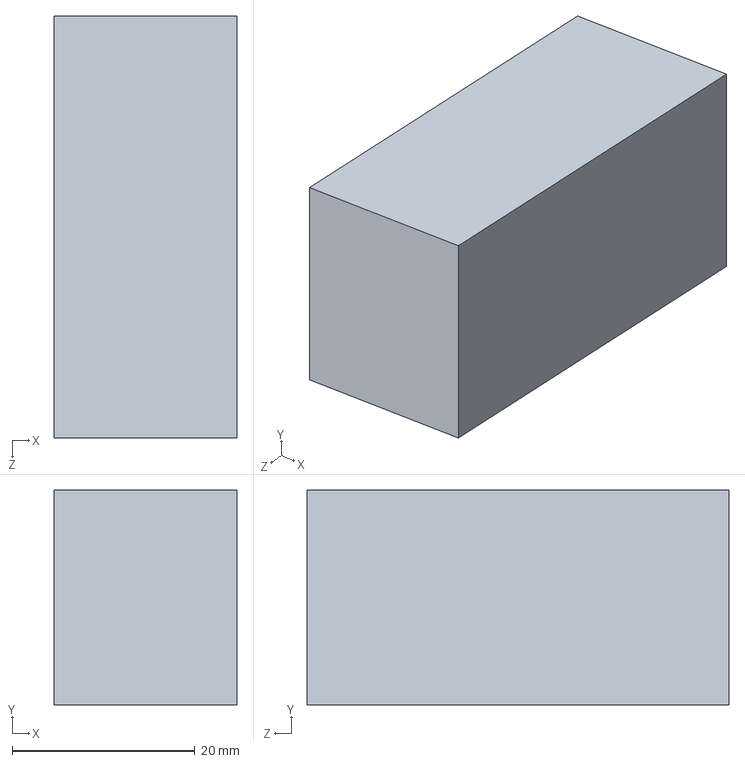
[picture p93: CAD file, 2026-11-10]
tools/cad/door_enclosure/out_final_2026-10-24_cam/envelopes/Env_fp.SLDPRT
20.0 x 23.5 x 46.1 mm
