aliloay/smart-lab-portal/tools/cad/env_enclosure/out/EnvEnclosure_ElectronicsPlate.STEP

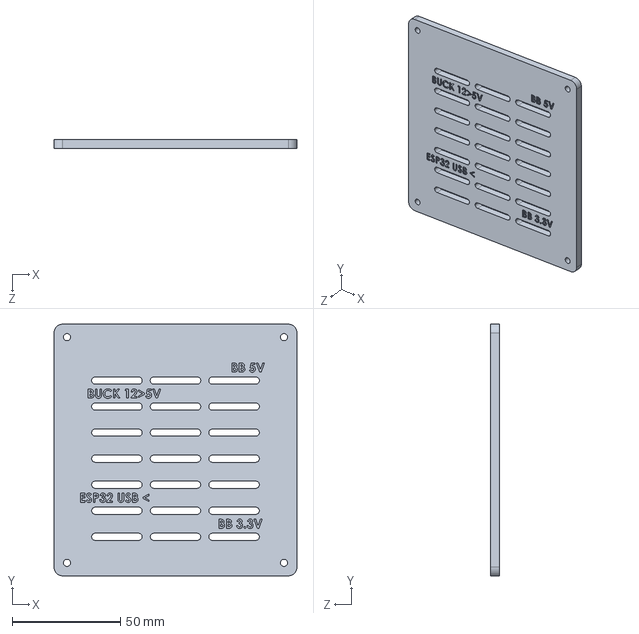
[picture p94: CAD file, 2026-11-10]
tools/cad/env_enclosure/out/EnvEnclosure_ElectronicsPlate.STEP
112.0 x 116.0 x 4.00 mm
