aliloay/smart-lab-portal/tools/cad/ctrl_enclosure/out/CtrlEnclosure_Body.STL

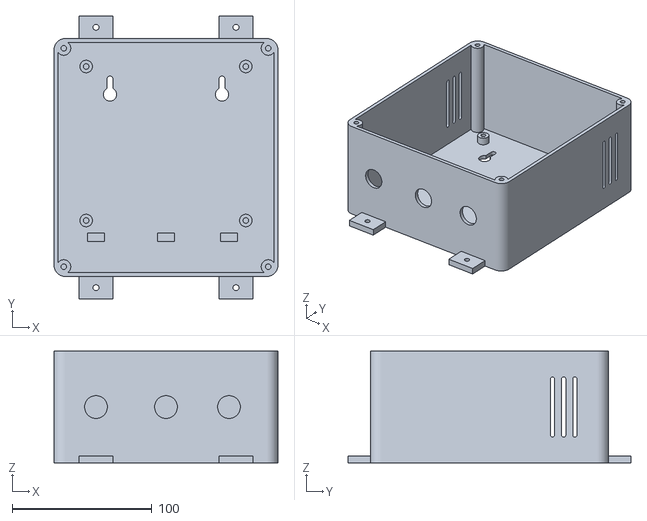
[picture p95: CAD file, 2026-11-10]
tools/cad/ctrl_enclosure/out/CtrlEnclosure_Body.STL
160.0 x 202.0 x 80.0
