aliloay/smart-lab-portal/tools/cad/dock_enclosure/out/BinDock_PedalCover.SLDPRT

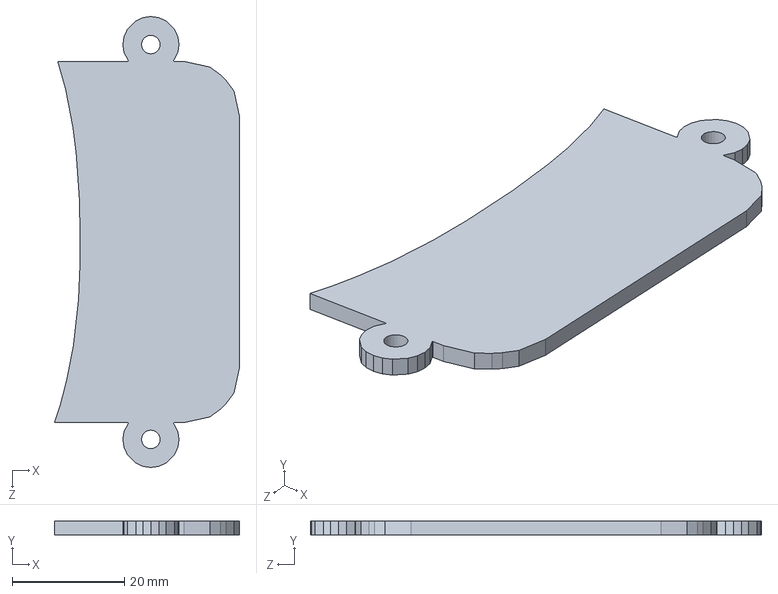
[picture p96: CAD file, 2026-11-10]
tools/cad/dock_enclosure/out/BinDock_PedalCover.SLDPRT
33.0 x 2.50 x 80.3 mm
