aliloay/smart-lab-portal/tools/cad/door_enclosure/DoorEnclosure_FitTestRelease_2026-10-20/envelopes/Env_buck.SLDPRT

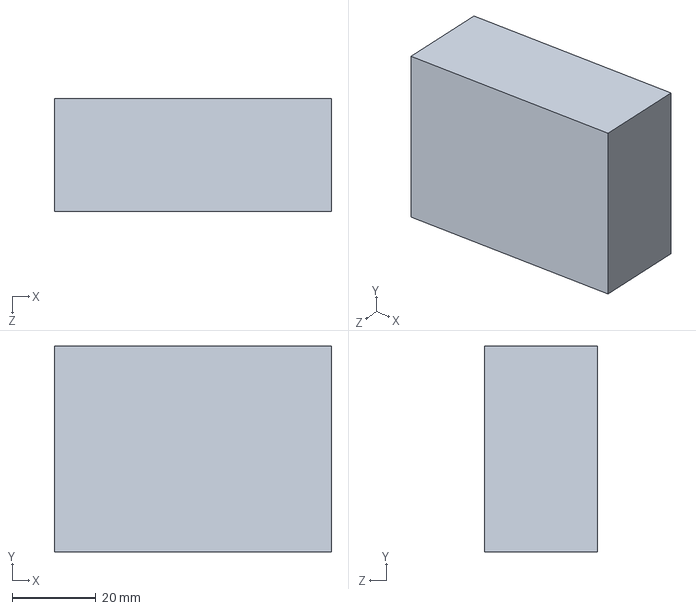
[picture p97: CAD file, 2026-11-10]
tools/cad/door_enclosure/DoorEnclosure_FitTestRelease_2026-10-20/envelopes/Env_buck.SLDPRT
66.0 x 49.0 x 27.0 mm
