aliloay/smart-lab-portal/tools/cad/door_enclosure/out_final_2026-10-24/DoorEnclosure_FitCoupon.STL

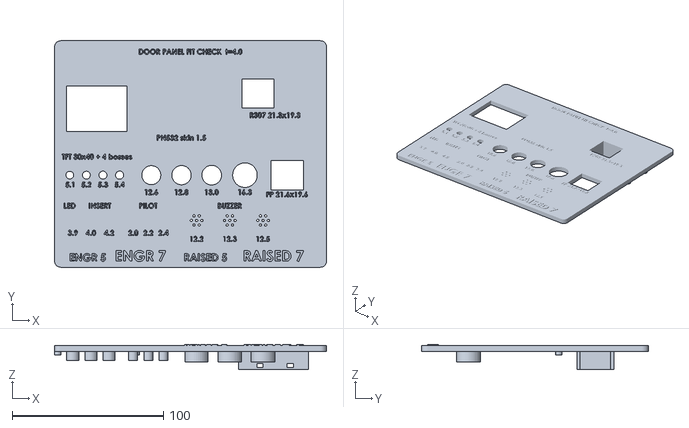
[picture p98: CAD file, 2026-11-10]
tools/cad/door_enclosure/out_final_2026-10-24/DoorEnclosure_FitCoupon.STL
180.1 x 150.0 x 16.8
