aliloay/smart-lab-portal/tools/cad/door_enclosure/out_final_2026-10-24/envelopes/Env_cap.SLDPRT

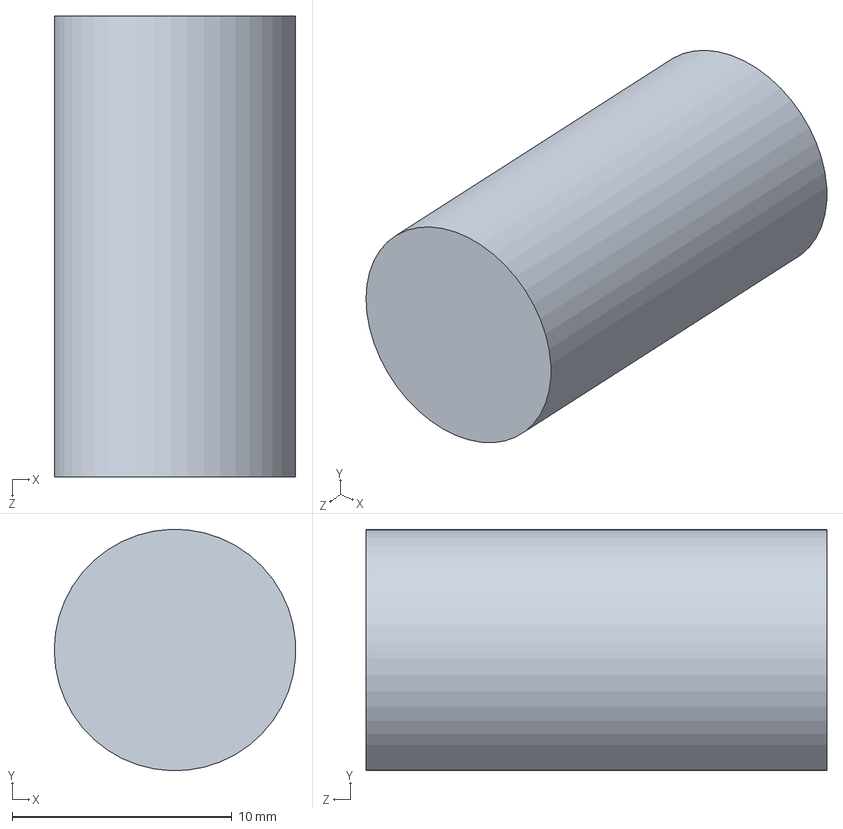
[picture p99: CAD file, 2026-11-10]
tools/cad/door_enclosure/out_final_2026-10-24/envelopes/Env_cap.SLDPRT
11.0 x 11.0 x 21.0 mm
