aliloay/smart-lab-portal/tools/cad/door_enclosure/out_final_2026-10-24_cam/envelopes/Env_tft_glass.SLDPRT

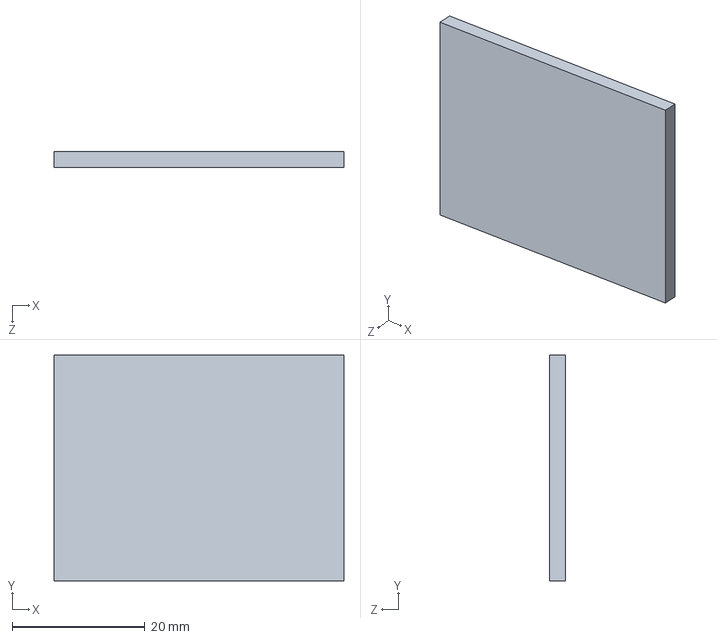
[picture p100: CAD file, 2026-11-10]
tools/cad/door_enclosure/out_final_2026-10-24_cam/envelopes/Env_tft_glass.SLDPRT
43.7 x 34.0 x 2.40 mm
