aliloay/smart-lab-portal/tools/cad/door_enclosure/DoorEnclosure_FitTestRelease_2026-10-20/envelopes/Env_fp.SLDPRT

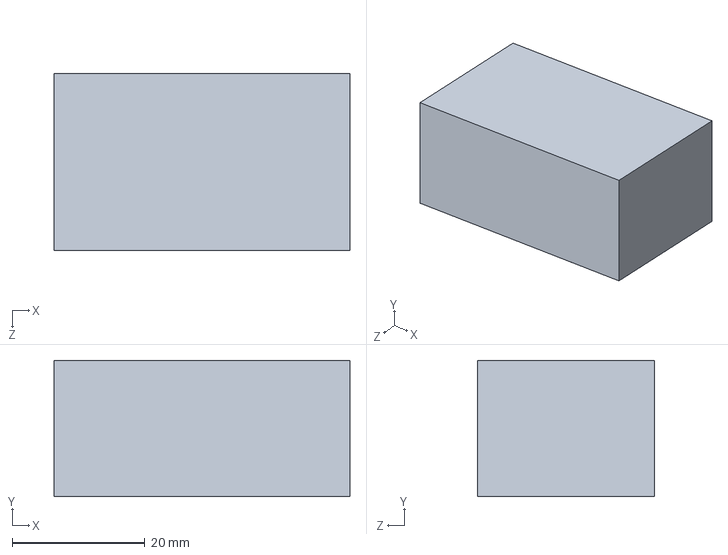
[picture p101: CAD file, 2026-11-10]
tools/cad/door_enclosure/DoorEnclosure_FitTestRelease_2026-10-20/envelopes/Env_fp.SLDPRT
44.6 x 20.5 x 26.7 mm
