aliloay/smart-lab-portal/tools/cad/door_enclosure/out_final_2026-10-24/DoorEnclosure_FrontPanel.SLDPRT

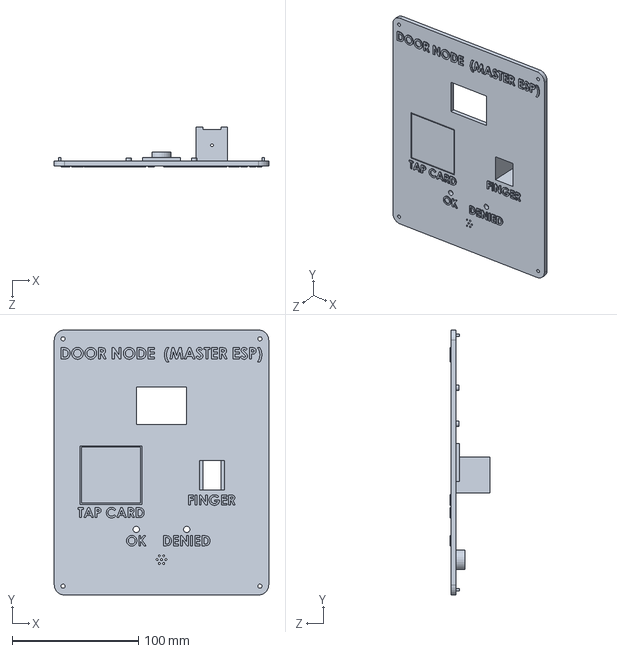
[picture p102: CAD file, 2026-11-10]
tools/cad/door_enclosure/out_final_2026-10-24/DoorEnclosure_FrontPanel.SLDPRT
170.0 x 210.0 x 31.9 mm
