aliloay/smart-lab-portal/tools/cad/door_enclosure/out_final_2026-10-24/envelopes/Env_fp.SLDPRT

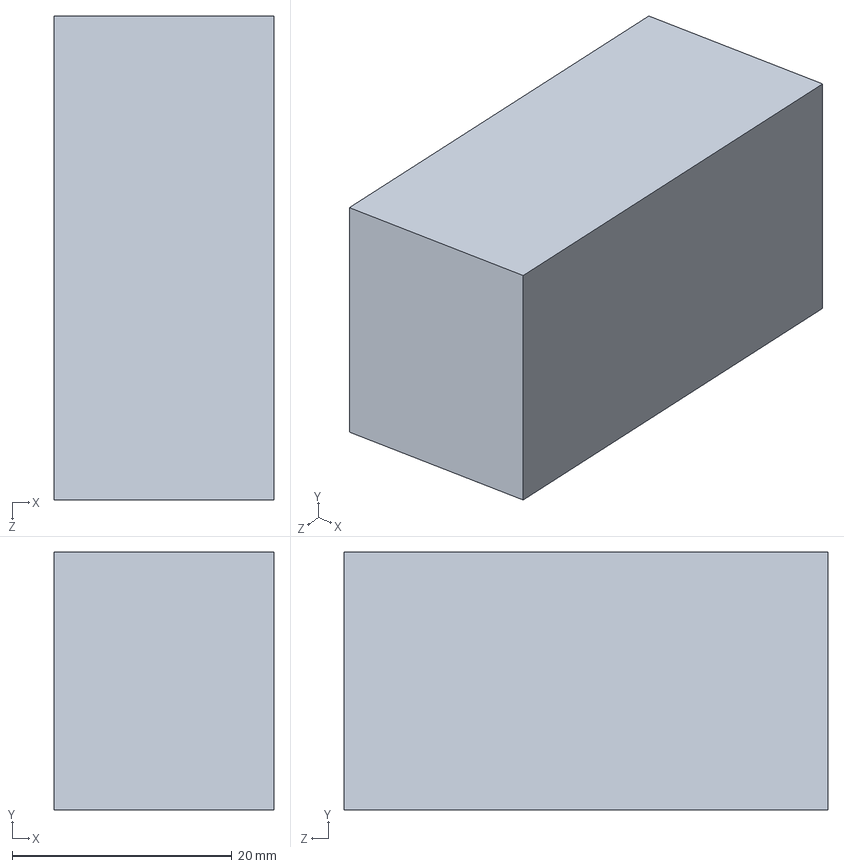
[picture p103: CAD file, 2026-11-10]
tools/cad/door_enclosure/out_final_2026-10-24/envelopes/Env_fp.SLDPRT
20.0 x 23.5 x 44.1 mm
