aliloay/smart-lab-portal/tools/cad/door_enclosure_tol_backup_2026-10-21/owner_saved/envelopes/Env_esp32.SLDPRT

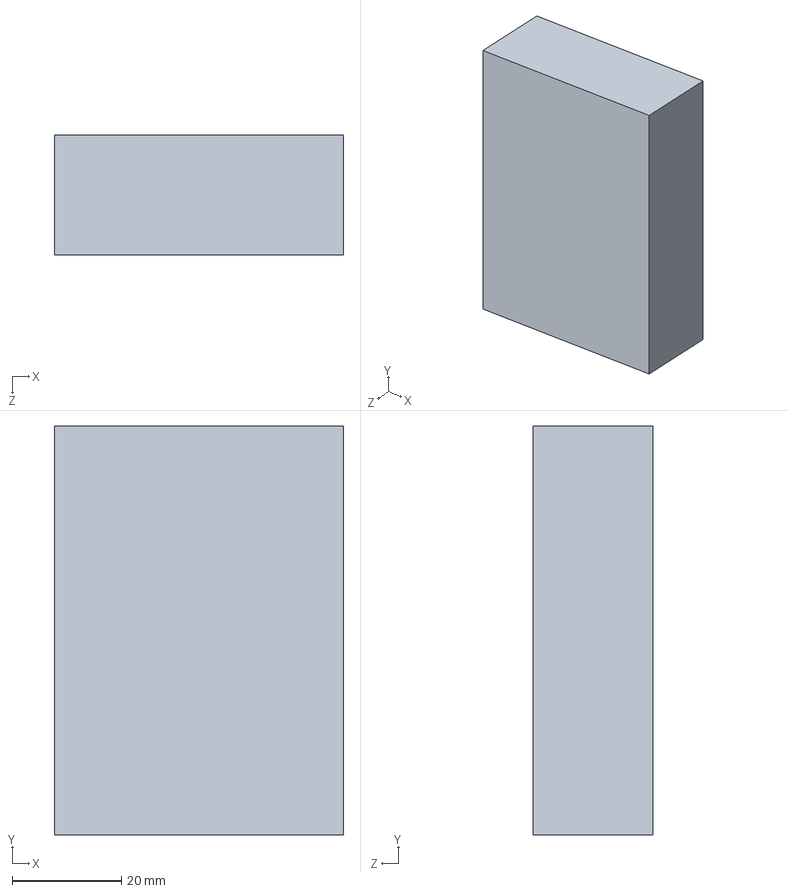
[picture p104: CAD file, 2026-11-10]
tools/cad/door_enclosure_tol_backup_2026-10-21/owner_saved/envelopes/Env_esp32.SLDPRT
53.0 x 75.0 x 22.0 mm
