aliloay/smart-lab-portal/tools/cad/dock_enclosure/out/BinDock_BinReference.SLDPRT

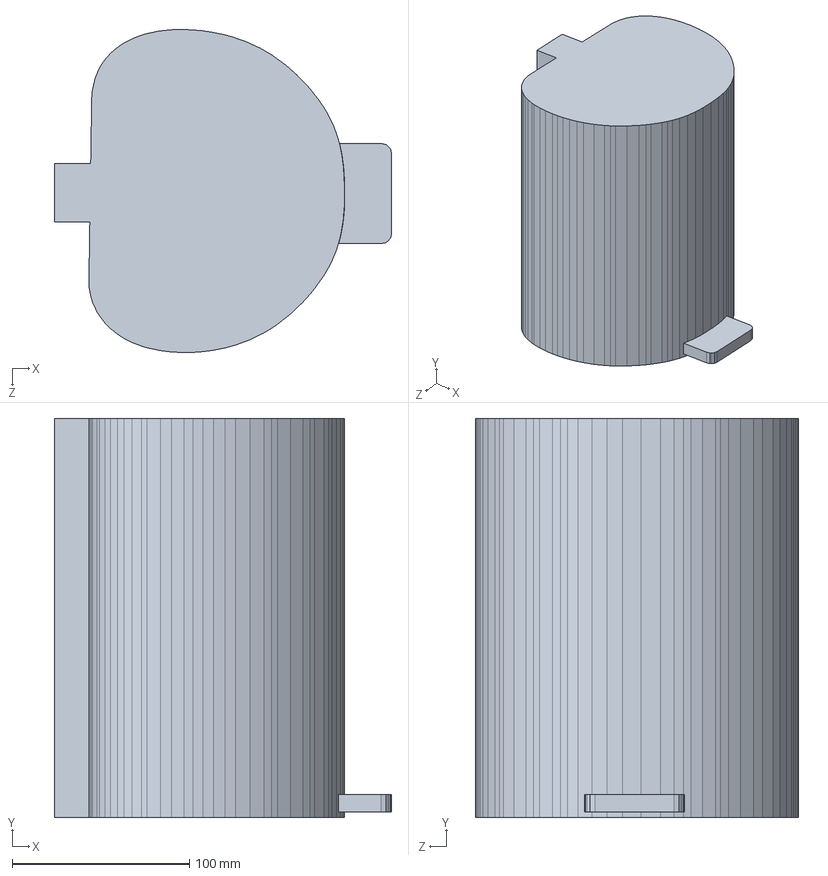
[picture p105: CAD file, 2026-11-10]
tools/cad/dock_enclosure/out/BinDock_BinReference.SLDPRT
190.3 x 225.0 x 182.2 mm
