aliloay/smart-lab-portal/tools/cad/door_enclosure/out_final_2026-10-24/envelopes/Env_relay.SLDPRT

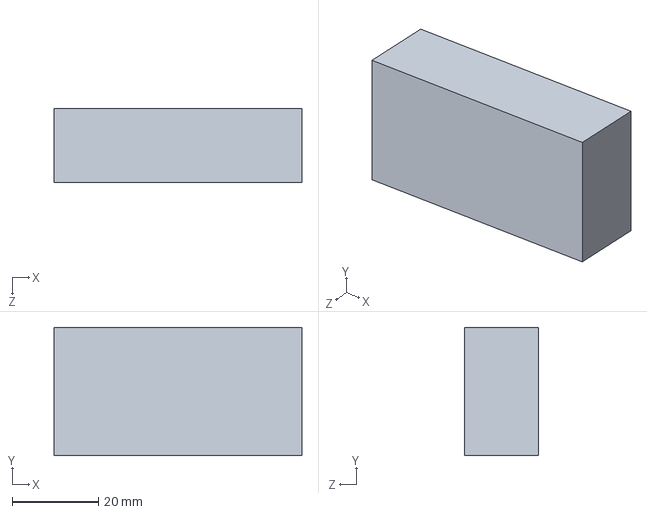
[picture p106: CAD file, 2026-11-10]
tools/cad/door_enclosure/out_final_2026-10-24/envelopes/Env_relay.SLDPRT
57.7 x 29.8 x 17.1 mm
