aliloay/smart-lab-portal/(list of files, cad)

Other CAD files:
tools/cad/ctrl_enclosure/out/envelopes/Env_bb_5v.SLDPRT
tools/cad/door_enclosure/out_owner_backup_2026-10-24/envelopes/Env_driver_bb.SLDPRT
tools/cad/door_enclosure_tol_backup_2026-10-21/DoorEnclosure_FrontPanel.STL
tools/cad/door_enclosure_tol_backup_2026-10-21/owner_saved/DoorEnclosure_ElectronicsPlate.SLDPRT
tools/cad/ctrl_enclosure/out/envelopes/Env_bb_3v3.SLDPRT
tools/cad/door_enclosure/out_final_2026-10-24_cam/envelopes/Env_led_r.SLDPRT
tools/cad/door_enclosure/out_owner_backup_2026-10-24/DoorEnclosure_FrontPanel.STEP
tools/cad/door_enclosure_tol_backup_2026-10-21/owner_saved/envelopes/Env_wago1.SLDPRT
tools/cad/ctrl_enclosure/out/envelopes/Env_wago1.SLDPRT
tools/cad/door_enclosure/out_final_2026-10-24/DoorEnclosure_Body.SLDPRT
tools/cad/door_enclosure_tol_backup_2026-10-21/owner_saved/DoorEnclosure_Body.SLDPRT
tools/cad/door_enclosure_tol_backup_2026-10-21/owner_saved/envelopes/Env_led_g.SLDPRT
tools/cad/env_enclosure/out/envelopes/Env_esp32.SLDPRT
tools/cad/bin_enclosure/out/BinEnclosure_Body.SLDPRT
tools/cad/bin_enclosure/out/envelopes/Env_bb_3v3.SLDPRT
tools/cad/ctrl_enclosure/out/envelopes/Env_buck.SLDPRT
tools/cad/door_enclosure/out/envelopes/Env_led_r.SLDPRT
tools/cad/door_enclosure/out_final_2026-10-24_cam/DoorEnclosure_ElectronicsPlate.STEP
tools/cad/door_enclosure_tol_backup_2026-10-21/owner_saved/envelopes/Env_relay.SLDPRT
tools/cad/ctrl_enclosure/out/envelopes/Env_cap.SLDPRT
tools/cad/door_enclosure/out_final_2026-10-24_cam/envelopes/Env_led_g.SLDPRT
tools/cad/door_enclosure/DoorEnclosure_FitTestRelease_2026-10-20/envelopes/Env_led_g.SLDPRT
tools/cad/door_enclosure/out_final_2026-10-24/envelopes/Env_driver_bb.SLDPRT
tools/cad/door_enclosure/out_final_2026-10-24_cam/envelopes/Env_buzzer.SLDPRT
tools/cad/door_enclosure_tol_backup_2026-10-21/owner_saved/envelopes/Env_buzzer.SLDPRT
tools/cad/door_enclosure/DoorEnclosure_FitTestRelease_2026-10-20/envelopes/Env_led_r.SLDPRT
tools/cad/door_enclosure/out_final_2026-10-24/envelopes/Env_tft_glass.SLDPRT
tools/cad/door_enclosure/out_final_2026-10-24_cam/envelopes/Env_bb_3v3.SLDPRT
tools/cad/door_enclosure_tol_backup_2026-10-21/owner_saved/envelopes/Env_buck.SLDPRT
tools/cad/door_enclosure/out_final_2026-10-24_cam/envelopes/Env_bb_5v.SLDPRT
tools/cad/door_enclosure_tol_backup_2026-10-21/owner_saved/envelopes/Env_wago2.SLDPRT
tools/cad/door_enclosure/out_final_2026-10-24_cam/envelopes/Env_tft_pcb.SLDPRT
tools/cad/door_enclosure_tol_backup_2026-10-21/owner_saved/envelopes/Env_cap.SLDPRT
tools/cad/door_enclosure_tol_backup_2026-10-21/owner_saved/envelopes/Env_driver_bb.SLDPRT
tools/cad/bin_enclosure/out/BinEnclosure_CupRing.SLDPRT
tools/cad/bin_enclosure/out/BinEnclosure_CupRing.STL
tools/cad/ctrl_enclosure/out/CtrlEnclosure_ElectronicsPlate.STL
tools/cad/ctrl_enclosure/out/CtrlEnclosure_FrontPanel.SLDPRT
tools/cad/ctrl_enclosure/out/CtrlEnclosure_FrontPanel.STL
tools/cad/door_enclosure/out/envelopes/Env_buck.SLDPRT
tools/cad/door_enclosure/out/envelopes/Env_esp32.SLDPRT
tools/cad/door_enclosure/out/envelopes/Env_tft_glass.SLDPRT
tools/cad/door_enclosure/out/envelopes/Env_wago1.SLDPRT
tools/cad/door_enclosure/out_final_2026-10-24/DoorEnclosure_Assembly.SLDASM
tools/cad/door_enclosure/out_final_2026-10-24/DoorEnclosure_ElectronicsPlate.SLDPRT
tools/cad/door_enclosure/out_final_2026-10-24_cam/DoorEnclosure_Body.SLDPRT
tools/cad/door_enclosure/out_owner_backup_2026-10-24/DoorEnclosure_FrontPanel.STL
tools/cad/env_enclosure/out/EnvEnclosure_ElectronicsPlate.SLDPRT
tools/cad/env_enclosure/out/EnvEnclosure_FrontPanel.SLDPRT
