aliloay/smart-lab-portal/docs/paper_figures/portal_2026-10-19/07_operations_center.png

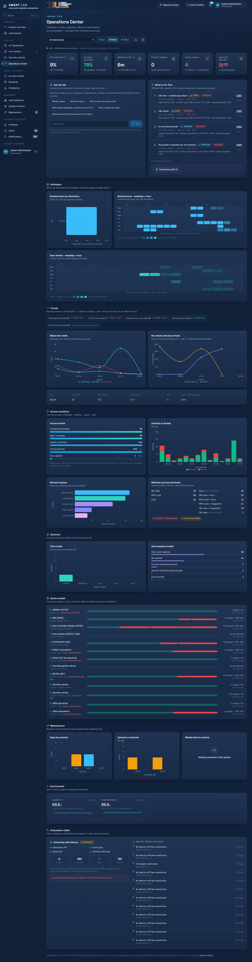
docs/paper_figures/portal_2026-10-19/07_operations_center.png
