aliloay/smart-lab-portal/docs/reports/dossier/enclosure_2026-10-20/DoorEnclosure_Assembly_inside.png

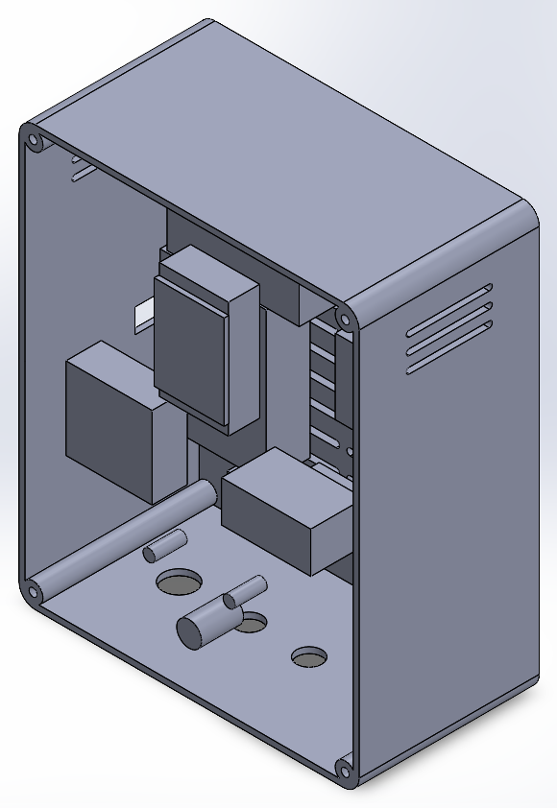
docs/reports/dossier/enclosure_2026-10-20/DoorEnclosure_Assembly_inside.png
