aliloay/smart-lab-portal/tools/cad/bin_enclosure/out/BinEnclosure_Assembly_right.png

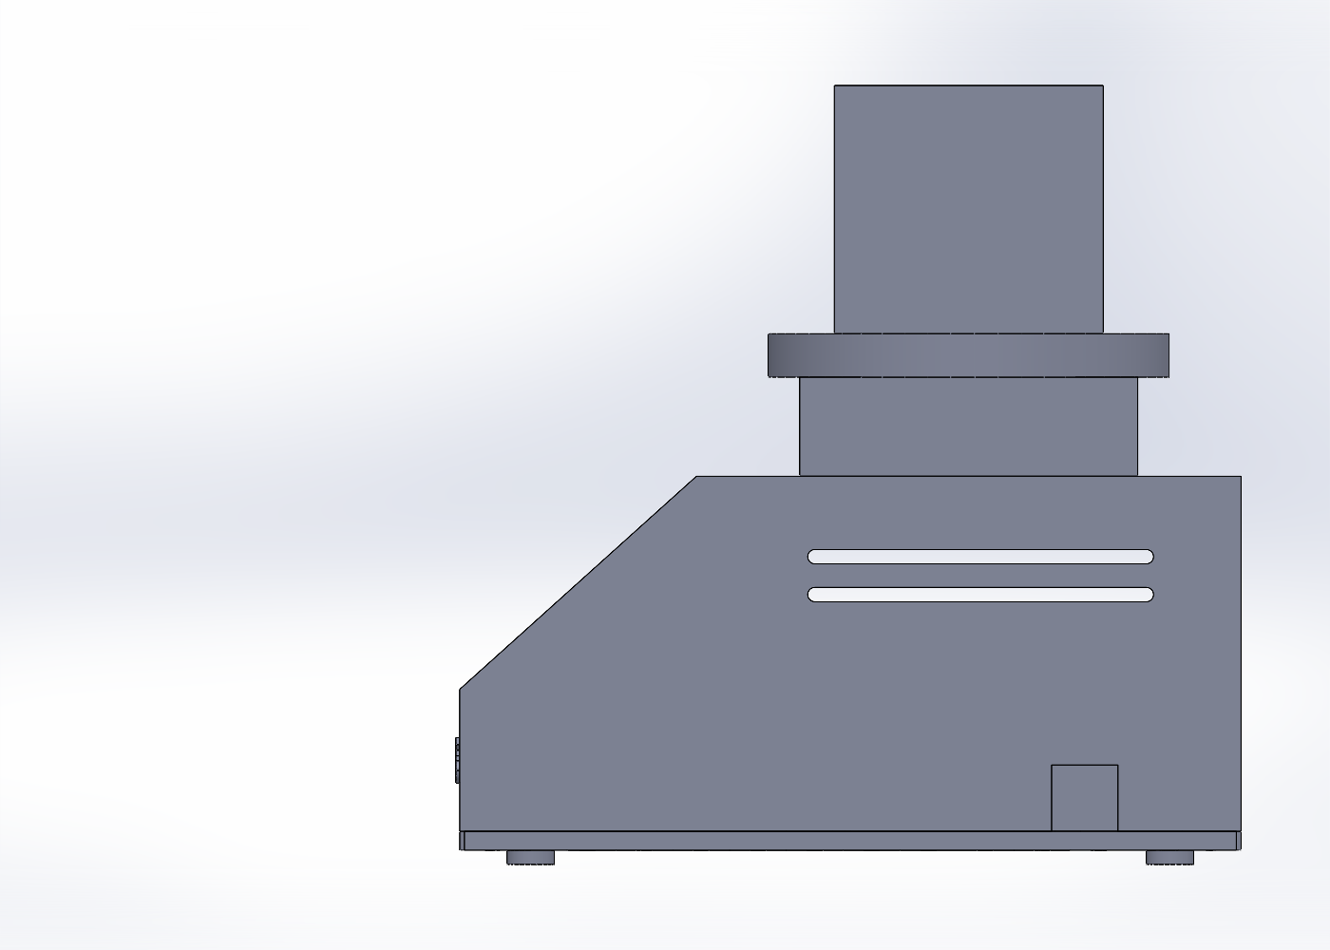
tools/cad/bin_enclosure/out/BinEnclosure_Assembly_right.png
