aliloay/smart-lab-portal/tools/cad/ctrl_enclosure/out/CtrlEnclosure_Assembly_front.png

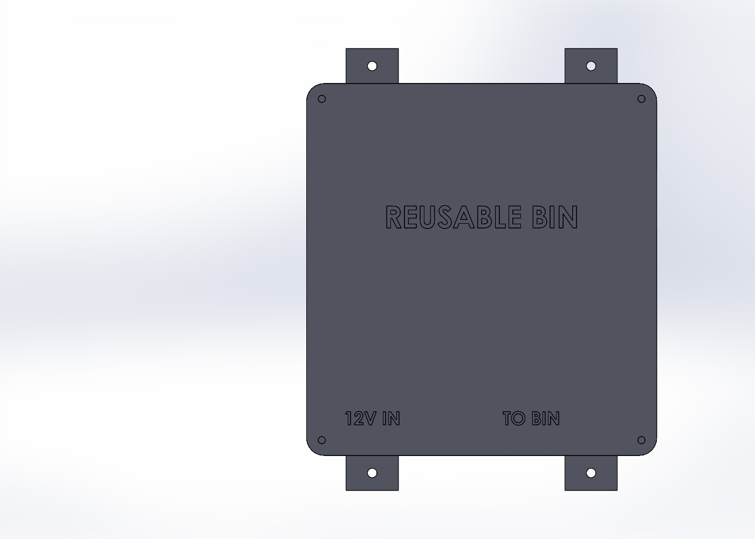
tools/cad/ctrl_enclosure/out/CtrlEnclosure_Assembly_front.png
