aliloay/smart-lab-portal/tools/cad/ctrl_enclosure/out/CtrlEnclosure_Assembly_right.png

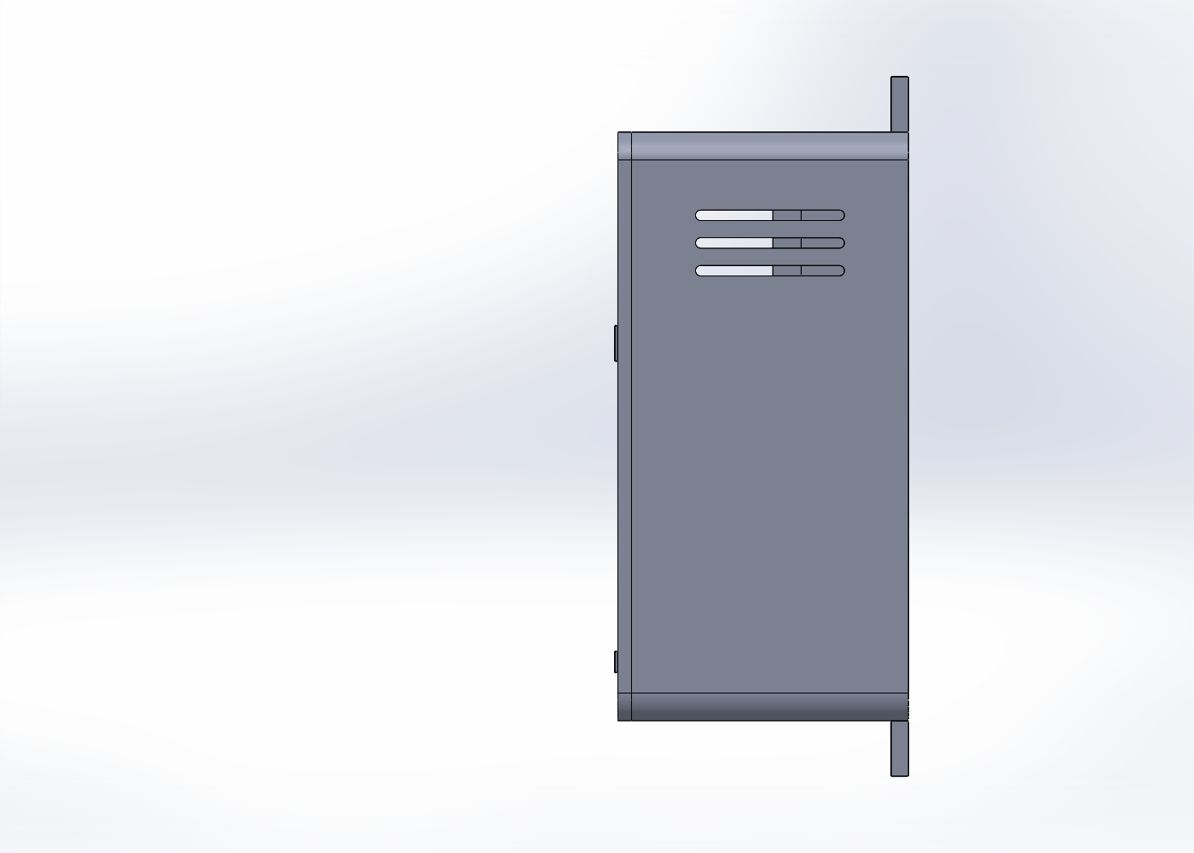
tools/cad/ctrl_enclosure/out/CtrlEnclosure_Assembly_right.png
