aliloay/smart-lab-portal/tools/cad/dock_enclosure/out/BinDock_Assembly_front.png

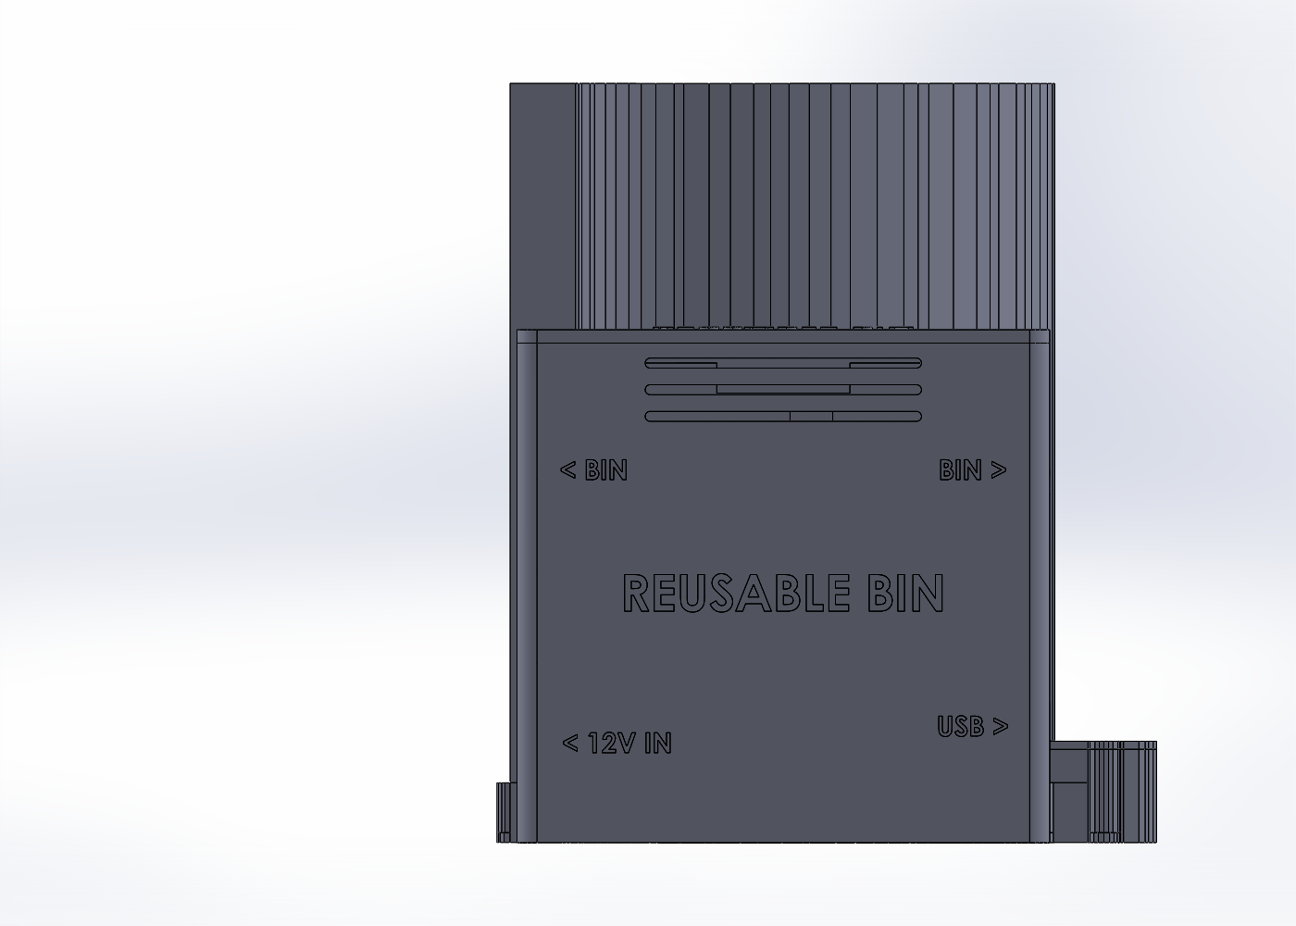
tools/cad/dock_enclosure/out/BinDock_Assembly_front.png
