aliloay/smart-lab-portal/tools/cad/door_enclosure/out_final_2026-10-24/DoorEnclosure_Assembly_front.png

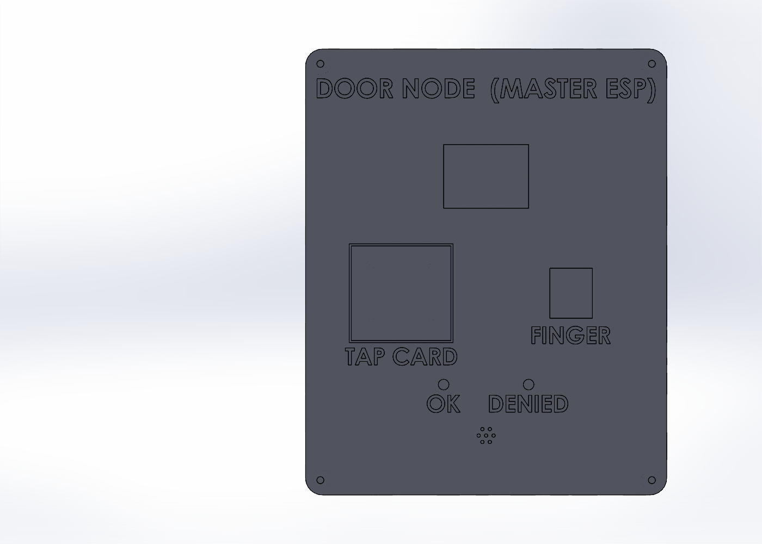
tools/cad/door_enclosure/out_final_2026-10-24/DoorEnclosure_Assembly_front.png
