aliloay/smart-lab-portal/tools/cad/door_enclosure/out_final_2026-10-24_cam/DoorEnclosure_Assembly_inside_front.png

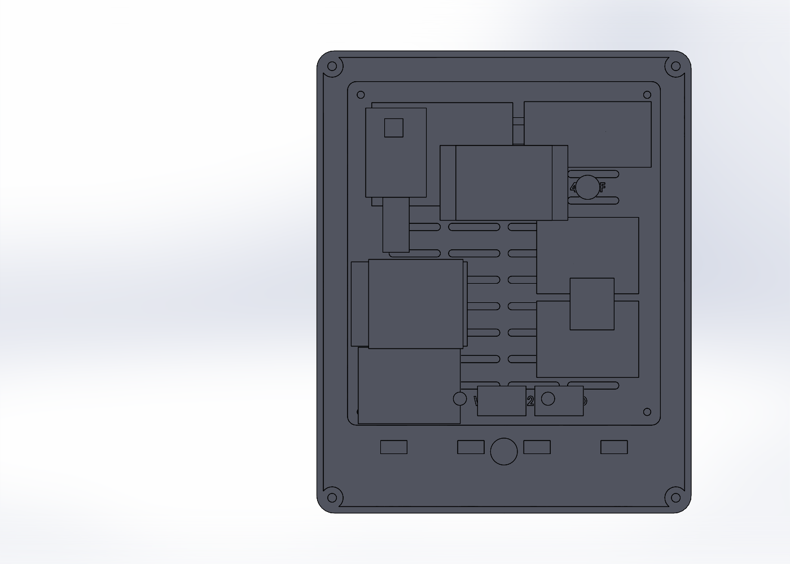
tools/cad/door_enclosure/out_final_2026-10-24_cam/DoorEnclosure_Assembly_inside_front.png
