aliloay/smart-lab-portal/tools/cad/door_enclosure/out_final_2026-10-24_cam/DoorEnclosure_Assembly_right.png

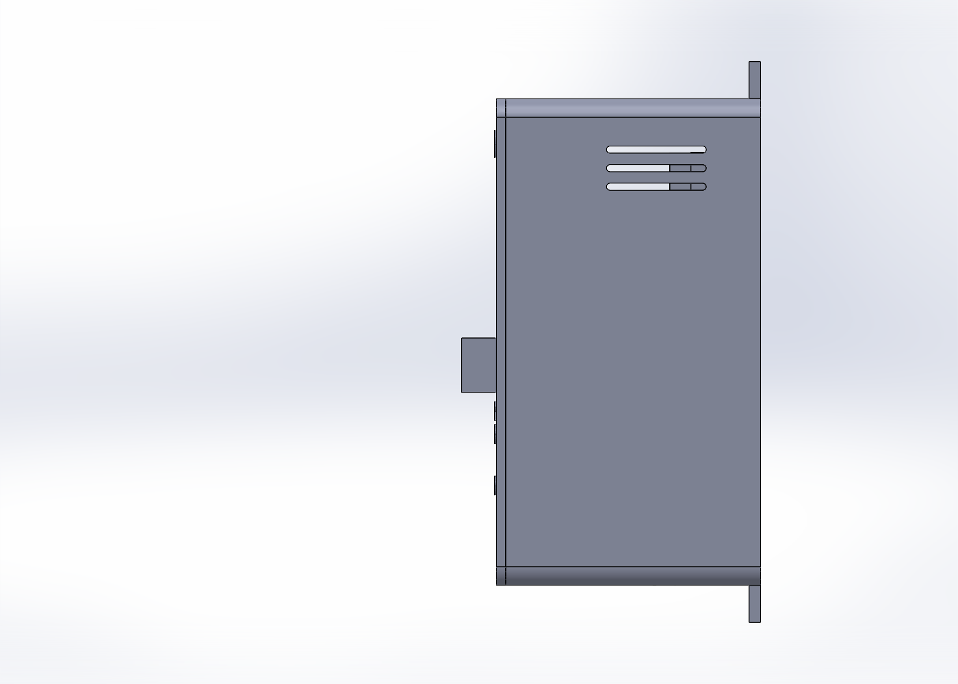
tools/cad/door_enclosure/out_final_2026-10-24_cam/DoorEnclosure_Assembly_right.png
