aliloay/smart-lab-portal/docs/LAB_TEST_2026-10-14.md

# Lab test checklist - Wednesday 2026-10-14

Everything below is built, tested at home and committed (nothing pushed). Tick each
line; if a step fails, note what the screen said and tell Claude.

## 0. Start (5 min)
- [ ] Laptop: Ethernet to the Smart_Lab router (192.168.1.200) + Wi-Fi as usual.
- [ ] Run `launch.bat`. Windows that should open: portal (Docker), Face server, Security camera.
- [ ] Security camera window prints **`[detector] YOLO26 on directml-gpu1`**
      (graphics card). If it says `openvino-cpu` it still works, just slower - tell Claude.
- [ ] Portal: http://192.168.1.200 -> header shows "Portal OK".

## 1. Security camera - supervised acceptance of the GPU detector + re-ID fix (30-40 min)

What changed (commits ed56b8d, 8b48ae1): YOLO26s and person re-ID both run on the GTX 1650
(DirectML); re-ID no longer uses cv2.dnn batches, which gave WRONG embeddings whenever the
number of people changed. Offline on recorded frames the analysis pass went 179 -> 61 ms.
That is NOT the camera-to-portal delay - measure it live (E).

Write every result in a table: time | step | expected | seen | PASS / FAIL / UNCERTAIN.
Evidence: the console lines quoted (no camera address / password), timestamps, the /metrics
numbers Claude reads. Screenshots only if both participants agree; never commit them.

### A. Start-up (before anyone walks in)
- [ ] Close the old "Smart Lab - Security camera" window, run `launch.bat`. Note the time.
- [ ] Console shows, once each: `[detector] YOLO26 on directml-gpu1 (...)` and
      `[vision] re-id on directml-gpu1 (...)`. PASS = both lines, no "unavailable" / "EP Error"
      after them, and they do not repeat (a repeat = the model is being reloaded -> FAIL).
- [ ] If it says `openvino-cpu` / `onnxruntime-cpu`: still usable, mark "GPU NOT USED", continue.
- [ ] Portal Security camera page: picture LIVE and its clock advancing.
- [ ] Ask Claude to read `/metrics`: capture fps > 0, analysis fps ~5, frame age p50 < 1 s.
- [ ] **Zero frames / camera unreachable** (seen at home 2026-10-13): check the MC210 is powered
      and on Smart_Lab (192.168.1.155 pings), the laptop cable is in, then restart the camera
      window once. Still 0 frames -> stop section 1, mark BLOCKED, go on with sections 2-7.

### B. One person (participant 1)
- [ ] Enter, walk across, sit, stand, leave, come back after ~30 s.
- [ ] PASS: one box follows them; their name appears after the face is seen and stays on them;
      no second box/name for the same person. Any name on the wrong person = FAIL (note time).

### C. Two people (participants 1 + 2), repeat the whole sequence 3 times
Note who is who at the start. Then:
1. enter one after the other; 2. walk past each other (cross paths); 3. both sit;
4. swap seats; 5. one stands partly in front of the other (occlusion) for ~5 s;
6. one leaves the view, comes back after ~20 s; 7. both leave.
- [ ] After every step write each box's name. PASS = names still on the right people.
      A swap, a duplicate name, or a name on the wrong person = FAIL with the time.
      A box with no name / "Unknown" when the face is not visible = UNCERTAIN, not FAIL.
- [ ] Section C passes if all 3 repetitions have 0 FAIL.

### D. Crowd size (if 3+ people are available)
- [ ] 1 -> 2 -> 3+ people entering in different orders, then leaving in a different order.
- [ ] PASS: names stay correct as the count changes (exactly the case the old bug broke).

### E. Performance and stability (camera running 30+ min during the tests)
- [ ] Claude reads `/metrics` at start and end: detect_ms p50 (expect ~25-40 ms on the GPU),
      pass_ms p50, analysis fps (target 5 = the configured det-fps), frame age p95,
      reconnects, skipped frames. Record them.
- [ ] `nvidia-smi`: GPU memory stays roughly flat (offline: ~0.5 GB for both models).
- [ ] Camera-to-portal delay: wave a hand / clap with a phone stopwatch in view; compare the
      stopwatch time burned into the picture with the portal clock. Record the difference.
- [ ] Console: no repeating errors over 30 min.

### F. Acceptance
- PASS overall = A all PASS (or GPU NOT USED noted), B PASS, C 0 FAIL in 3 runs, D PASS or
  not possible, E: analysis fps >= 4, no memory growth, no repeating errors.
- Any identity FAIL: write the time, keep running, tell Claude - do NOT change thresholds in the lab.

### Rollback (only if section 1 fails badly - owner decides)
1. Fast, no code change: add the line `set SMARTLAB_REID=cpu` to
   `tools/security_vision/camera.env` (the start script reads `set` lines from it), restart the
   camera window -> re-ID on the CPU (correct embeddings, slower). `set SMARTLAB_DETECTOR=openvino`
   does the same for the detector. Remove the lines to go back.
2. Code: `git checkout snapshot/before-reid-gpu-20261013-0258 -- tools/security_vision/vision.py`
   restores the previous re-ID code ONLY (detector on GPU stays) - note it brings the
   batch bug back; `git checkout HEAD -- tools/security_vision/vision.py` undoes the rollback.
   Neither touches the database, door, robots, camera settings or other files.

## 2. Face enrolment - Nour (10 min)
- [ ] Users & roles -> Nour -> Face: "Remove saved face photos" -> Auto-capture ~25 -> Finish.
- [ ] Each photo saved in 1-4 s; rejected ones say why (too small / blurred / repeat).

## 3. Door + RFID (several cards per person, NEW - controller reflashed 2026-10-13)
- [ ] Users & roles -> a person -> RFID: "Enroll card at the door" -> tap card 1.
- [ ] "Add another card at the door" -> tap card 2. Both listed.
- [ ] Both cards open step 1 at the door.
- [ ] Remove card 1 only: card 1 refused, card 2 still works.
- [ ] Door tablet: System Devices -> "Door tablet screen" link opens http://192.168.1.151/.

## 4. Consumables bin (10k resistors, cup on the scale)
- [ ] Panel shows 30 (or what is really in the cup).
- [ ] Take 5 by hand (cup stays on): notification "5 pcs taken - 25 left (was 30)" within seconds.
- [ ] Put 5 back: "5 pcs added - 30 left (was 25)". Never above 30.
- [ ] If the count jumps with nothing moved: check the load-cell screws (mechanical shift seen 2026-10-13).

## 5. Reusables bin (breadboards)
- [ ] Equipment -> Reusables -> **Take an item**: tick 2 breadboards, pick a person -> lid opens -> take 2.
      Expect "2 of 2 taken", weight MATCH (~-66 g).
- [ ] Return: **scan the tag first**, lid opens, put it in -> "RETURN RECORDED", weight MATCH.
- [ ] Lid sensor: closed lid must read CLOSED (no "lid left open" fault).

## 6. Robots (read-only - nothing is ever sent to a robot)
- [ ] UR5e pendant: Settings > System > Network -> write the IP into
      `tools/robot_monitor/robot.env` (copy `robot.env.example`), then run `launch.bat` again.
      Expect the UR5e panel to go LIVE with real joint angles.
- [ ] FANUC: note the controller's IP (teach pendant: MENU > SETUP > Host Comm > TCP/IP).
      Then: `py tools/robot_monitor/fanuc_probe.py --robot <IP>` (read-only port/web check).

## 7. Photos for the lab galleries
- [ ] One photo per item, **no people in the frame** (public repo): conveyor, PLC stations,
      Power lab tanks / SCADA / HMI, and any lab you visit. Send them to Claude to crop and add.

## After the lab
- [ ] Say **"push"** if you want everything on GitHub.
