aliloay/smart-lab-portal/docs/knowledge/obsidian/vault/14 - Sources/tools_security_vision_test_crosscam.py.md

---
type: "source-mirror"
source_kind: "test-code"
source_path: "tools/security_vision/test_crosscam.py"
source_hash: "4507c055077dc69aacf50275921a0b7b6ad9a2bc25a2c1d442b048635c30aa8b"
generated: true
updated: "2026-11-04T00:02:39+02:00"
---
> Read-only mirror of `tools/security_vision/test_crosscam.py` - edit the original in the repository, not this note.

Systems: [[SecurityCam (vision)]]

## Related
- [[backend_app_services_identity.py]] - tests
- [[tools_security_vision_crosscam.py]] - tests
- [[tools_security_vision_vision.py]] - tests
- [[tools_security_vision_test_crosscam_2026_10_19.py]] - tests

```py
"""Cross-camera name sharing (SIMULATED: synthetic tracks and a synthetic floor map)."""
import time

from crosscam import ELIM_PASSES, STABLE_PASSES, CrossCam, FloorMap
from vision import Labeler, Track

W, H = 1000, 1000
# picture (0-1) -> floor: 10 m x 10 m room, identity-like map
FLOOR = FloorMap([{"px": [0, 0], "floor": [0, 0]}, {"px": [1, 0], "floor": [10, 0]},
                  {"px": [1, 1], "floor": [10, 10]}, {"px": [0, 1], "floor": [0, 10]}])

def box_at(x_m, y_m):          # a person standing at (x, y) metres -> box whose feet are there
    return (x_m * 100 - 40, y_m * 100 - 200, 80, 200)

def peer(now, *tracks, calibrated=True):
    return {"t": now, "calibrated": calibrated, "tracks": [
        {"id": i, "floor": [x, y], "label": lab, "name": lab, "role": "STUDENT", "source": src,
         "state": st, "crowded": cr} for i, x, y, lab, src, st, cr in tracks]}

def run(cc, tracks, lab, peer_fn, passes, t0=1000.0):
    for k in range(passes):
        now = t0 + k * 0.2
        cc.peer = peer_fn(now)
        cc.share(tracks, W, H, now, lab)

def test_confirmed_name_crosses_after_stable_passes_only():
    cc, lab = CrossCam(None, "k", FLOOR), Labeler()
    t = Track(1, box_at(3, 4), 0, 0, hits=10)
    pf = lambda now: peer(now, (7, 3.1, 4.0, "USER1", "door", "CONFIRMED", False))
    run(cc, [t], lab, pf, STABLE_PASSES - 1)
    assert t.label is None                          # not yet: pairing must hold
    run(cc, [t], lab, pf, 1, t0=2000.0)
    assert t.label == "USER1" and t.source == "peer"

def test_last_unnamed_person_gets_the_last_free_name():
    # 2026-11-03 lab: Nour named on both cameras; Ali named by face on camera 2 but sitting at its bottom
    # edge (no floor position) - camera 1 names him by elimination, after the same stable passes.
    cc, lab = CrossCam(None, "k", FLOOR), Labeler()
    nour, ali = Track(1, box_at(3, 4), 0, 0, hits=10), Track(2, box_at(7, 8), 0, 0, hits=10)
    nour.label = "USER6"
    pf = lambda now: {"t": now, "calibrated": True, "tracks": [
        {"id": 8, "floor": [3.05, 4.0], "label": "USER6", "name": "USER6", "role": "STUDENT", "source": "face",
         "state": "CONFIRMED", "crowded": False},
        {"id": 9, "floor": None, "label": "USER1", "name": "USER1", "role": "STUDENT", "source": "face",
         "state": "CONFIRMED", "crowded": False}]}
    run(cc, [nour, ali], lab, pf, ELIM_PASSES - 1)
    assert ali.label is None
    run(cc, [nour, ali], lab, pf, 1, t0=2000.0)
    assert ali.label == "USER1" and nour.label == "USER6"

def test_not_shared_without_floor_map_or_when_stale():
    lab = Labeler()
    t = Track(1, box_at(3, 4), 0, 0, hits=10)
    cc = CrossCam(None, "k", None)
    run(cc, [t], lab, lambda now: peer(now, (7, 3, 4, "USER1", "door", "CONFIRMED", False)), 10)
    assert t.label is None
    cc = CrossCam(None, "k", FLOOR)
    run(cc, [t], lab, lambda now: peer(now - 5, (7, 3, 4, "USER1", "door", "CONFIRMED", False)), 10)
    assert t.label is None

def test_unconfirmed_or_guessed_names_do_not_travel():
    for src, st in (("door", "CANDIDATE"), ("desk", "CONFIRMED"), ("look", "CONFIRMED")):
        cc, lab = CrossCam(None, "k", FLOOR), Labeler()
        t = Track(1, box_at(3, 4), 0, 0, hits=10)
        run(cc, [t], lab, lambda now: peer(now, (7, 3, 4, "USER1", src, st, False)), 10)
        assert t.label is None, (src, st)

def test_two_people_side_by_side_are_not_named_by_the_floor_alone():
    # 2026-11-03 lab: with two people in view and no measured look, the floor moved Nour's name onto Ali.
    # Now nobody gets a name that way - each person's own face (or a clear look) must name them.
    cc, lab = CrossCam(None, "k", FLOOR), Labeler()
    a, b = Track(1, box_at(3.0, 4), 0, 0, hits=10), Track(2, box_at(3.6, 4), 0, 0, hits=10)
    pf = lambda now: peer(now, (8, 3.62, 4.0, "USER2", "face", "CONFIRMED", False),
                          (7, 3.02, 4.0, "USER1", "door", "CONFIRMED", False))
    run(cc, [b, a], lab, pf, 10)
    assert a.label is None and b.label is None

def test_crowded_or_conflicting_or_face_contradicted_never_changes():
    lab = Labeler()
    cc = CrossCam(None, "k", FLOOR)
    t = Track(1, box_at(3, 4), 0, 0, hits=10, crowded=True)
    run(cc, [t], lab, lambda now: peer(now, (7, 3, 4, "USER1", "door", "CONFIRMED", False)), 10)
    assert t.label is None                          # touching someone: wait
    t2 = Track(2, box_at(5, 5), 0, 0, hits=10, label="USER2", name="Nour", source="door")
    run(cc, [t2], lab, lambda now: peer(now, (9, 5, 5, "USER1", "door", "CONFIRMED", False)), 10)
    assert t2.label == "USER2"                      # conflict: nothing changes
    assert any(n["kind"] == "CROSSCAM_CONFLICT" for n in cc.notes)
    t3 = Track(3, box_at(6, 6), 0, 0, hits=10)
    lab.face_vote(3, "USER2", time.time()); lab.face_vote(3, "USER2", time.time())
    run(cc, [t3], lab, lambda now: peer(now, (4, 6, 6, "USER1", "door", "CONFIRMED", False)), 10)
    assert t3.label is None                         # its own face says someone else

def test_name_already_on_someone_here_is_not_duplicated():
    cc, lab = CrossCam(None, "k", FLOOR), Labeler()
    have = Track(1, box_at(1, 1), 0, 0, hits=10, label="USER1", name="Ali", source="door")
    t = Track(2, box_at(5, 5), 0, 0, hits=10)
    run(cc, [have, t], lab, lambda now: peer(now, (7, 5, 5, "USER1", "door", "CONFIRMED", False)), 10)
    assert t.label is None

def test_far_apart_is_not_the_same_person():
    cc, lab = CrossCam(None, "k", FLOOR), Labeler()
    t = Track(1, box_at(3, 4), 0, 0, hits=10)
    run(cc, [t], lab, lambda now: peer(now, (7, 4.5, 4, "USER1", "door", "CONFIRMED", False)), 10)
    assert t.label is None                          # 1.5 m away > gate

def test_states_the_identity_ledger_really_produces_are_shared_and_doubtful_ones_are_not():
    """2026-10-18: the shared states must be the ledger's own (DOOR_CONFIRMED ...), not made-up ones."""
    from identity import STATES
    from crosscam import SHARE_STATES
    assert {"DOOR_CONFIRMED", "FACE_CONFIRMED", "FUSED_CONFIRMED", "REID_CONFIRMED"} <= SHARE_STATES
    assert not ({"UNKNOWN", "TENTATIVE", "OCCLUDED", "IDENTITY_UNCERTAIN", "IDENTITY_CONFLICT"} & SHARE_STATES)
    assert {"DOOR_CONFIRMED", "FUSED_CONFIRMED"} <= set(STATES)
    for st, shared in (("DOOR_CONFIRMED", True), ("IDENTITY_UNCERTAIN", False), ("IDENTITY_CONFLICT", False)):
        cc, lab = CrossCam(None, "k", FLOOR), Labeler()
        t = Track(1, box_at(3.0, 4.0), 0.0, 0.0)
        run(cc, [t], lab, lambda now: peer(now, (7, 3.0, 4.0, "USER1", "door", st, False)), 10)
        assert (t.label == "USER1") is shared, st

def test_elimination_refuses_people_far_apart_on_the_floor():
    # Gemini ACT-06: same head count, but the free person here stands 7 m from the free name there -
    # two different people in each camera's blind spot; no name by elimination.
    cc, lab = CrossCam(None, "k", FLOOR), Labeler()
    nour, other = Track(1, box_at(3, 4), 0, 0, hits=10), Track(2, box_at(7, 8), 0, 0, hits=10)
    nour.label = "USER6"
    pf = lambda now: peer(now, (8, 3.05, 4.0, "USER6", "face", "CONFIRMED", False),
                          (9, 2.0, 2.0, "USER1", "face", "CONFIRMED", False))
    run(cc, [nour, other], lab, pf, ELIM_PASSES + 2)
    assert other.label is None

```
