aliloay/smart-lab-portal/docs/knowledge/obsidian/vault/14 - Sources/tools_robot_monitor_test_control_source.py.md

---
type: "source-mirror"
source_kind: "test-code"
source_path: "tools/robot_monitor/test_control_source.py"
source_hash: "66a4b09b3d7dabdb8e7d4753e054b8987f2da1369792a21f085aadf0db9ff272"
generated: true
updated: "2026-11-04T00:02:39+02:00"
---
> Read-only mirror of `tools/robot_monitor/test_control_source.py` - edit the original in the repository, not this note.

Systems: [[Robots (read-only)]]

## Related
- [[tools_robot_monitor_control_source.py]] - tests

```py
"""Who is driving the UR5e - pure classification (no robot) + the reader refuses non-queries."""
import pytest

from control_source import DashboardReader, classify

def test_hand_guiding_wins():
    assert classify({"robot_status_bits": 0b111, "remote_control": True}, True)[0] == "HAND_GUIDING"

def test_local_mode_is_the_pendant():
    code, text = classify({"remote_control": False}, True)
    assert code == "PENDANT" and "jogging" in text
    code, text = classify({"remote_control": False, "program_state": "PLAYING home.urp", "loaded_program": "home.urp"}, True)
    assert code == "PENDANT_PROGRAM" and "home.urp" in text

def test_local_mode_tells_jogging_programs_and_a_computer_apart():
    """2026-10-21: 'Moving - by teach pendant' while another person moved it."""
    loc = {"remote_control": False}
    assert classify(loc, True, 1) == ("PENDANT", "Teach pendant (Local mode) - jogging")
    assert classify(loc, True, 4)[0] == "MULTI_JOINT"
    assert classify(loc, True, None)[0] == "PENDANT"                     # joints not known: as before
    assert classify({**loc, "program_state": "PLAYING x", "loaded_program": "external_control.urp"}, True, 6)[0] == "EXTERNAL_CONTROL"
    assert classify({**loc, "program_state": "PLAYING x", "loaded_program": "pick.urp"}, True, 6)[0] == "PENDANT_PROGRAM"
    assert classify({"remote_control": True, "program_state": "PLAYING x", "loaded_program": "ros_control.urp"}, True)[0] == "EXTERNAL_CONTROL"

def test_remote_program_vs_direct_commands():
    assert classify({"remote_control": True, "program_state": "PLAYING x", "loaded_program": "home.urp"}, True)[0] == "REMOTE_PROGRAM"
    assert classify({"remote_control": True, "program_state": "STOPPED x", "robot_status_bits": 1}, True)[0] == "REMOTE_DIRECT"
    assert classify({"remote_control": True, "program_state": "STOPPED x"}, False)[0] == "IDLE"

def test_unknown_when_dashboard_not_readable():
    assert classify({}, True)[0] == "UNKNOWN"
    assert classify({}, False)[0] == "IDLE"

def test_reader_refuses_commands():
    r = DashboardReader("127.0.0.1")
    for cmd in ("play", "stop", "load home.urp", "power off", "unlock protective stop"):
        with pytest.raises(ValueError):
            r.ask(cmd)

def test_commanded_speed_separates_pendant_linear_jog_from_freedrive():
    # Gemini ACT-07 (2026-11-03): a Base/Tool linear jog turns several joints - it was "Move / Home or other".
    local = {"remote_control": False, "robot_status_bits": 1, "program_state": "STOPPED"}
    assert classify({**local, "target_qd_max": 0.3}, True, 4)[0] == "PENDANT"
    assert classify({**local, "target_qd_max": 0.0}, True, 2)[0] == "HAND_GUIDING"
    assert classify({**local, "target_qd_max": None}, True, 3)[0] == "MULTI_JOINT"   # not reported: as before
    assert classify({**local, "target_qd_max": 0.0}, False, 0)[0] == "PENDANT"       # still: idle

```
