aliloay/smart-lab-portal/docs/knowledge/obsidian/vault/14 - Sources/tools_security_vision_test_scenario_bench.py.md

---
type: "source-mirror"
source_kind: "test-code"
source_path: "tools/security_vision/test_scenario_bench.py"
source_hash: "83479e6d591d87885ad242528706e59600cb0516397dc40ac5cd09128219ecf7"
generated: true
updated: "2026-11-04T00:02:39+02:00"
---
> Read-only mirror of `tools/security_vision/test_scenario_bench.py` - edit the original in the repository, not this note.

Systems: [[SecurityCam (vision)]]

## Related
- [[tools_security_vision_scenario_bench.py]] - tests

```py
"""The simulated identity scenarios (scenario_bench.py) as a regression test - SIMULATED evidence:
in every defined scenario nobody is ever shown with someone else's name, names never switch, and a
confirmed name crosses to the second camera (2026-10-18)."""
import pytest

import scenario_bench as B

@pytest.mark.parametrize("name", list(B.SCENARIOS))
@pytest.mark.parametrize("noise,miss", [(0.10, 0.04), (0.18, 0.10)])
def test_no_false_names_and_no_name_switches(name, noise, miss):
    for seed in range(3):
        r = B.run(name, B.SCENARIOS[name], seed=seed, miss=miss, deep_noise=noise)
        assert r["false_names"] == 0 and r["name_switches"] == 0, (seed, r)

def test_two_entering_together_on_one_badge_stay_unknown_and_are_flagged():
    r = B.run("02", B.SCENARIOS["02 two enter together, one badge"])
    assert r["named_share"] == 0.0 and r["review"] >= 1

def test_a_confirmed_name_reaches_the_second_camera_and_never_the_stranger():
    cam1, cam2 = B.run_two_cameras()
    assert cam2["named_share"] > 0.5 and cam2["false_names"] == 0 and cam1["false_names"] == 0

```
