aliloay/smart-lab-portal/docs/media/portal/dev_captures/rel_performance.png

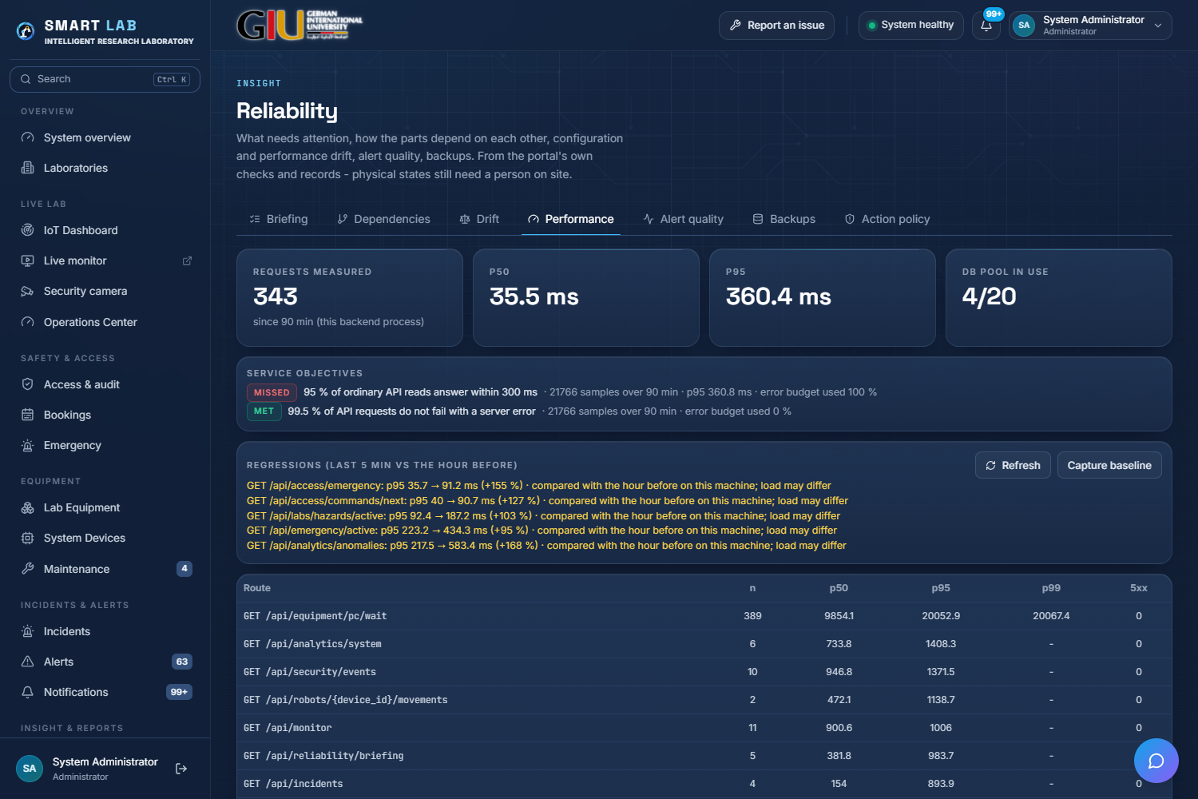
docs/media/portal/dev_captures/rel_performance.png
