aliloay/smart-lab-portal/docs/paper_figures/portal_2026-10-19/26_reliability_performance.png

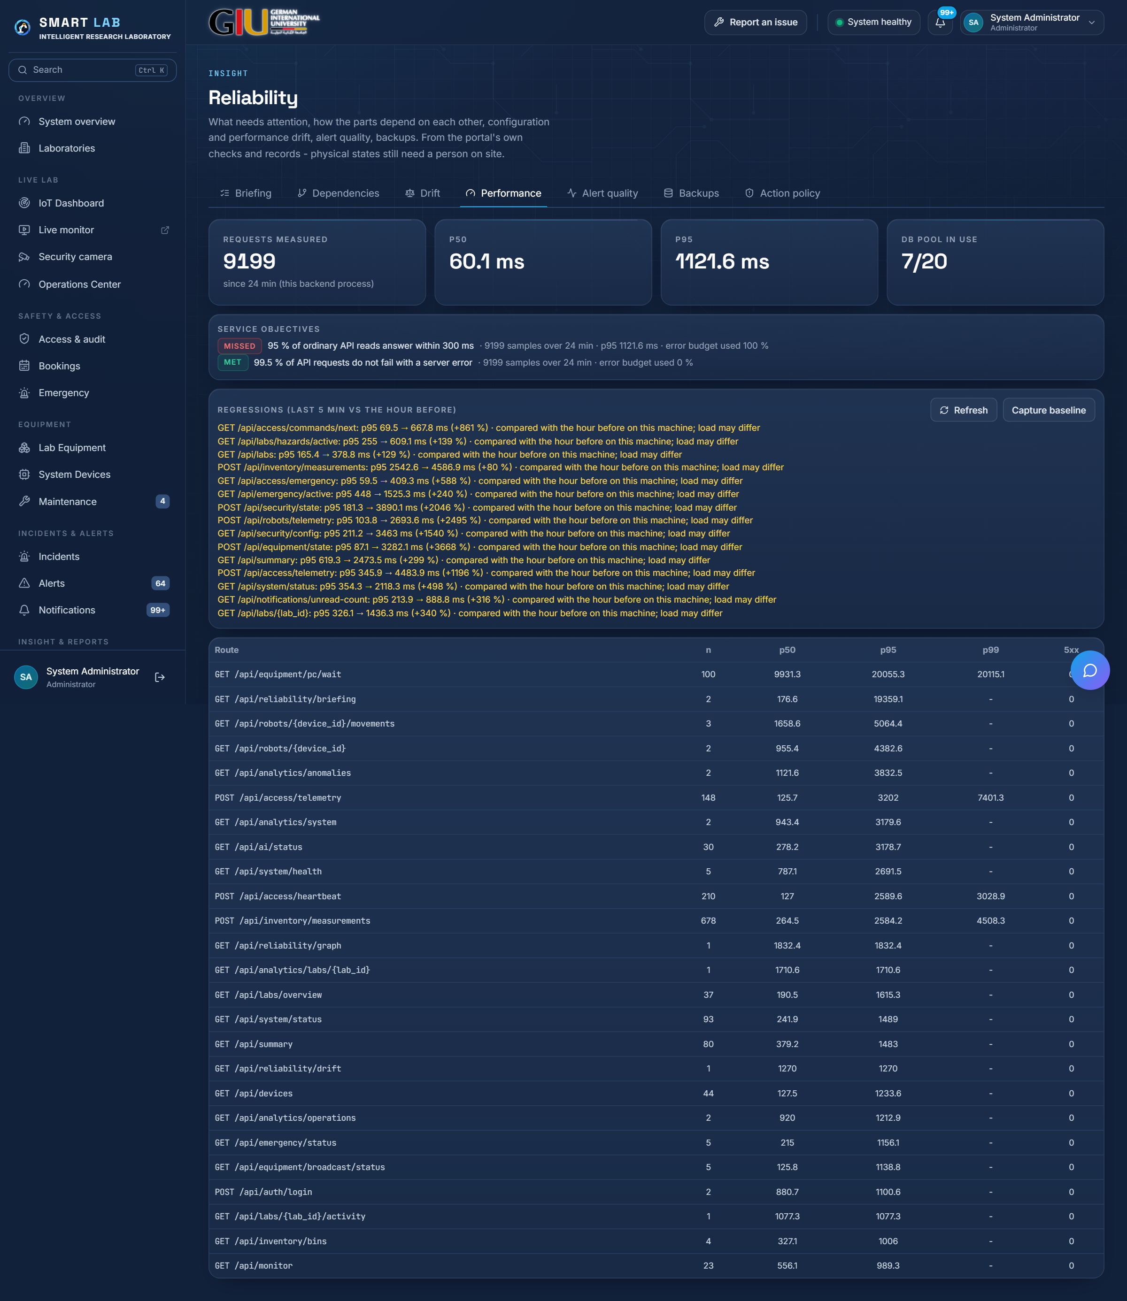
docs/paper_figures/portal_2026-10-19/26_reliability_performance.png
