aliloay/smart-lab-portal/docs/knowledge/obsidian/vault/00 - Home/Missing-History-and-Knowledge-Gaps.md

---
type: "gaps"
generated: true
updated: "2026-11-04T00:01:22+02:00"
---

# Missing history and knowledge gaps

Earliest conversation record found: **2026-09-13T12:51:07.322178+00:00**. First commit: **2026-09-24T20:33:07+03:00**.

## Known missing
- Any ChatGPT chat not shared yet: put its decoded share JSON or a `conversations.json` export in `C:\Users\dell\SmartLabKnowledge\inbox_raw`, then run `history.py import`.
- Screenshots shared in the first Claude Code session (24 Sep): only their file names are in the transcript.
- Live database contents: not read (only the model definitions).
- Application logs: no log files found in the repository.

## Import ledger
| Source | Records | Redactions | Error |
|---|---|---|---|
| git | 405 | 0 |  |
| claude:3b9b3107 | 6674 | 26 |  |
| chatgpt-file:chatgpt_share_6ace9676.json | 363 | 1 |  |
| chatgpt-file:chatgpt_share_6ace98a9.json | 447 | 5 |  |
| chatgpt-file:chatgpt_share_6ace98d6.json | 750 | 0 |  |
| chatgpt-file:chatgpt_share_6ace98fe.json | 8 | 0 |  |
| schema | 41 | 0 |  |
