aliloay/smart-lab-portal/docs/knowledge/obsidian/vault/05 - n8n Workflows/Smart Lab 13 - Environment hazard escalation.md

---
type: "n8n-workflow"
workflow_id: "8R9NX3QAakjrJSai"
status_in_file: "inactive"
live_status: "active"
live_checked: "2026-11-04T00:02:25+02:00"
live_matches_file: true
source_path: "automation/n8n/json/13-environment-hazard-escalation.json"
source_hash: "b67afba84d580e12a5ea0d799ba0562f460822c4361a74ee29f0582faa17c555"
generated: true
updated: "2026-11-04T00:02:39+02:00"
tags: ["n8n"]
---

# Smart Lab 13 - Environment hazard escalation

> Generated from `automation/n8n/json/13-environment-hazard-escalation.json` (sha256 b67afba84d58). Configured behaviour, not observed runs.

## Live state
**active** in the running n8n (export of 2026-11-04T00:02:25+02:00). Nodes and connections match this file.

## Purpose
## Environment hazard escalation
The backend alerts at once when smoke, flame, a leak or the emergency signal is reported; this re-notifies when it is still active after 5 min. Indicators only - not a certified fire or safety system.

## Triggers
- scheduleTrigger: `{"interval": [{"field": "minutes", "minutesInterval": 5}]}`

## Flow
```mermaid
flowchart LR
  n0["Every 5 Minutes<br/><small>scheduleTrigger</small>"]
  n1["Check In Backend<br/><small>httpRequest</small>"]
  n2["One Item Per Finding<br/><small>splitOut</small>"]
  n3["Notify Staff<br/><small>httpRequest</small>"]
  n4["Record Run<br/><small>httpRequest</small>"]
  n0 --> n1
  n1 --> n2
  n2 --> n3
  n3 --> n4
```

## Endpoints called (host redacted)
- `GET <host>/api/automation/robotics/hazards` - Check In Backend
- `POST <host>/api/automation/notify` - Notify Staff
- `POST <host>/api/automation/runs` - Record Run

## Changes data
Yes - uses POST/PUT/PATCH/DELETE

## Credentials (references only, never values)
- httpHeaderAuth:Smart Lab automation key

## External services
- none found: all calls go to the local backend

## Related
- [[Environment monitoring]] (system)
- [[backend_app_api_routes_automation.py]] (code it calls)
- [[n8n automation]] (system)

Back to [[Home]] · [[Workflow catalogue]]
