aliloay/smart-lab-portal/docs/paper_figures/portal_2026-10-19/18_maintenance.png

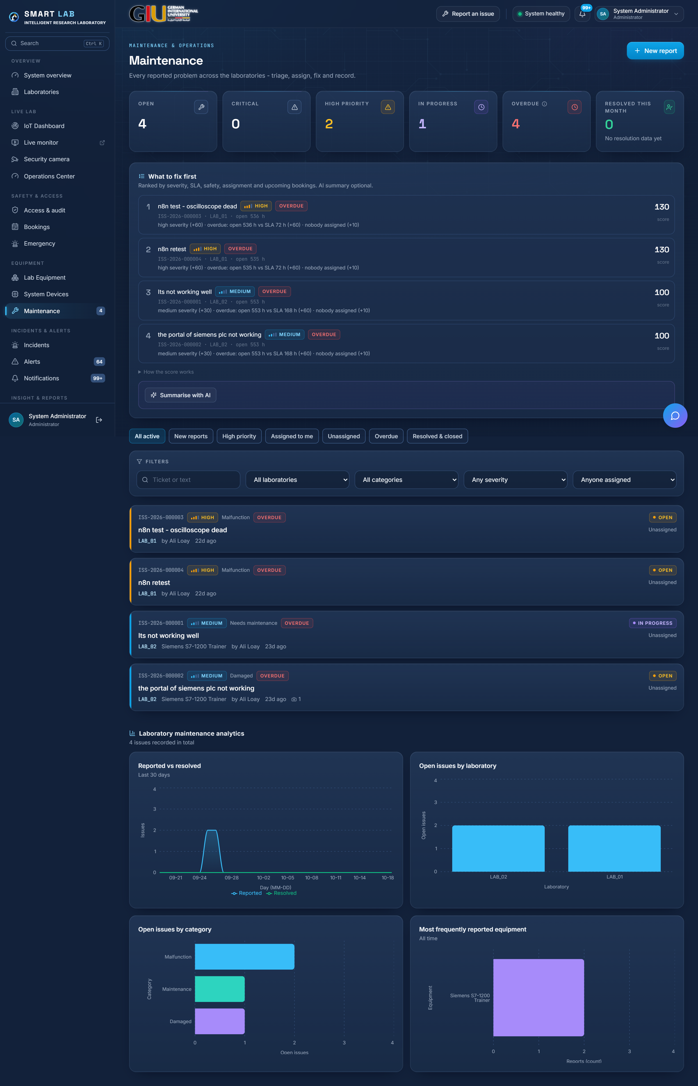
docs/paper_figures/portal_2026-10-19/18_maintenance.png
