aliloay/smart-lab-portal/tools/cad/door_enclosure/out_owner_backup_2026-10-24/DoorEnclosure_Drawings.pdf

# Front panel - front view

seen from the corridor; dashed = rear features (pockets, bosses, cradles); purple = engraved

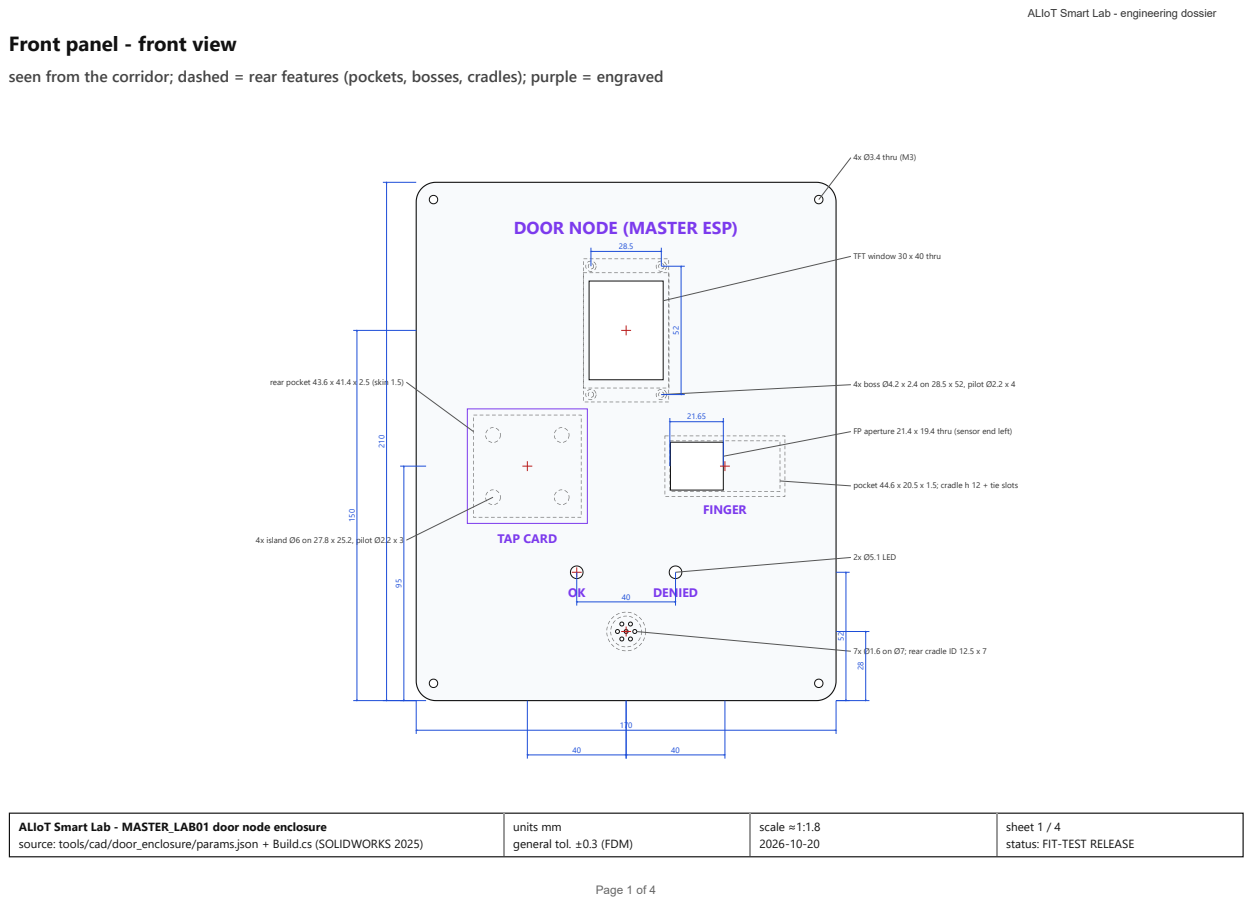
[picture p141: page 1]
4x Ø3.4 thru (M3); 2x Ø5.1 LED; TAP CARD; FINGER; DENIED; scale ≈1:1.8 2026-10-20

ALIoT Smart Lab - engineering dossier

DOOR NODE (MASTER ESP)

TFT window 30 x 40 thru

rear pocket 43.6 x 41.4 x 2.5 (skin 1.5)

4x boss Ø4.2 x 2.4 on 28.5 x 52, pilot Ø2.2 x 4

FP aperture 21.4 x 19.4 thru (sensor end left)

pocket 44.6 x 20.5 x 1.5; cradle h 12 + tie slots

4x island Ø6 on 27.8 x 25.2, pilot Ø2.2 x 3

7x Ø1.6 on Ø7; rear cradle ID 12.5 x 7

ALIoT Smart Lab - MASTER_LAB01 door node enclosure
source: tools/cad/door_enclosure/params.json + Build.cs (SOLIDWORKS 2025)

units mm
general tol. ±0.3 (FDM)

sheet 1 / 4
status: FIT-TEST RELEASE

# Body - bottom wall and left wall

## cable entries (bottom) and ESP32 USB access + vents (left)

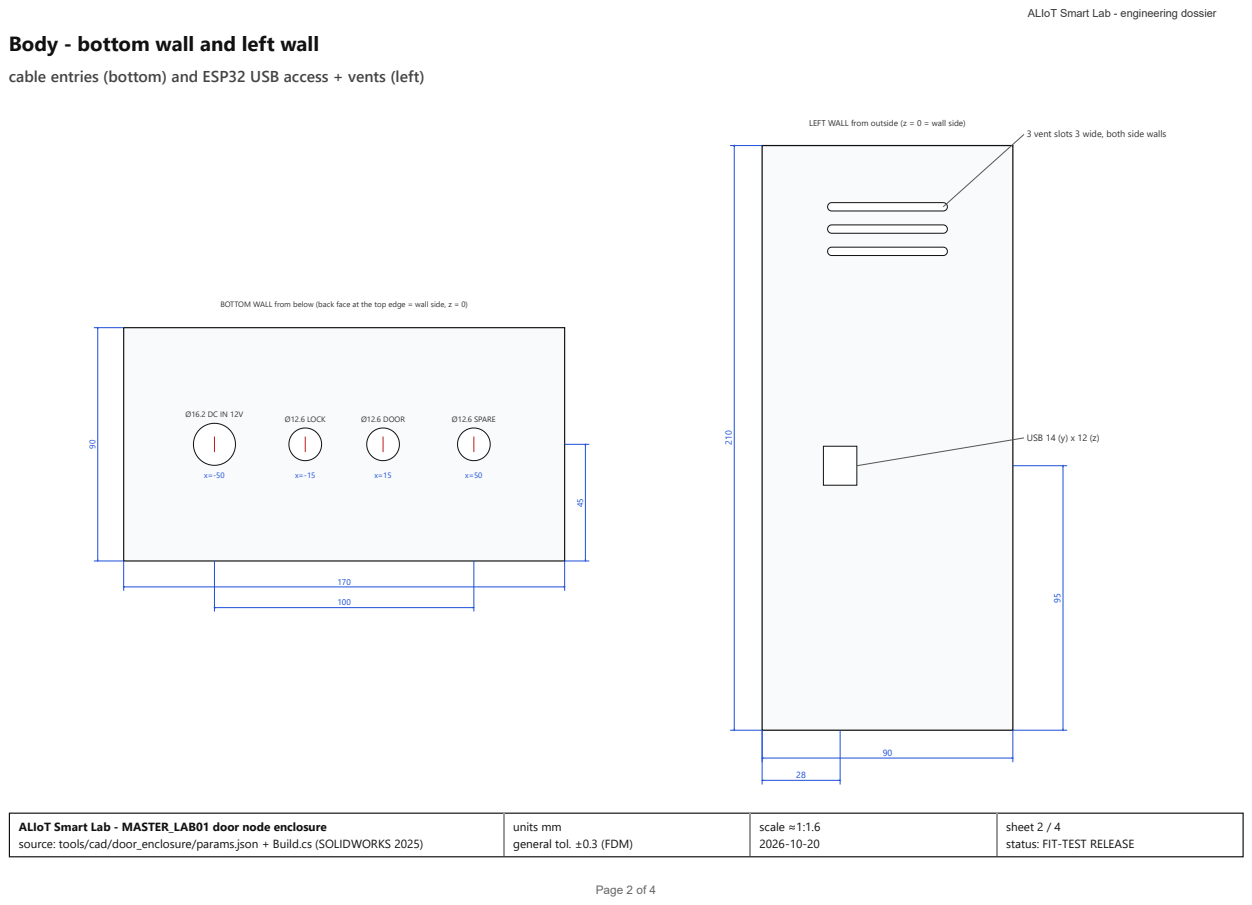
[picture p142: page 2]
Ø12.6 LOCK; Ø12.6 DOOR; Ø12.6 SPARE; USB 14 (y) x 12 (z); units mm; scale ≈1:1.6; sheet 2 / 4

LEFT WALL from outside (z = 0 = wall side)

3 vent slots 3 wide, both side walls

BOTTOM WALL from below (back face at the top edge = wall side, z = 0)

ALIoT Smart Lab - MASTER_LAB01 door node enclosure

# Electronics plate - layout

## component envelopes as used in the SOLIDWORKS interference check

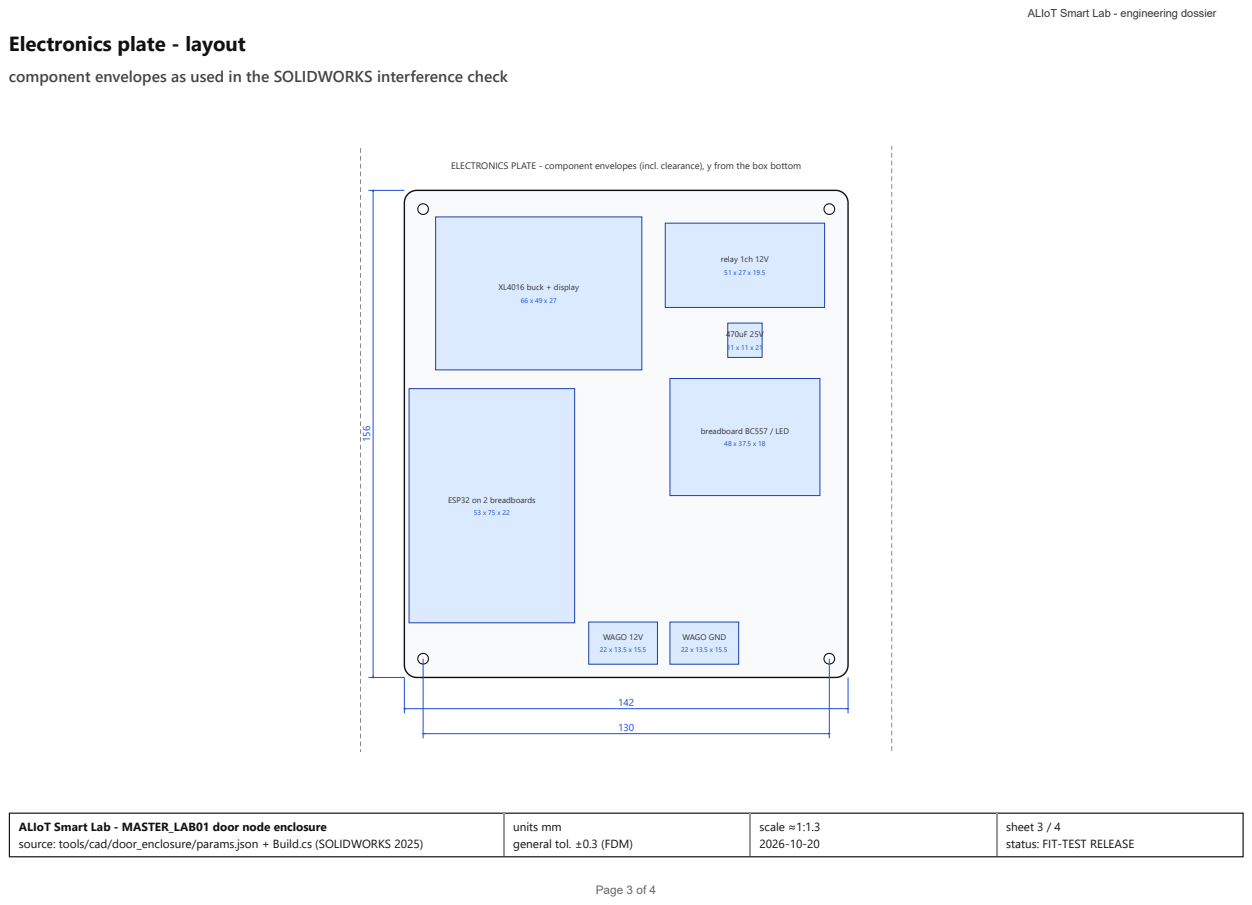
[picture p143: page 3]
XL4016 buck + display 66 x 49 x 27; relay 1ch 12V 51 x 27 x 19.5; ESP32 on 2 breadboards 53 x 75 x 22; breadboard BC557 / LED 48 x 37.5 x 18; WAGO 12V 22 x 13.5 x 15.5; WAGO GND 22 x 13.5 x 15.5; units mm; scale ≈1:1.3; sheet 3 / 4

ELECTRONICS PLATE - component envelopes (incl. clearance), y from the box bottom

ALIoT Smart Lab - MASTER_LAB01 door node enclosure

# Component envelopes

## every box in the virtual assembly, with where its size comes from

Envelope | w x h x d (incl. clearance) | centre x, y; base z | confidence | source
XL4016 buck + display | 66 x 49 x 27 | -28, 163, z 13 up | VARIANT (Most listing ~64 x 47 x 26) +1 | mostelectronic.com XL4016 8A display
relay 1ch 12V | 51 x 27 x 19.5 | 38, 172, z 13 up | REFERENCE 50 x 26 x 18.5 +1 | generic SRD-12VDC module
470uF 25V | 11 x 11 x 21 | 38, 148, z 13 up | REFERENCE D10 x 20 radial | typical 470uF 25V
ESP32 on 2 breadboards | 53 x 75 x 22 | -43, 95, z 13 up | VARIANT ESP32 51.5 x 28.5; REFERENCE SYB-170 47 x 36.5 x 10 (x2) | Most ESP32 30-pin; Most ME-29142
breadboard BC557 / LED | 48 x 37.5 x 18 | 38, 117, z 13 up | REFERENCE SYB-170 + parts 8 mm | Most ME-29142
WAGO 12V | 22 x 13.5 x 15.5 | -1, 51, z 13 up | VARIANT PCT-212 21 x 12.5 x 14.5 +1 | Most WAGO PCT-212
WAGO GND | 22 x 13.5 x 15.5 | 25, 51, z 13 up | VARIANT PCT-212 +1 | Most WAGO PCT-212
TFT glass | 34.9 x 46.9 x 2.4 | 0, 150, z 90 down | DATASHEET 34.7 x 46.7 x 2.4 +0.2 | QDTFT1801
TFT PCB + header plugs | 34.5 x 58 x 15.6 | 0, 150, z 87.6 down | VARIANT PCB 1.6 + plugs 14 | LCDWIKI MSP1803
PN532 + header plugs | 43 x 41 x 17.6 | -40, 95, z 90 down | VARIANT 42.7 x 40.4; plugs 16 REFERENCE | Ekostra EK506 / Elechouse
R307 body + connector | 44.6 x 20.5 x 26.7 | 40, 95, z 91.5 down | DATASHEET 44.1 x 20 x 23.5 + 3.2 connector | GROW R307 manual
LED green + wires | 6 x 6 x 16 | -20, 52, z 90 down | REFERENCE flange 5.9 | Kingbright L-53
LED red + wires | 6 x 6 x 16 | 20, 52, z 90 down | REFERENCE flange 5.9 | Kingbright L-53
active buzzer D12 | 12.4 x 12.4 x 21 | 0, 28, z 90 down | DATASHEET TMB12A05 (cylinder D12.4) 12 x 9.5 + pins 5.5 + wires | Huaneng TMB12A05 / Most ME-32997
ALIoT Smart Lab - MASTER_LAB01 door node enclosure

units mm

scale -

sheet 4 / 4
