aliloay/smart-lab-portal/(commit log)

2026-09-24 Initial commit: Smart Lab Portal
    FastAPI backend, React frontend, and ESP32 door firmware for lab
    booking and multi-factor access control.
2026-09-24 README: add features, screenshots, and current setup steps
    Adds a feature summary, tech badges and a screenshot gallery of the
    student and admin portal. Updates the test instructions for
    requirements-dev.txt and a dedicated test database, documents the
    firmware secrets.h setup, and corrects the test count to 61.
2026-09-24 test(backend): cover maintenance, traceability, privacy and live stream
    73 new tests on real PostgreSQL: issue permissions and scoping, invalid
    asset/lab combinations, photo validation (bad files, formats, size,
    all-or-nothing batches, EXIF stripping, scaling, private file access),
    acknowledgement, assignment, transitions, resolution, admin close/reopen,
    escalation, the ordered audit trail, internal notes, asset and lab links,
    SLA overdue; session honesty (door close is not exit), full booking trace,
    availability without identity, role scoping, notifications, device
    offline detection, and WebSocket auth plus cross-thread delivery.
2026-09-24 feat(frontend): smart lab platform - role experiences, maintenance, traceability
    Visual system
    - brighter blue-grey palette, display typography, original Smart Lab mark
    and favicon; a slot for the official GIU logo without redrawing it
    - nine original category illustrations (labelled as illustrations), an
    articulated robot arm whose joints move, a live laboratory network map
    and a door schematic whose lights come from real device state
    - defines the card/page-title/skeleton classes several pages used but the
    stylesheet never declared, which left those surfaces unstyled
    Roles
    - separate student, staff and admin dashboards and navigation; admins no
    longer get student entries; staff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
2026-09-24 docs: README for maintenance, traceability, tests and new screenshots
    Documents the issue workflow, why an exit is only recorded when observed,
    the new privacy rules, 134 backend tests plus the browser navigation test,
    the schema guard on upgrade, the optional heartbeat components and
    EXIT_RECORDED event, and new limitations. Screenshots are of the new UI
    with demo data, labelled as such.
2026-09-25 feat(backend): asset lifecycle, access session detail, security notifications
    Asset lifecycle
    - serial number, current holder (set on checkout, cleared on return),
    last inspection and next maintenance on every asset
    - POST /assets/{id}/inspect records an inspection and the next due date;
    /assets?due=true lists overdue maintenance
    - asset detail returns one lifecycle timeline: issues reported/resolved,
    inspections, status changes and (for staff) check-outs
    - only the borrower or staff can return an item; holder names are staff-only
    Access sessions
    - GET /access-sessions/{id}: a visit traced end to end - booking if any,
    both factors and identities, grant, door cycle, exit only if reco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
2026-09-25 feat(frontend): asset lifecycle, live access session, simulation mode
    - asset page: asset record (ID, type, lab, location, serial, status,
    current user for staff, last inspection, next maintenance with overdue
    flag), record-inspection and edit actions, a lifecycle timeline next to
    the maintenance history
    - equipment list: serial, current user, inspection and maintenance
    columns, overdue filter and count
    - access session page (/sessions/:id): user, lab, booking or card entry,
    both factors with identities, result, door cycle, entry vs reserved,
    exit only if recorded, and an inspectable event timeline; reachable from
    the access monitor, any door event and the booking trace
    - share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
2026-09-25 fix(security): compare the device API key in constant time
2026-09-25 ui: never present an offline controller's last report as live
    - Devices: component states from an offline controller are marked
    (last reported) with when, instead of green 'Ready/Locked'
    - Laboratory panel: unknown states read 'Not reported'; 'Nobody inside'
    is a normal state, not a fault colour; booking times no longer wrap
    - Dashboards: the tile counting all door devices is labelled
    'Door devices online', not 'Access controllers'
2026-09-25 test: cancellation and new-report notifications; maintenance workflow in the browser
    - backend: staff cancelling notifies the owner (and not themselves),
    own cancellations are silent, new reports reach staff and admins only
    - e2e: staff acknowledge, assign, internal note, after-photo, resolve;
    admin close and reopen; the reporter never sees the internal note and
    is notified; access session opened from the monitor's Sessions tab
    - e2e_booking_to_door.py: E2E_API / DEVICE_API_KEY so it can target a
    QA instance instead of the default API
2026-09-25 docs: architecture, database, access flow, maintenance and demo guides
    README links them, reflects 153 tests and the browser workflow suite, and
    warns that the scripted door run writes to its database. pg_dump backups
    are git-ignored.
2026-09-25 test(qr): judge each distance over a hand-held frame window, not one frame
    A single exact frame at a random token hits a moire null 1.5% of the time
    (4.6% at 280px), which failed CI on an unchanged pipeline. The camera
    analyses ~4 frames a second while the phone drifts, so the test now passes
    when a frame within +-8px of the distance decodes: 0.06% over 5000 tokens.
2026-09-25 feat: launch.bat - checks Docker, prints the LAN address, runs docker compose up
    No second startup system: it runs the same compose command. The address
    it prints is the one phones and the firmware's BACKEND_IP must use.
2026-09-25 ci: start the compose stack and check it from outside
    The portal on :80 as a phone uses it (page, deep links, API, live
    WebSocket, 2 MB photo upload) and the API on :8000 as the ESP32 master
    calls it (booking QR validated to the student's identity, device key
    required). Restarting the API proves re-seeding is harmless.
2026-09-25 fix(qr): never issue a booking QR the door cannot read
    About 1 in 150 random tokens (0.66% over 5,000) renders to a QR that the
    door's decoder - cv2.QRCodeDetector 4.10, as in face_server.py - cannot read
    even from a perfect image: a data/mask combination, each such token decodes
    under 7 of the 8 masks. That booking could never be opened. CI caught two.
    - app/services/qr.py: the one place the credential is drawn, and
    issue_token(), which decodes each new token with the door's detector and
    draws again if it is unreadable
    - OpenCV (same pin) moves from test-only to runtime dependencies
    - QR tests use the app's renderer and issued tokens; new tests pin the two
    known-unreadable tokens, th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
2026-09-25 ui: sidebar for navigation, header for system and account, GIU quieter
    - the large GIU logo leaves the sidebar; a small GIU mark sits at the left
    of the desktop header (and at the foot of the phone drawer, which has no
    desktop header)
    - header: Report an issue, then system status, notifications and account,
    set apart by a divider
    - the sidebar's spare space shows the door at a glance: controller,
    door sensor and next booking for the laboratory with door hardware,
    from the same endpoint as the laboratory page; unknown values read
    'Not reported', an offline controller's last report is marked as such,
    and nothing is shown when no laboratory has door hardware
    - navigation and the c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
2026-09-25 ui: cyber-glass design language, applied through the shared primitives
    Visual only - no page logic, routing, API or behaviour changes. Every page
    picks it up through the components it already uses:
    - cards: translucent blue-grey glass with a light blur, one thin border,
    a soft shadow; hover lifts slightly and warms the border, no glow
    - wells, tables, inputs, dividers: the same glass family, hairline rules
    - top bar and sidebar are glass layers; Report an issue, system status,
    notifications and account are matching compact glass controls
    - active navigation: a subtle cyan wash and a faintly lit indicator
    - glow reserved and softened: primary button, focus, the few glow states
    - violet a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
2026-09-25 Fix 'QrAuthResult does not name a type' compile error
    Arduino's auto-generated prototypes are inserted above the first function,
    before the struct was defined. Move QrAuthResult up next to AuthorizedUser.
    Claude-Session: https://claude.ai/code/session_01JeVQYHhcqZz1kEZv2TNKDi
    [SmartLab_Master_Portal.ino]
2026-09-25 Book: 'Test QR now' - book the lab from now for 30 min and open the QR
    Lets the door be tested at any hour, including late at night when every
    slot in the 08:00-22:00 grid is already in the past.
    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
2026-09-25 Book: 'Exact time (AM/PM)' tab to pick any start/end to the minute
    The hour grid only offers whole hours between 08:00 and 22:00, so after
    10 PM nothing can be booked. The new tab takes hour, minute and AM/PM for
    start and end (an end before the start runs past midnight), with 'Now ->
    +30 min / +1 h' shortcuts. Review and the summary rail show the window in
    12-hour time.
    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
2026-09-25 Camera link: keep-alive face server, backoff on failed frames
    - face_server.py runs under waitress when available. Flask's built-in
    server closes the connection after every response, so the camera opened
    a new TCP connection for every frame; waitress keeps one open. Frames
    slower than 500 ms are reported.
    - start_face_server.bat installs waitress if missing and warns that
    clicking in the console window pauses the server on Windows.
    - ESP32-CAM: after a failed frame, drop the connection and back off
    (150 ms steps, max 1.5 s) instead of retrying on a broken socket; one
    readable log line per outage instead of one per frame; print a QR once
    per appearance.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
    [ESP32CAM_Vision_FAST.ino]
2026-09-25 Faster QR at the door: WeChat decoder fallback, faster camera polling
    - face_server.py: when cv2.QRCodeDetector finds nothing, try OpenCV
    contrib's WeChat decoder (already installed). On simulated ESP32-CAM
    frames it decodes a 140 px QR 90% of the time vs 15%, so the phone no
    longer has to be held close. Prints frames/s and ms/frame every 10 s.
    - Master: poll the camera every 100 ms instead of 250 ms.
    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
2026-09-25 Camera: smaller JPEGs and a [PERF] line; master shows CHECKING on QR
    The face server's stats showed ~1 frame/s arriving while each frame took
    ~100 ms to analyse: the camera's upload over weak WiFi is the limit.
    - ESP32-CAM: jpeg_quality 12 -> 18 (about half the bytes; QR decode rate
    unchanged on simulated door frames), and a [PERF] line every 10 s with
    frames/s, failures, capture ms, upload+reply ms, KB/frame and RSSI.
    - Master: draw 'CHECKING' as soon as a booking QR is seen, before the
    portal round trips.
    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
    [ESP32CAM_Vision_FAST.ino, SmartLab_Master_Portal.ino]
2026-09-25 ESP32-CAM: disable Nagle on the upload socket
    lwIP holds the final partial segment of each JPEG until the previous one
    is ACKed, and Windows delays ACKs by up to 200 ms, adding a stall to
    every frame.
    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
    [ESP32CAM_Vision_FAST.ino]
2026-09-25 Report camera-side timing in the face server's stats line
    The ESP32-CAM sends its previous frame's capture ms, upload+reply ms,
    failure count and RSSI as X-Cam-* headers; face_server.py prints them
    under each [stats] line, so one window shows both ends of the link.
    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
    [ESP32CAM_Vision_FAST.ino]
2026-09-25 Master: unlock the door before reporting the step-2 match
    FACE_ACCEPTED / FINGERPRINT_ACCEPTED were sent to the portal (a blocking
    HTTP call, up to 2.5 s) before the relay was switched, so every entry
    waited on a round trip. The door now unlocks and the screen shows HELLO
    first; both audit events follow in the same order as before.
    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
2026-09-25 TEST: camera at CIF (400x296) instead of VGA for faster uploads
    Single camera change: FRAME_SIZE = FRAMESIZE_CIF (was FRAMESIZE_VGA).
    face_server.py searches frames narrower than 600 px for faces at full
    size instead of half, so a face at door distance stays above minSize;
    VGA frames are processed exactly as before.
    Revert with: git revert <this commit>
    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
    [ESP32CAM_Vision_FAST.ino]
2026-09-25 Revert "TEST: camera at CIF (400x296) instead of VGA for faster uploads"
    This reverts commit e99b830fc67b39f07187e32f7d3466a6e9b2a5ef.
    [ESP32CAM_Vision_FAST.ino]
2026-09-25 face_server: skip the WeChat QR decoder on frames with a face
    Measured on the door: WeChat added ~120 ms to every face frame, where a
    QR is almost never present. It now runs only when the fast decoder found
    nothing and no face was detected; a QR held close is still caught by the
    fast decoder on every frame.
    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
2026-09-25 Master: drop the QR_SCAN report and the duplicate QR denial report
    - QR_SCAN was an anonymous 'QR presented' event sent before validation;
    validate-qr already records every attempt with person, booking, lab,
    device, result and reason. One round trip less per scan.
    - A refused booking QR was reported as ACCESS_DENIED twice (explicitly and
    again in goAccessDenied), costing a second round trip and raising two
    identical security alerts. goAccessDenied's report now carries method QR.
    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
2026-09-25 Camera: two frames in flight to the laptop
    The camera-to-laptop link is latency-bound (halving JPEG size only cut the
    round trip from ~620 to ~450 ms), and frames were sent strictly one at a
    time. ESP32-CAM now runs ANALYZE_WORKERS (2) FreeRTOS tasks, each with its
    own connection, so the next frame travels while the previous one is being
    analysed. Shared results/stats are guarded by a mutex; fb_count follows
    the worker count. ANALYZE_WORKERS = 1 restores the old behaviour.
    face_server.py serialises the OpenCV work (detectors and the LBPH model
    are shared, not thread-safe) behind a lock; JPEG decoding and the network
    transfer still overlap. Load test: two concurrent clients, 346 frames,
    no e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
2026-09-25 Master LCD: no white flash after a denial; optional user photo on grant
    - A denial ended with tftInit(), which pulses the ST7735 reset line and
    shows white for a moment - the flash seen on a face mismatch. The
    re-init was only ever needed after the buzzer surge; it now runs only
    if the alert actually fired (it is disabled).
    - ACCESS GRANTED / DOOR UNLOCKED can show the user's photo full screen
    with the text over darkened bands. firmware/tools/make_lcd_photo.py
    builds user_photos.h (RGB565, face-centred 160x128 crop) plus a preview;
    both are gitignored. Without the file the text screens are used.
    tftBase() restores the normal layout after the photo without resetting
    the contro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
    [SmartLab_Master_Portal.ino]
2026-09-25 Fix white grant screen; back to one frame in flight
    - Master: the grant screen was drawn straight into the supply dip of the
    relay coil switching on, which resets the ST7735 and left it white. Now:
    relay, 80 ms settle, re-init the display, then draw.
    - ESP32-CAM: ANALYZE_WORKERS back to 1. Measured with 2: frames/s barely
    changed (1.3-2.6 vs 1.2-2.2) but each round trip grew from ~0.6 s to
    ~1.5 s - the WiFi link was already saturated, so frames only queued.
    - face_server: the per-window failed-upload count went negative when the
    camera rebooted mid-window.
    Both sketches compiled with esp32 core 3.1.3.
    Claude-Session: https:/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
    [ESP32CAM_Vision_FAST.ino, SmartLab_Master_Portal.ino]
2026-09-25 Master LCD: hardware SPI and a light wake instead of full resets
    - The ST7735 moves from bit-banged SPI to the ESP32's HSPI controller on
    the same pins (still separate from the RFID's VSPI), at 20 MHz. The
    full-screen photo is streamed row by row instead of painted pixel by
    pixel.
    - After the relay switches (grant and relock), the display is recovered
    with SLPOUT/COLMOD/MADCTL/DISPON (~125 ms, no reset pulse) instead of
    initR, which took ~1.2 s and showed white throughout. The full init
    still runs at boot and after a buzzer surge.
    - Logs how long after unlock the grant screen appears.
    Compiled for esp32:esp32:esp32 (core 3.1.3) with and without a photo.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
    [SmartLab_Master_Portal.ino]
2026-09-25 Master: redesigned LCD screens, door alarms, component health
    LCD (display only - the access logic is unchanged):
    - Every screen is composed in a 160x128 RAM canvas and sent in one
    transfer, so the panel never shows a half-drawn screen.
    - Flow: WELCOME / scan QR or RFID -> green 'QR CODE OK' / 'RFID OK' with
    the name -> VERIFY (look at camera or place finger) with a countdown
    bar -> green ACCESS GRANTED (photo if present) or red ACCESS DENIED
    with the reason in plain words. Bold FreeSans fonts, headlines sized
    to fit 160 px. The idle screen says when RFID or camera is offline.
    - Denial reason is copied (it pointed at a temporary String).
    Door alarms (reed switch):
    - Door opened wh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
    [SmartLab_Master_Portal.ino]
2026-09-26 Portal: alerts for door alarms and failed door components
    - Heartbeat components {rfid, fingerprint, camera}: a false value raises
    one WARNING alert + staff notification per component (no duplicates on
    repeated heartbeats, also on the first heartbeat after boot) and the
    alert resolves when the component reports true again.
    - ALARM events from the master: FORCED_ENTRY -> CRITICAL alert that stays
    open for staff; DOOR_HELD_OPEN -> WARNING alert resolved by the next
    DOOR_CLOSED. Both notify staff.
    - Devices page: Camera health tile; lab page falls back to the
    controller's camera report (the camera sends no heartbeat itself).
    - tests/test_door_health.py: 6 tests. Full suite: 163 pass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
2026-09-26 Face server: one-time firewall setup script and a missing-rule warning
    allow_firewall.bat self-elevates, finds the Python the face server runs on
    (same choice as start_face_server.bat) and adds a permanent inbound allow
    rule for that program on every profile, plus TCP 80/5000/8000. On this
    laptop a port-only rule was ignored while a program rule worked.
    start_face_server.bat now warns at start-up when the rule is missing,
    instead of the camera failing silently with HTTP -1.
    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
2026-09-26 TEST: ESP32-CAM greyscale frames (GRAYSCALE = true)
    The face server works on greyscale anyway; grey JPEGs should be smaller
    over the weak WiFi link. Revert: GRAYSCALE = false.
    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
    [ESP32CAM_Vision_FAST.ino]
2026-09-26 Revert "TEST: ESP32-CAM greyscale frames (GRAYSCALE = true)"
    This reverts commit 50865373e32bcaedc4a045b48247b01808810e8f.
    [ESP32CAM_Vision_FAST.ino]
2026-09-26 Automation outbox, n8n automation API and operations analytics
    - integration_events outbox staged in the same transaction as the change;
    optional dispatcher pushes selected types to n8n webhooks with retries
    - /api/automation/* (X-Automation-Key): event feed, booking readiness and
    reminders, denial bursts, device escalation, maintenance digest, daily and
    weekly reports, sensor thresholds, post-session, data quality, anomalies,
    idempotent notify/alerts, run records
    - /api/access/telemetry for a future sensor node
    - /api/analytics/operations, /labs/{id}, /me aggregates
    - dedupe keys on notifications and alerts (migration d7a4c2e9f1b3)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
2026-09-26 Operations Center, lab usage twin, student lab time, QR states
    - /admin/operations: utilisation, weekday x hour heatmaps, access funnel,
    refusal reasons, sessions (duration only with an observed exit), device
    outage strips, maintenance flow and time-to-resolve vs SLA, environment,
    n8n automation status; live refresh on door events
    - lab page: usage pattern (3-week strip + typical week), sensor panel with
    thresholds or 'Awaiting sensor data'
    - student dashboard: own 90-day lab time and attendance
    - QR page: VALID / EXPIRING SOON / NOT ACTIVE YET / EXPIRED / CANCELLED /
    REJECTED / ACCESS GRANTED (live via WebSocket)
    - component faults are device.component_fault, not door alarms
    Co-A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
2026-09-26 launch.bat: start n8n too when automation is configured in .env
    n8n lives in the compose 'automation' profile, so the one-click launcher
    never started it and http://localhost:5678 was refused. It now adds the
    profile when .env sets AUTOMATION_WEBHOOK_BASE, and prints the n8n address
    (or that automation is off).
    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
2026-09-26 n8n workflows: use Header Auth for the automation key
    The Simplified Custom Auth credential form in current n8n does not let the
    key be saved reliably; both credentials are now plain Header Auth
    (X-Automation-Key / X-Smartlab-Token), set up in one simple form each.
    JSON exports rebuilt; credentials still referenced by name only.
    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
2026-09-26 Self-service student sign-up on the login page; per-role Add buttons for admins
    Sign-up creates only a STUDENT with no auth subject (no door access until
    enrolled), is rate-limited per IP, can be restricted to email domains or
    require admin approval, and notifies administrators.
    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
2026-09-26 Free local AI via Ollama, plus a student helper
    AI_PROVIDER=auto uses Claude when ANTHROPIC_API_KEY is set, otherwise a
    local Ollama model reached at OLLAMA_URL (compose default:
    host.docker.internal:11434). Staff assistant keeps its read-only tool loop
    (qwen2.5:3b by default); the new student helper answers from the caller's
    own bookings and reports plus the lab list (time slots only, never who
    booked), with no tools (qwen2.5:1.5b / claude-haiku-4-5). Status endpoints
    report whether Ollama is running and which models are missing, and the
    staff panel shows the exact setup step.
    Claude-Session: https://claude.ai/code/session_01JeVQYHhcq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
2026-09-26 Automatic door identities, serial fingerprint enrolment, chat bubble, n8n self-test
    - New accounts (admin-created or signed up) get the next USERn; numbers are
    never reused (assignments are kept in the audit log). Users page shows it
    and can assign one to existing accounts.
    - Master firmware: a booking QR for any USERn uses fingerprint slot n / face
    label USERn, so new people need no firmware edit. Serial commands
    enroll/delete/count manage fingerprint slots while the door is idle.
    - Face server: enrol names limited to letters/digits (they become folders).
    - AI chat bubble on every page (staff assistant or student helper).
    - test_automation.bat checks the key, n8n, the four event wor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
2026-09-26 Local AI: 8k context by default, retry at 4k if Ollama's engine crashes
    A GTX 1650 (4 GB) crashed llama-server (0xc0000409) with a 16k context.
    The portal now asks for 8k, retries once at 4k, and otherwise explains
    the driver/CPU fallback. Tool results sent to the local model are capped
    lower to fit.
    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
2026-09-26 Local AI: fall back to the processor when the GPU cannot run Ollama
    Ollama on a GTX 1650 with an older driver fails with 'CUDA error: device
    kernel image is invalid'. After the smaller-context retry, the portal now
    asks Ollama to run on the processor only (num_gpu 0). OLLAMA_CPU_ONLY=true
    skips the GPU attempts entirely.
    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
2026-09-26 AI on the processor: 10-minute proxy timeout, remember GPU failure
    nginx cut AI requests at its default 60 s ('Gateway timeout') while the
    local model answered on the processor. /api/ai/ now allows 600 s, and once
    the GPU has failed and the processor worked, later questions skip the GPU.
    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
2026-09-26 AI chat: sidebar button, and faster local answers
    - 'Ask the lab' / 'Ask Smart Lab' entry in the sidebar opens the same chat
    panel as the round button (which stays).
    - Both chats share one Ollama model by default (OLLAMA_STUDENT_MODEL empty):
    on a 4 GB GPU two models do not fit, so every switch reloaded one.
    - Same context size for every request (a change forces a reload), model
    kept loaded for 2 h, and loaded at portal start-up.
    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
2026-09-26 Lab access setup reminder, AI knowledge guide, separate student model
    Information only - the door, the face server and the access checks are
    unchanged:
    - users.fingerprint_enrolled_at / face_enrolled_at (migration e2b9f4a6c813),
    set by staff with two checkboxes on Users & roles. USER1/USER2 are seeded
    as enrolled.
    - A person with a door identity whose fingerprint or Face ID is not
    confirmed gets an 'Action needed' notification (at sign-up, or once at
    their next sign-in), a banner after each sign-in, and a checklist on the
    Profile page.
    - Both assistants get a short guide to how Smart Lab works (no addresses or
    keys); the student helper also sees their own recent door refusals in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
2026-09-26 Docs: full system walkthrough and fresh screenshots
    - docs/SYSTEM_OVERVIEW.md (new): every layer - Master ESP32, ESP32-CAM,
    face server, laptop/Docker/launch.bat/Ollama, backend, database, portal
    dashboards, n8n workflows, AI assistants - with diagrams, the journeys
    (sign-up to entry, refusal to alert, issue, chat), security boundaries
    and ports.
    - README: intro points to the overview; features, architecture diagram and
    services table include n8n, Ollama and accounts; 20 screenshots taken
    from a fresh demo instance (plus the owner's real chat screenshots);
    identity bridge, test count, limitations and layout brought up to date.
    - ARCHITECTURE.md: identities/setup reminder, AI, d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
2026-09-30 Master: PN532 RFID over I2C, and read-only tablet display
    - Replace the MFRC522 (SPI) with an HW-147 PN532 over I2C (SDA 19, SCL 18),
    Adafruit PN532 library. Same user database, de-dup, timings and 2-step
    flow; the self-test now checks getFirmwareVersion().
    - Retry PN532 init at boot and run SAMConfig when the link recovers, so a
    reader that wakes late still reads cards.
    - Add a read-only tablet page (GET / and /state on port 80) mirroring the
    TFT. It has no route that can touch the relay.
    [SmartLab_Master_Portal.ino, tablet_display.h]
2026-10-02 Offline lab router, live door state, automatic grant-screen photos
    - Network: the lab runs on its own offline router (Smart_Lab). The
    ESP32-CAM (192.168.1.150) and master (192.168.1.151) set fixed IPs in
    firmware; the laptop is 192.168.1.200. launch.bat skips the Docker
    build when there is no internet and starts the last built images; n8n
    telemetry is off.
    - Door: the master relocks and redraws before reporting to the portal,
    and a door or lock change sends a heartbeat at once. The backend pushes
    a door_state message so open pages refresh immediately. The serial log
    prints door position and lock state together.
    - Photos: face enrollment keeps the best colour capture per person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
2026-10-02 Portal: enroll a face from Users & roles, with live camera view
    Edit user -> Face ID shows the door camera live, captures samples one at a
    time or automatically, and "Finish & train" retrains the face server and
    marks Face ID as registered (audit record + notification to the person).
    Staff and admins only. The portal relays to the camera and the face
    server and stores no biometric. Links to the camera's own page too.
    The face server's /users now also lists who has a grant-screen photo.
2026-10-02 Fingerprint enrollment from the portal via device commands
    Users & roles -> Edit -> Fingerprint: staff request an enrollment and
    watch it live. The portal only records a request (new device_commands
    table); the master fetches it in a background task, only while the door
    is idle, guides the person on the LCD and tablet (place, remove, same
    finger again), stores it in slot n of the sensor and reports each step.
    Success marks the fingerprint as registered (audit + notification).
    The master stays the final authority: it polls (nothing pushes into it),
    refuses while busy, never touches the relay for this, and keeps watching
    the door - a forced door stops enrollment and raises the normal alarm.
    O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
2026-10-02 Face recognition: offline comparison of LBPH and SFace
    firmware/tools/eval_face_models.py measures, leave-one-out on the enrolled
    samples, the recognizer the door uses now (LBPH, distance <= 70) against
    OpenCV's YuNet + SFace embeddings (cosine >= 0.363): accuracy, false
    accepts, false rejects, genuine/impostor scores and CPU time. Per-sample
    rows go to a gitignored CSV next to the dataset.
    The ONNX models are not committed (39 MB); models/README.md has the
    download links and SHA-256 sums.
2026-10-02 Docs: Robotics Lab architecture audit and design (design only)
    Inspection of what exists and what each new subsystem reuses, database
    changes (additive), power, network and IP plan, System 1 sensor/pin and
    message design, inventory, lid, robots, PCs, website, API, n8n, analytics,
    AI, security, privacy, testing plan, order, failure modes, and the open
    hardware questions. Nothing here is a measured result.
2026-10-02 System 1 (environment node): backend, website and firmware, pre-hardware
    Backend: telemetry hazard states (smoke, flame, water_leak, emergency)
    raise one CRITICAL alert at once, notify staff and clear themselves;
    GET /api/labs/{id}/environment gives the latest value per metric with an
    honest quality (VALID / STALE / MISSING / DEVICE_OFFLINE / OUT_OF_RANGE).
    The monitor tiles include hazards, motion and the node's online state.
    Website: lab page shows the safety states (never "normal" when the data
    is missing, stale or the node is offline); 0/1 states stay out of the
    trend charts.
    Firmware: SmartLab_Environment_Node (ESP32 #1, fixed IP .152): DHT22,
    MQ-2 DO with warm-up, flame, leak, PIR, o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
2026-10-02 Face server: SFace (YuNet + embeddings) by default, LBPH as fallback
    Uses OpenCV's YuNet detector and SFace recognizer when their model files
    are present. A person's template is the mean embedding of their samples
    and is rebuilt the moment a sample is enrolled - no training step.
    Existing grey samples are used as they are; new enrollments also keep an
    aligned colour face (dataset_sface/, gitignored). Replies to the camera
    are unchanged (distance = 100 x (1 - cosine)); /health reports the engine.
    LBPH keeps being trained alongside, so FACE_ENGINE=lbph switches back
    without re-enrolling. Measured offline on the enrolled samples: SFace
    96.2 % vs LBPH 86.8 % identified, neither accepted a wrong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
2026-10-02 Face ID photos sent by the person, approved by staff
    Profile: a person whose Face ID is not registered can send 5-10 photos
    (phone camera or files). Nothing is enrolled until staff, in Users &
    roles -> Edit -> Face ID, confirm the photos show the account holder -
    otherwise anyone could register someone else's face under their own door
    identity. Approve sends each photo to the face server as a sample and
    registers Face ID if at least 3 had a usable face; reject tells the
    person why. The portal deletes its copies after either decision (only
    the record stays); images are re-encoded on upload (EXIF/GPS removed)
    and served only to the person and staff. Audited; staff notified.
    New table face_sub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
2026-10-02 System health: report internet separately from device health
    Offline-first (milestone section 5): the status endpoint checks the
    uplink at most once a minute (TCP to a public DNS resolver, 1 s timeout)
    and reports it as its own field. 'Internet offline' is shown as
    'Offline (lab unaffected)' and never makes the system unhealthy - unlike
    a device offline, which is reported per device.
2026-10-02 System 1: environment in lab readiness and a read-only AI tool
    Lab readiness now includes the environment node: an active smoke/flame/
    leak/emergency state or an offline node is a warning (existing top
    level, so n8n 09 and the pages need no change); temperature/humidity
    outside thresholds is a note. New AI tool get_environment: min/mean/max
    and counts, every hazard episode with duration, and current values with
    their quality - stored data only.
2026-10-02 Per-device keys: each device can have its own key, scoped to itself
    Milestone section 39 (unique device authentication). Admins issue a key
    per device on the Devices page (shown once; only its SHA-256 is stored;
    audited). A device using its own key may report heartbeat, telemetry and
    command progress only as itself (403 otherwise). The shared key keeps
    working, so the door boards need no change; DEVICE_SHARED_KEY=false
    switches it off once every device has its own. New column
    devices.key_hash (additive migration, alembic check clean).
2026-10-02 System 2 (consumable bins): backend, inventory page and bin firmware
    Backend: inventory_bins / inventory_measurements / inventory_transactions
    (additive migration). Bin nodes post STABLE masses; a step above the
    bin's threshold (3 x measured noise, 1 g until measured) becomes a
    WITHDRAWAL or REFILL, linked to a person only when exactly one is inside
    (a correlation). Quantity n = round((m - m0)/u) +/- noise/u appears only
    after m0, u and noise are entered as measured values. Low-stock alert,
    physical counts recording the estimation error, bins bound to their node.
    Website: Inventory page (staff) with calibration, counts and history.
    Firmware: SmartLab_Consumable_Bin (ESP32 #2, .153): HX711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
2026-10-02 System 3 (reusable smart bin): NFC items, checkout/return, bin firmware
    Backend: assets.nfc_uid and smart-bin context on asset transactions
    (booking, device, source; existing rows = STAFF; hand-written migration,
    upgrade/downgrade/check tested). Return: a checked-out item's tag scanned
    at the bin -> OPEN_FOR_RETURN -> recorded only once the node reports the
    lid opened. Checkout: chosen in the portal by someone inside the lab ->
    OPEN_LID device command -> completed only by the chosen item's own tag;
    any other tag = WRONG_ITEM, nothing changes. Unknown tags are kept for
    assignment; one tag per item; holder names only for staff (or "you").
    Website: Smart bin card on the lab page (take an item)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
2026-10-02 System 2 (robots + PCs) base; smart bin lists only bin items
    Robots and PCs are devices linked to their asset (devices.asset_id, new
    types ROBOT / PC), so liveness and offline alerts cover them. A collector
    or agent reports state (POST /api/equipment/state); a state change closes
    the open equipment session and opens the next, linked to the booking in
    force; FAULT raises an alert; numbers go to sensor_readings. PC mode
    (NORMAL / EXAM / MAINTENANCE) set by staff and audited; in EXAM the agent
    gets the configured prohibited-program list and violations are logged
    for staff (nothing automatic). No robot command exists.
    tools/ur5e_collector: read-only RTDE collector (fields to confirm per
    control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
2026-10-02 Users & roles: Enroll button opens a door-enrollment drawer
    Each person with a door identity gets an Enroll button in their row
    (highlighted while fingerprint or face is still pending) opening a
    drawer with fingerprint and Face ID enrollment at the top, instead of
    the panels being at the bottom of Edit user.
2026-10-02 Equipment page: the lab's four systems as tabs
    1 Physical environment (environment nodes: temperature, humidity, safety
    states with quality), 2 Robots & PCs, 3 Consumables (weighing bins),
    4 Reusables (smart bin items), plus the full equipment register. Tabs are
    linkable (?tab=); /inventory redirects to the consumables tab.
2026-10-02 Tablet live camera view with positioning hints, at no camera cost
    The face server keeps the last /analyze frame and the face box it already
    found; the tablet polls /preview.jpg and /preview/state from the laptop.
    The camera does nothing extra. Hints come from the YuNet box and landmarks.
2026-10-02 Admin master PC controls; renumber systems to the owner's 1-4
    System 2 (robots & PCs): from the portal staff remove/give access (mode
    LOCKED, the agent re-locks within 2 s), view a PC's screen only while the
    viewer is open (notice on the PC, frames in memory only), and send a
    message; per PC or all PCs. Every action audited. Agent polls every 2 s.
    Systems renumbered: 1 environment, 2 robots/PCs, 3 consumables,
    4 reusables. Architecture doc: robots wired directly to the router,
    switch only if ports run out; PCs wired or Wi-Fi to decide.
2026-10-03 RFID card enrollment from the portal, staff photo upload, editable email, faster tablet view
    - Master: cards enrolled from Users & roles are stored in its flash (NVS)
    for USERn and work offline; tap-your-card step on LCD and tablet;
    remove; serial 'cards' / 'card delete n'. Portal records the reported
    UID as the person's one active card.
    - Face ID: staff can upload photos; they go straight to the face server.
    - Users: email is editable (unique, lowercased); the name never changes it.
    - Tablet live view only after step 1, now an MJPEG push stream at the
    camera's own rate (~2 ms to the viewer); /analyze timing unchanged.
2026-10-03 Ask the lab: much bigger chat panel, with a full-screen option
    Pops out of the bubble as a tall ~760 px panel; the maximize button makes
    it fill the window (remembered). The conversation fills the panel instead
    of a 420 px box. Rendered at <body> so it sits above the sidebar.
2026-10-03 Security camera: people, names from the door, watched equipment, live on every monitor tile
    tools/security_vision (laptop): YOLOX-S person detection on the CPU via
    OpenCV, a tracker, names only when the door makes them certain (door area
    right after an entry, or the last unnamed person), boxes around fixed PCs
    and robots learnt when clear and flagged when moved / moving with nobody
    there, people seen vs entered. Events with a snapshot, once per incident.
    Face server latency 36.5 ms with it running vs 35.3 ms without.
    Portal: security_zones / security_events (migration c665cd35a15b),
    /api/security (config, state, events, zones, frames proxied with the
    device key), Security camera page (live,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
2026-10-03 Emergency tab, master PC, camera name lock, bin weight check, instant AI agent and PDF reports
    Emergency (admin, behind the emergency password): hold a lab door open or
    lock it down, a message on the door LCD and tablet, the evacuation alarm,
    lock / unlock / message all lab PCs; every action audited and sent to
    staff, shown on the Live monitor. Door firmware applies it every second
    (and now compiles: the event queue types were declared after use).
    Master PC: an administrator marks the lab engineer's PC; lab staff control
    the other lab PCs, only admins control the master PC. Eng. Hemaly added as
    lab staff (seed, USER5). door.alarm is no longer pushed to n8n (no workflow
    listened; the portal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
2026-10-03 Emergency through n8n, fast AI answers, webcam name-lock demo
    n8n workflow 23 (live, tested end to end): an emergency set by an admin
    warns everyone inside that lab (leave / lockdown / the admin's message);
    after 30 s, if the door controller has not confirmed the new state, the
    admins are told to act at the door. Backend emits emergency.set and serves
    GET /automation/emergency/{lab_id} (state, applied, one notice per person).
    AI: the local model first answers in one call from the agent's snapshot
    (now with both weeks as exact numbers), and falls back to the tool loop
    only when it says NEED_TOOLS. Measured on this laptop: 1.6-2.1 s instead
    of 5-24 s after the first question.
    Security camera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
2026-10-03 Bring-up prep: bench lab, per-device keys, staged sensors, measurement logging
    Before the physical bring-up (no hardware validated by this commit):
    - Environment node env-0.2: reports as lab BENCH, DHT22 only enabled (other
    inputs float until wired and would raise false hazards), CSV lines for
    every reading, state change, HTTP round trip and Wi-Fi change.
    - Consumable bin bin-0.2: BENCH, "stream" (every raw HX711 sample, portal
    reporting paused) and "avg <n>" (mean / sd) for calibration experiments,
    CSV lines for readings, sends, HTTP and Wi-Fi.
    - Reusable bin reuse-0.3: BENCH, CSV lines for every NFC read (accepted /
    duplicate), lid open/close times, HTTP and Wi-Fi.
    - tools/bringu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
2026-10-05 Door: lock on NO, buzzer back, tablet speaks prompts and alarms
    - Lock moved to the relay's NO contact, relay IN driven from 3V3 via a
    BC557 (GPIO26 HIGH = locked): reset, flash and 12 V dips leave it locked
    - Buzzer + red LED back for denial (0.6 s), forced entry and evacuation
    - Tablet page speaks door prompts with the viewing device's own voice
    after one tap; alarms play on the tablet (words, then siren) and at door
    - Door speaker engine (PAM8403 on GPIO22, voice clips from make_voice.py)
    - Camera polling moved to a background task: door close acted on at once
    - Bench results recorded in docs/BRINGUP_LOG.md
2026-10-05 Environment node 0.1.0: all five sensor groups pass on the bench
    - Rewrite of the env-0.2 draft (same device id, key, lab, endpoints, CSV lines)
    - DHT22, two PIR zones, 5-channel flame board (CH1 digital, CH2-5 analog
    as measured), MQ-2 analog via 10k/15k divider with warm-up and baseline
    - One event per state change, safety events first; per-sensor health
    - Network on its own task: sensing never waits on Wi-Fi or the portal
    - Serial test commands, honest self-test, sensors enabled at run time
    - LOCAL TEST MODE: nothing sent to the portal yet (bring-up phase 9)
    - Bench results and wiring in docs/BRINGUP_LOG.md and the node README
2026-10-05 Environment hazards go live: full-screen alarm, live status, node reporting
    - Smoke/flame alert open/close is pushed over the existing WebSocket as a
    `hazard` message to every signed-in user (safety information)
    - GET /labs/hazards/active: open alarms for pages loaded later
    - Portal-wide red full-screen alarm with siren, Emergency mode button
    (admins), acknowledge -> red bar until the sensor clears, all-clear toast;
    re-checks every 10 s so it can never get stuck
    - Live Monitor: SMOKE/FLAME chips green ok / red; Safety states refresh live
    - Env node reports to the portal (LOCAL_TEST_MODE off), lab LAB_01
    - Tests: hazard push + routing + endpoint; two stale no-AI tests now turn
    the loc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
2026-10-05 Hazards that repeat, live readings, cleaner pop-up and alerts
    - Second hazard in a lab no longer fails: a cleared alert frees its unique
    dedupe key (was HTTP 500 for every telemetry post afterwards)
    - Hazard and new-reading messages are published only after the commit;
    env_update makes lab, equipment and monitor pages refresh at once
    - Device offline alert: one per outage, resolved when the device is back
    - Pop-up: two choices only - EMERGENCY MODE (admins) and CLEAR
    - Env node: readings every 10 s, changes at once, 5 s back-off after a
    failed send instead of retrying every loop
    - Tests: repeated hazard, offline alert once + auto-resolve (342 pass)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
2026-10-05 Staff advisories: temperature/humidity limits and motion in a closed lab
    - Temperature > 30 C / humidity > 70 % (back below 28 C / 65 %): WARNING
    alert, staff notification and an orange pop-up with advice (ventilation,
    AC). The portal advises only - it switches nothing.
    - Motion while the lab is closed (no booking, nobody checked in): one
    WARNING security alert per episode, resolved by staff once checked.
    - env_warning live messages go to staff only; limits are settings.
    - BENCH test lab removed (database); the env node reports as LAB_01.
    - Tests: advisory hysteresis + repeat, motion only when closed (344 pass)
2026-10-05 Motion is a quiet blue note, CLEAR / CLEAR ALL, Enter works with autofill
    - Motion: no alert and no "closed lab" rule - one silent blue note to staff
    when motion starts (repeats every 10 s while it lasts are ignored)
    - Every advisory card has CLEAR; CLEAR ALL resets all pop-ups and the red
    bar on this screen; the red bar has its own CLEAR (new alarms still show)
    - Login and emergency password: submit reads the fields directly, so Enter
    works when Chrome autofilled them (buttons no longer disabled on state)
2026-10-06 Camera in the portal, data recovery, assistant charts, faster portal
    - Security camera: all-labs wall, Details window on the monitor, detection
    boxes on/off, full screen, boxes predicted between detections, names by
    door and face (on hold until the door, verified, card-sharing alert),
    "Find PCs automatically", editable boxes; service listens on 127.0.0.1;
    launcher reads camera.env.
    - Face server: key-protected /identify for the camera (nothing logged).
    - Portal speed: camera state pushed only on change, as its own message.
    - Devices page knows the security camera; lab page opens in the same tab;
    chat PDF link opens signed in.
    - Assistant: exact answers for any date range, door hist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
2026-10-06 Data provenance on every record, data mode, thesis experiments
    - provenance + experiment_id on access_events, sensor_readings, alerts,
    bookings, access_sessions, issues, security_events (migration
    a9d4e7c2b310, additive). Existing rows UNKNOWN_PROVENANCE except what is
    proven: 183 recovered events (event_metadata.recovered) ->
    RECOVERED_HISTORY; the two n8n workflow test tickets -> SOFTWARE_TEST;
    the rule and counts written to the audit log. Nothing deleted.
    - New rows are stamped with the running experiment's mode and id, else the
    system data mode (admin, Settings/Experiments page; default
    UNKNOWN_PROVENANCE); provenance is immutable once written.
    - experiments / experiment_tr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
2026-10-06 Analytics test: heatmap hours compared within float precision
    The booking starts 3 h before now, so its 2 h fall into hour cells as
    fractions whose float sum is not bit-exact 2.0 at 2 of 60 start minutes -
    the cause of the intermittent failure. Full suite: 377 passed.
2026-10-06 Evacuation alarm on every screen, CLEAR ALL, actionable improvement plan, no Bad Gateway on restart
    - Emergency tab: switching the evacuation alarm on now raises the portal-wide
    full-screen alarm with siren on every signed-in page (any role), live and on
    pages opened later; off / back to normal clears it. Before, only the door
    buzzer sounded, and the door controller is unpowered.
    - The alarm screen's button is CLEAR ALL: siren off, overlay, red bar and
    pop-ups gone on this screen; a new alarm sounds again.
    - Assistant "what should we fix / do better": each repeated problem with its
    evidence (count, dates, still happening or not, open), likely cause,
    numbered steps and a "done whe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
2026-10-06 Emergency message read aloud everywhere, Clear sound / Clear all, Notifications tab, no false smoke
    Emergency tab
    - The admin's message goes to every user (notification) and appears on every
    signed-in screen (any role, phones too), read aloud every 20 s until that
    person presses Stop voice / CLEAR ALL, or the admin clears it.
    - Separate buttons: Alarm on/off, Read aloud / Voice off, Clear message,
    Clear sound (alarm + voices off, message stays), Clear all (back to normal).
    - lab_emergencies.speak (migration c4e8a2f7b915, additive); the door reads it.
    - Door tablet (firmware, not flashed yet): reads the message aloud, repeated,
    never over a door prompt, with a Stop message button.
    No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
2026-10-06 Reusable bin: modular firmware with per-component hardware tests
    New firmware/SmartLab_Reusable_Bin_Modular (the single-file reuse-0.3 stays
    unchanged). One module per part: LoadCell (HX711, raw/g/kg, stability and
    change detection, serial calibration saved in flash - no factor assumed),
    Display (I2C scan, change-only writes), NFC (PN532 firmware check, UID,
    duplicate suppression), Servo (no move at boot, detach at rest, max hold,
    lockout after a lid fault, angles measured and saved), LidSensor (reed),
    RFID (reader-agnostic interface, disabled until the old reader is
    identified), Inventory (set difference), Verification (lid + weight + RFID
    cross-check, on-device selftest of the spec's examp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
2026-10-06 Security camera recording for admins (local, FFmpeg); bin firmware: no hang without HX711, hxprobe
    Recording
    - tools/security_vision/recorder.py: FFmpeg records the camera's full stream
    (H.264 copied, no re-encoding; G.711 audio -> AAC) to fragmented MP4 in
    tools/security_vision/recordings/ (gitignored) with a JSON sidecar (who,
    when, length, why it stopped). Refuses below 2 GB free, stops by itself
    after 60 min or when the stream ends, never deletes. FFmpeg found via
    FFMPEG / PATH / the winget folder.
    - Camera service endpoints /record/status, /record/start|stop, /recordings,
    /recordings/<file> (Range), device key.
    - Portal (admins only): status, start/stop (audit log SECURITY_R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
2026-10-06 Recording runs until Stop in 1-hour parts; HX711 slow clock on the ESP32, hxreset/rawlog
    - FFmpeg segment muxer: one recording runs until Stop, split into 1-hour MP4
    files named by their start time, cut at key frames (no gap). The 60-minute
    stop is gone; it also stops if the stream ends or free disk drops below
    2 GB (checked every 30 s). Each part's sidecar: part n of N, recording start,
    who started / stopped, length measured by ffprobe (clock time understated it:
    listed 4 s for a 6.7 s file).
    - Real camera: 35 s split every 15 s -> 3 contiguous parts (15.8 + 16.1 + 3.2 s
    by ffprobe). e2e/recording.mjs 6/6 again. Portal: REC h:mm:ss + part count,
    "part n of N" in the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
2026-10-06 Reusable bin: no false 'HX711 stopped answering' after tare / cal / rawlog
    Calibrated on the bin (2026-10-07): 200.0 g reference (kitchen scale) ->
    factor -518.04 counts/g (negative: signal pair green/white reversed);
    reads 199.5-199.8 g, spread 0.1-0.4 g.
2026-10-06 Reusable bin: HX711 recovers by itself from a stuck state (3 nonsense codes -> power-cycle)
    Seen after the load cell was re-mounted: -1 / 0 / 0x800000 at random times,
    DT undriven; a PD_SCK power-cycle brought back steady 89 ms readings.
2026-10-07 Find equipment: full 640 model over overlapping tiles, weak hits and containers dropped
    Lab camera (2026-10-07): the live settings (416 px, 45%) suggested 1-3 of
    ~8 PCs (monitors seen side-on, far away). Tiled 3x2 + whole picture at 640,
    >=0.30, a box mostly containing another keeps the more confident one (drops
    the cabinet around a monitor, the stand under it, chair backs at 0.22).
    Now 6 suggestions in ~3 s; staff still tick which to keep. Model loaded
    only on first use.
2026-10-07 Camera boxes follow the view: re-aligned automatically when the camera pans or is bumped
    realign.py: the view when the boxes were drawn is the reference (people masked
    out); every 15 s the camera matches the room (ORB + RANSAC). Moved and
    confident twice in a row -> each box mapped to its new place through
    POST /security/zones/realign (boxes relearn, audit log, event
    CAMERA_VIEW_MOVED); boxes that left the picture are kept and named. Moved but
    not confident -> CAMERA_VIEW_LOST once, nothing changed (never guesses). Box
    alerts are held back while the whole view is moving.
    Lab frames (2026-10-07): 2,456 room features; same view 4 s later 2,202
    matches, shift 0.0%; simulated 4% pan matched wit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
2026-10-07 Robot training pictures: admin Start/Stop collecting on the security camera
    dataset.py: while collecting, a plain frame every 2 s, kept only when the
    picture changed (mean grey difference >= 4 of 255) - a varied set, not
    copies; stops by itself at 1000. Files in tools/security_vision/dataset/
    (gitignored). Portal: GET/POST /security/cameras/{id}/dataset (admins,
    audit log), card on the Recordings tab with the live count. First step of
    teaching the camera the UR5e / Fanuc; labelling and training next.
2026-10-07 Camera move handled in seconds, without false equipment alerts
    Lab, 15:54:57: the camera was turned; all 7 PC boxes raised 'movement with
    nobody at it' at once and the boxes followed only at 15:55:30 (15 s checks,
    two agreeing looks). Now most boxes changing in the same moment is treated
    as the camera moving: no equipment alerts, an immediate view check, and
    checks every 3 s while unsettled (boxes follow in ~6 s).
2026-10-07 Camera boxes: re-align from the staff-drawn anchor, only after the view settles
    Each automatic re-align used the previous automatic result as its
    reference, so a look taken mid-pan could push the boxes off and the next
    one built on that. Now every move maps from the boxes as staff last drew
    them (anchor kept on disk), needs a strong match, and two looks that
    agree within 1 %; if most boxes would leave the picture nothing moves.
2026-10-07 Camera clock set at every start (the MC210 forgets it on power loss)
2026-10-07 README: security camera pictures from the robotics lab (faces blurred)
2026-10-07 Camera: robots show 'moving' while they move and park without 'changed'; door open/closed from the red leaf
    - Movement = share of pixels changing (an arm in a big box), brightness
    evened out first (lights are not movement); 'moving' after two frames,
    kept until still 4 s, so a pausing arm does not flicker.
    - A robot box (motion alert off) that stops in a new pose learns it after
    5 s still; a PC that looks different stays CHANGED.
    - Door box: open when the red door leaf is seen (learnt share, hysteresis,
    a person in the doorway never counts as closed); shown on the picture and
    in the portal (door_open in the camera state).
2026-10-07 Camera: face names come back by look after the track is lost; robot moves logged; delete a recording (moved to deleted/)
    - A person named by face (not entered) kept their name only while the same
    track lasted; walking away dropped it for good. Their look is now kept
    15 min and they get the name back on a clear look match (still on hold).
    - Robot boxes: ROBOT_ACTIVITY (INFO) when moving or parked in a new pose;
    a smaller pose change (0.15) counts for robots.
    - Recordings: admin Delete moves the video + notes into recordings/deleted/
    (recoverable), refused for the part being written, audited.
2026-10-07 Camera: a face name is never given back to a small / half-hidden person
    At 18:27 Ali's face name jumped onto Eng. Hemaly, seen only as a 32x45 px
    head behind the monitors (colours of a tiny crop matched). A face name is
    now given back only to a person at least 80 px tall, within 0.22 of the
    locked look and clearly better than every other unnamed person; tiny
    views are never learnt into a look either.
2026-10-07 Camera: a seated person who drops out of detection gets their name back at the same place
    Behind the monitors Eng. Hemaly is a 33x48 px head that the detector keeps
    losing and finding as a new track - the name was lost each time. A named
    track's name now waits 20 s at its place: the one new unnamed track that
    appears there (similar size) gets it back; never when two fit, and a person
    big enough to judge must also match the look.
2026-10-08 Security hardening, identity evidence engine, camera latency instrumentation
    Security:
    - Password rules for new passwords (10+ chars, 3 of 4 kinds, no common /
    personal ones); Argon2id for new hashes, bcrypt upgraded at sign-in;
    constant work for unknown accounts.
    - Sign-in throttling (8 failures / account, 30 / address per 15 min ->
    429 + Retry-After); every failed sign-in audited (never the password).
    - Global error handler: generic 500 + error_id outside, full traceback
    inside with repeated-error suppression; X-Request-ID on every response.
    - API docs off by default (EXPOSE_API_DOCS); CORS methods/headers listed.
    - nginx: CSP, X-Frame-Options, nosniff, Referrer/Permissions policy,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
2026-10-08 Robots (read-only) + IoT Command Center + 3D twins
    - tools/robot_monitor: RobotMotion (per-joint start/stop hysteresis,
    JOINT_MOVED with delta/peak velocity, stale != stationary), collector
    with UR RTDE receive-only source, scripted SIMULATION source (posted as
    DEMO DATA), bounded retrying outbox; fanuc_probe.py (connect checks +
    controller web pages, read-only) - no FANUC protocol assumed.
    - Backend: /robots telemetry + events (context: booking, inside per door,
    camera evidence only when the camera is reporting; severity NOTICE /
    WARNING / CRITICAL), role-limited views, versioned HOME calibration
    (admin, from live still telemetry), HOME_LEFT/RETURNED; robot_state /
    robot_sta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
2026-10-08 Robot fusion: camera optical flow in robot boxes vs telemetry
    - robotvision.py: Farneback flow on each robot box (8x8 grid, >= 2 moving
    cells, brightness evened, coherent whole-box shift = camera shake,
    person over 35% = OCCLUDED never 'still', 2-frame persistence, 3 s
    linger); reported with the camera state every 0.5 s when robot boxes exist.
    - robot_fusion.py: MOVEMENT_VERIFIED / TELEMETRY_ONLY / VISUALLY_OCCLUDED /
    STATIONARY(_VERIFIED) / VISUAL_ANOMALY / VISUAL_MOVEMENT_DURING_TELEMETRY_
    OUTAGE / SIMULATION; abnormal states become events only after 3 s, once;
    evidence list per decision (kinematic check marked NOT CALIBRATED).
    Run on every telemetry report and every camera r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
2026-10-08 Portal speed: every page lazy-loaded, prefetched in the background after sign-in
    Main bundle 481 kB -> 175 kB (the first page preloads only react, motion and
    icons; charts 387 kB and three.js load when needed). All pages are fetched
    one by one when the browser is idle after sign-in, so later clicks stay
    instant. Measured (nav_timing.mjs, admin, 36 switches): median 80 ms.
2026-10-08 Command Center: live lab floor plan, clock, counters, robots in the top panel; robot page: live per-joint traces, twin fills its card, reach ring
    The floor plan is schematic and driven only by real state (robot telemetry,
    camera PC boxes, door controller / camera door view); people are counted,
    not placed, because there is no floor calibration.
2026-10-08 Robot twins from the manufacturers' real models: UR5e and FANUC LR Mate 200iD
    - UR5e: Universal Robots' own visual meshes + exact kinematics and mesh
    offsets (Universal_Robots_ROS2_Description: ur_macro.xacro,
    config/ur5e/*.yaml; BSD-3). FANUC: ROS-Industrial fanuc_lrmate200id_support
    meshes + chain (BSD) - the lab arm's model still to be confirmed.
    - MeshArm: URDF semantics (joint origin xyz/rpy, axis rotation, visual
    origin), Z-up COLLADA kept in its raw frame, per-arm materials so the
    selected / moving link is tinted and HOME is a translucent ghost;
    the cylinder arm shows while meshes load.
    - nginx serves /models gzip'd (upperarm 3.1 MB -> 1.1 MB) and cached a week.
    - Camera f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
2026-10-08 Robots: Robotiq 2F-85 on the UR5e twin, movement replay, tool trail, wall mode, staleness fixes
    - Robotiq 2F-85 gripper + UR adapter meshes (PickNik ros2_robotiq_gripper, BSD-3).
    - Movements recorded with their path (10/s) and replayable in 3D (play, scrub, speed).
    - Live tool-tip trail; last-known-pose display when telemetry stops;
    client-side stale/offline within 3 s; stopped simulations hidden.
    - /wall: Command Center full screen for a lab monitor.
    - Simulation sends velocities and stops after 30 min by default.
    - FANUC J2/J3 coupling conversion (to confirm on the controller).
2026-10-08 UR5e twin ceiling-mounted under a gantry plate, as in the lab
2026-10-08 Reusable bin: 1 kg load cell capacity, OVERLOAD warning on log and LCD
2026-10-09 Handoff 2026-10-09: booking equipment, smart bin in normal mode, personal door QR, device states
    - Booking step "Equipment": smart-bin items, consumables, workstations (several);
    reservations per overlapping booking (new table booking_items).
    - Smart bin: take-out confirmed by weight, return by NFC + weight, identical items
    as one kind, swap handling, notifications, unexplained weight-change alerts;
    staff and booked students may take; Smart-bin card on the active booking page.
    - Bin firmware: PN532 on Wire1 GPIO 18/19 (door's read code), lid sensor, settle-based
    lid cycle, gentle close, power-on zero, live idle weight, FULL_SYSTEM_MODE on LAB_01.
    - Personal door QR (SLB:~, hash only,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
2026-10-12 Camera: YOLO26s on ONNX Runtime at 640, 8 threads, fast box loop, in-use/passing rules, whole-picture flicker filter, robot work area, HOME support, safer face names; consumable bin precision
2026-10-12 Camera names: best-match reacquire with rivals, face min 0.50; bench QR+face entry bridge
2026-10-12 Camera: a name is never on two people at once
2026-10-12 Camera identity: faces cut from the detection frame (skip touching people, drop stale), look frozen while touching, place hand-back narrowed, look learnt only when alone
2026-10-12 Face ID: remove-photos button on the closed card too
2026-10-12 Camera: detector conf 0.35 (seated people), stricter look reacquire 0.18
2026-10-12 Camera: a lost name comes back only with that person's own face match (owner's rule)
2026-10-12 Robots in Equipment: live twin + joint bars; offline PREVIEW posed with the bars (drawing only); FANUC ER-4iA label, approximate pneumatic gripper
2026-10-12 Robots: hold a link and drag (preview), J7 gripper, full view, 11 lab PCs from the camera; Robots menu entry only for students
2026-10-12 Robots: grab any part, whole arm follows (IK, preview only); robots no longer listed twice
2026-10-12 Face server: enrolment before security-camera identify (no queue), YuNet face finding for enrolment, timing logged
2026-10-12 Audit: ESP32-CAM state probed directly, health pill names offline controllers, face archive git-ignored
2026-10-12 Labs: names/locations per owner, CAD lab retired (data kept), experiments inside each lab, door parts not lab equipment; usage charts with axes; health counts every offline device; tests never probe 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
2026-10-12 Labs: equipment gallery with free-licence model photos (credited, not our lab); Devices hides demo robots, shows Not configured addresses
2026-10-12 Labs: equipment gallery first on every lab page; per-lab items from the owner's list (UR5e, FANUC, 8x S7-1200, Proteus PCs, Power lab tanks/SCADA/HMI/MATLAB), text card where no honest photo exists
2026-10-12 Operation Center: titled X/Y axes on every chart, refresh at most every 15 s, no re-animation; Access & Audit debounced filtered reload; e2e jank probe
2026-10-12 System Devices: Screens card - door tablet link (Master ESP32), IoT wall in this tab or new tab, lab-network and this-computer addresses
2026-10-12 Equipment gallery: fixed 4:3 photo frames so a tall photo no longer stretches the row
2026-10-12 RFID: several cards per person (up to 5 on the door), remove one chosen card or all; revoked rows kept
    Door firmware adds a card instead of replacing it and removes by UID;
    portal lists every card with its own Remove button. Needs the Master
    ESP32 reflashed (compiles: huge_app partition).
2026-10-12 Consumable bin: fix crash on 'show' (float printed as %ld shifted the varargs; strlen on garbage)
2026-10-12 Consumables: book NET, confirmed changes - lifting the container books nothing until it is back, a value must repeat before it counts, quantity change = change in the count (notification said '36 pcs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
    Calibrated on the real bin 2026-10-13: envelope 1.048 g, 0.2066 g per 10k resistor.
2026-10-12 Security camera: YOLO26 on OpenVINO (CPU) - 105 ms/frame vs ~160 ms with ONNX Runtime, same people found on 23 lab frames; falls back to ONNX Runtime
2026-10-12 Security camera: YOLO26 on the graphics card via DirectML (GTX 1650: 33 ms/frame end-to-end vs ~160 ms CPU, same people on 23 lab frames); fastest device picked by timing; OpenVINO then ONNX Runtime 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
2026-10-12 Security camera start: set up the DirectML (graphics card) and OpenVINO engines automatically when missing
2026-10-12 SecurityCam engine audit: isolated per-device benchmark, DirectML placement check, real-frame parity and per-stage replay tools; 7 engine-selection tests; evidence report
2026-10-13 Knowledge history: local importers (git, Claude Code transcripts, ChatGPT export/share), secrets from .env/camera.env redacted, owner-review gate, timeline, data dictionary, gaps page; 9 tests
2026-10-13 Lab readiness 2026-10-15: UR5e collector never shows frozen RTDE data as live (link check, controller-timestamp dedupe, finite 6-joint validation) + tests and read-only rtde_check; backend refuses Na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
2026-10-14 Native knowledge graph (graph.py, evidence on every edge) used by investigate; camera: re-ID GPU choice survives a busy start-up, camera address off the command line and masked in logs; tests pin OLL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
2026-10-14 Checkpoint: reboot recovered via launch.bat; re-ID on GPU after a busy start-up verified live; no camera address in process list
2026-10-14 UR5e live: RTDE telemetry and digital twin verified at the lab (192.168.1.102, 48 Hz)
2026-10-14 UR5e LIVE_VERIFIED: joint-by-joint mapping, cable-pull stale in 2.0 s and automatic recovery, from the portal's event log
2026-10-14 UR5e monitor: console prints a movement summary (path length) instead of the full trajectory; the path still goes to the portal
2026-10-14 Camera: an error in one analysis pass is logged and analysis continues (it stopped for good at the lab after 45 passes); reported fps drops to 0 when analysis is stale; /health shows analysis age and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
2026-10-14 Camera start script refuses a second copy while port 5100 is in use (two services ran at the lab; the new one served nothing)
2026-10-14 Camera live at the lab: GPU engines verified, analysis-stall fault and double-start found and fixed, 60 s stable at 5 fps with 0 errors
2026-10-14 Camera: fix NVIDIA driver crash (nvwgf2umx.dll access violation, 4x at the lab) - equipment search shares the live detector's GPU session instead of creating a 2nd DirectML model, and one GPU lock se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
2026-10-14 Camera: switch off console QuickEdit at start - a click in the window blocked print() and froze analysis with no error
2026-10-14 Lab record: camera driver-crash root cause, reproduction, fix and live verification
2026-10-14 Camera: name tags never cover each other (neighbour's 'Unknown' was drawn over Nour's name at the lab); named people drawn on top, tags kept inside the picture
2026-10-14 Identity: the face outranks the body look in the crossing fix - a track whose current face votes agree on its name keeps it, nobody takes a name their own face contradicts (lab: Nour's face-confirmed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
2026-10-14 Lab test while the lock is not installed: door_test_entry.py (TEST entry, device DOOR_TEST, no door opened; --watch-face follows the door camera's recognitions); face server exposes the last recognis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
2026-10-14 door_test_entry.py --exit: close a wrong test entry the normal way (EXIT_RECORDED, kept); used for USER3 after a door-camera false match
2026-10-14 Door test: each door-camera recognition refreshes the test entry (10 s); camera logs every new person at the door with the waiting entries and time gaps
2026-10-14 Identity: hand a lost name back to the only new person at that place even while they touch a neighbour, if the look matches (lab: Ali lost his name sitting next to Nour); lost / not-handed-back / doo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
2026-10-14 Camera: zoomed re-detection inside unusually wide person boxes and where a named person was just lost - finds a person seated behind another (lab: Ali behind Nour, 0.76 in the zoom, missed in the ful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
2026-10-14 Camera: zoom one person box per pass in turn as well (a width ratio missed Ali behind Nour at 0.67)
2026-10-14 Camera speed: re-ID between 2 s refreshes only for people touching someone (all 8 every pass cost 63 ms); round-robin zoom every 3rd pass; test
2026-10-14 Camera metrics: tracking time split into re-ID / tracker / naming (track_parts_ms_p50)
2026-10-14 Camera speed: no re-ID for people under 80 px (their look is never judged; 13 people cost 138 ms); test
2026-10-14 Camera speed: zoom at a lost spot only when another person's box covers it (occlusion); an empty spot means they left (detect p50 140 ms with 4 people)
2026-10-14 Camera speed: one zoom per pass by priority (occluded lost spot > wide boxes in turn > round-robin); detect_main / zoom timed separately in /metrics
2026-10-14 Camera: analysis 7 passes/s (was 5) - measured 6.96-6.99 fps, pass p95 106 ms, GPU 36 %, 0 errors with 4 people
2026-10-14 Lab record: afternoon camera speed and identity work with measurements
2026-10-14 Camera: drop thin duplicate boxes inside a person before tracking (19 px strip inside Hemaly's box made 'two people at the desk'); half-hidden people kept; test with live boxes
2026-10-14 Tracking: still tracks survive 6 s, look gate after gaps (fragmentation 12->4 on real footage); fresh-only elimination; desk names drawn as a guess; /monitor sensor query via index (72->2 ms); perf/p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
2026-10-14 FANUC ER-4iA live twin (read-only HTTP GET of /MD/CURPOS.DG, real page format, motion on robot's own joints, twin-only J2/J3 coupling, Schunk EGP 40 gripper); two-camera support (camera2.env, per-cam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
2026-10-14 Checkpoint: evening 2026-10-14 deploy, FANUC live, camera 2 next
2026-10-14 Dashboard performance and chart axis titles
    Command Center: status messages refresh at most every 3 s (safety messages still 400 ms); requests 13.5 -> 9.4/s under simulated load. Isolated, non-destructive load test (tools/perf, docs/perf/LOAD_TEST.md). X/Y axis titles on every Reports, Issue analytics and AI chart. Tests: backend 457 passed, tsc + build OK.
2026-10-14 Face ID: automatic enrollment from the door stream, one detector pass
    Face server /enroll/auto (device key) keeps steady, sharp, new-looking frames from /analyze; refuses a face that clearly matches another enrolled person. /enroll runs YuNet once instead of three times. Enrollment preview served from the face server's frame (camera snapshot as fallback). Door threshold 0.363 and decision logic unchanged. Tests: face server 15 passed, enrollment 12 passed.
2026-10-14 Robot control groundwork: ownership, checks, audit; UR5e Home as dry run only
    Per-robot portal ownership (staff, 5 min expiry, admin force release), allowlisted actions, confirmation, fresh-telemetry and controller-mode checks, command-id de-duplication, audit log. Default ROBOT_CONTROL=dry_run sends nothing and reports DRY_RUN_SIMULATED / DRY_RUN; FANUC UNAVAILABLE. UR5e Dashboard client (load home program / play / stop only) reachable only with ROBOT_CONTROL=live after commissioning (docs/ROBOT_CONTROL.md). Fixed the no-command-route test that checked an empty list. Tests: 27 passed.
2026-10-14 Digital twin: virtual workcell, modelled collisions, views and full view
    Versioned workcell setups (table + MANUAL / CAMERA_ESTIMATE boxes, never verified), editor under each twin, link-vs-box collision check (0.19 ms per pose) shown as MODELLED contact. UR5e frame and measured table, base at 1.88 m; FANUC preview home pose; Front/Back/Right/Left/Top/Bottom/3D views; view frozen while dragging a joint; large full view with joint bars on the right. Read-only: nothing is sent to a robot. Tests: workcell API 4, geometry 7 passed.
2026-10-14 Login, welcome, navigation and the new Smart Lab symbol
    Login: cinematic left side from the lab's own photos, compact mobile header. /welcome: scroll story that replays, stays until Skip / Enter Dashboard (the 2.4 s post-login overlay no longer runs); first sign-in per browser only. Logo opens the role's dashboard; 'Lab Equipment' in the sidebar; sign-in shared across tabs; stale page files reload once after a deploy. Aperture-and-arm symbol as SVG everywhere and as favicon.
2026-10-20 Door enclosure fit-test release, Face-ID self-service, camera-first GPU gate, docs
    - tools/cad/door_enclosure: SOLIDWORKS generator updated from datasheet research
    (reports/Door enclosure component dimensions.md): TFT on its 4 PCB holes, PN532
    islands + 1.5 mm skin, R307 cradle + tie slots, active-buzzer cradle, PG7/M16
    glands, centred engraved text, STEP export, 14 component envelopes with SOLIDWORKS
    interference detection (none), STL manifold check, dimensioned drawings PDF,
    180 x 150 fit coupon. No speaker (removed by the owner).
    - docs/hardware: DOOR_ENCLOSURE.md (BOM, tolerance register, print settings,
    assembly), DOOR_MASTER_WIRING.md (PAM8403 / speaker removed).
    - Face-ID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
2026-10-20 Evening dossier 2026-10-20: enclosure release, AI CPU vs GPU measurement
    AI A/B with both cameras idle (qwen2.5:1.5b, 120-token answers): CPU 2.4 s /
    22 tok/s, GPU 1.3 s / 68 tok/s (1062 MB); model left on the CPU as found.
2026-10-20 Faster navigation: non-blocking 3D shader compile, hover pre-load, lighter Sessions tab
    Measured on the live portal (real Chrome, admin, 2026-10-20 evening):
    - 3D views (Robots & PCs, robot pages, welcome pair): the first render waited for the
    shader compile (WebGLUniforms, 1.2 s of main thread). Renders are now skipped until
    programs are ready (parallel compile; guarded - materials replaced mid-wait count as
    ready, max 2 s). Robots & PCs cold: 3D at 1.2-1.4 s (was ~2.5 s), long tasks
    0.56-0.72 s (was 2.06 s), longest ~0.24 s (was 0.61-0.89 s). Robots fleet page long
    tasks 75-128 ms (was 613-863 ms). Idle wait before the 2nd view 1.5 s -> 0.3 s.
    - Replay movement list (170 ms serve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
2026-10-20 Smart search, usernames, per-photo face review, instant Welcome skip
    - Search: the palette loads a small index once (/api/search/index, staff only) and ranks it in
    the browser on every keystroke (~1-5 ms): lab codes in any spelling (lab1 = LAB_01), subject
    words (robot -> Robotics Lab, UR5e, FANUC), typos (fanuk), prefixes, natural phrases
    ("temperature too high", "booking access denied"), people; server search only fills gaps.
    - Usernames: sign in with e-mail or username; firstname.lastname required for new sign-ups,
    suggested from the name (ramy.shenouda); administrators give / change / remove any username.
    Migration e6c2a8f4b170 (nullable unique column, no row changed).
    - Face p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
2026-10-20 CAD: sketch snapping off during build (fixes FP test opening 21x16.2 -> 21x19 and missing 2nd R307 tie slot, found by an independent SolidCraft model); rebuilt all parts; role matrix benchmark script
2026-10-20 Door box 110 mm deep (wire gap 25 -> 45 mm), rebuilt body + assembly; washers/spacers in BOM; checkpoint with role-matrix and test results
2026-10-20 Door box: owner's 0.3 mm fit rule (Neptune 4) - M3 3.3, slots 3.3, keyhole 4.3, LED 5.3, buzzer 12.3, glands 12.8/16.3, pockets +0.3; inserts/self-tap pilots stay undersize on purpose; coupon bracket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
2026-10-21 Live PCs and sharing: admin = master on sign-in, instant Stop (410 + share_state push), pc_state pushes, students share after admin approval, exam lockdown (kiosk Chrome), maintenance cover, notice c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
2026-10-21 Open tabs pick up new portal versions (reload on next page change + banner); share preview keyed per share so it can never stay on 'Waiting for the first frame'
2026-10-21 Robots & PCs scrolling: 3D redraws only on real value changes, memoized twin, no drawing off screen, 3D starts on click / resting pointer (not mid-scroll) - dropped frames 36-61 -> 4-5, worst stall 1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
2026-10-21 Cameras: no view anchor / box re-alignment for 3 min after the stream (re)connects - PTZ power-on sweep re-aligned camera 2's boxes to the wrong view
2026-10-21 Security boxes: smallest box 0.5 % of the picture (was 2 % in the page, 1 % in the API) - far monitors on camera 1 could not be boxed; page says why Add box is off
2026-10-21 Camera /state lists the current boxes only (deleted boxes stayed listed until a restart; the portal was not affected)
2026-10-21 Checkpoint: cameras re-boxed by real PC numbers, two-camera PC links PC-05..13, PTZ start guard, thesis snapshots (local only)
2026-10-21 Cameras: same-desk pairing - a person seated alone at a linked PC (owner-verified desk_map.json, PC-05..13) on both cameras is the same person; confirmed names cross through the existing stability / 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
2026-10-21 Robots & PCs smooth: movement list draws the newest 40 (was up to 1000 rows = 77 % of the tab's elements), tab kept mounted after the first visit, 3D starts on click only, still saved once a week wit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
2026-10-21 Cameras: boxes under 8 px are compared over an 8 px area (Security_Camera_2 stayed learning); Hemaly's desk = PC-04 + PC-01 after the renumbering (same monitors as the old PC-09 + PC-10)
2026-10-21 Door TEST watcher: entry only when the door camera agrees (same name 2x within 5 s, no other name within 10 s) and the recognition is fresh - one person was answered USER5, USER1, USER3 within 25 s a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
2026-10-21 Cameras analyse up to 10 a second (was 7): measured 9.1 / 8.6 per s, GTX 70-76 %, 70 C, frame age unchanged; live views 25 ms pause (~15 pictures/s), All cameras wall 100 ms (was 200)
2026-10-21 Cameras: desk guesses (Eng. Hemaly? / TA? (desk), shown only), PC in use held only by a seated person, look tie-break for close floor pairings (measured same 0.31 vs different 0.79), pair capture + f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
2026-10-21 Cameras: the look leads close pairings (measured: veto above 0.65, clear match at or below 0.40 with a 0.20 margin pairs up to 2 m and may cross while touching a neighbour) - camera 1 floor put Nour 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
2026-10-21 Checkpoint 2026-10-21 18:45 (lab closing): two-camera naming results and open items
2026-10-21 Robot twin: static scene parts memoized (a joint update re-renders the arm only) - not yet measured/deployed; smoothness E2E can drive both robots live; checkpoint
2026-10-21 PC in use from seats + LAN power (camera prefers the PC that is on; seat_capture.py records seats), PC tiles: Seated - PC off / Off; UR5e Local mode no longer says teach pendant for every move (Exter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
2026-10-22 Freeze recorder: staff browsers report long frames (> 150 ms) with Chrome Long Animation Frames attribution + page context; memory only, admins read /api/uiperf/reports
2026-10-24 Door box: coupon result - NFC card reads through the 1.5 mm skin (owner, printed coupon)
2026-10-24 Door box: owner's caliper measurements + 0.3 (NFC 42.85 x 40.52, LED 5.0, buzzer 12.2, TFT glass 33.7 x 43.4 / PCB 57.7, buck, relay 57.66 x 29.8, breadboards, ESP32 + 57 mm free for wires, Dupont sl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
2026-10-24 Door box: fingerprint stands out 15 mm (20.0 x 23.5 opening, sleeve, back stop, clamp screw), LCD landscape centred, raised text 8/9 mm; body shell face picked by geometry (a view-dependent pick shel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
2026-10-26 Cameras: YOLO26s 544x960 + ByteTrack-style low-confidence stage + new-track threshold + part boxes + 416 zoom model (reviewed lab clips: HOTA 0.732->0.779, IDF1 0.831->0.874, two cameras 7.8/8.9 -> 9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
    - docs/CV_BENCHMARK_2026-10-26.md: 30 detector configs on 363 reviewed people, 9 published trackers, 3 reviewed clips
    - tools/ur5e_control: Local-mode agent (Dashboard load/play/stop are Remote-only per UR docs); backend ur_agent.py;
    both sides must agree on dry_run/live; nothing has ever been sent to a robot
    - tests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
2026-10-26 Scan the lab: phone camera in the AI assistant - QR asset markers decoded on the phone (exact record key, never appearance), live asset cards from the authoritative records, optional people boxes via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
    - backend: app/services/scan.py + /api/scan (registry, asset card, marker.png, link.png, people proxy), tests 13
    - camera service: POST /detect (YOLO26s 416, 429 when busy, nothing stored), tests 3
    - frontend: /scan, /scan/markers, /phone-setup; jsQR worker (approved); e2e scan_lab (5 start/stop cycles, card 226-255 ms warm) + scan_people (7 frames/s, r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
2026-10-26 UR5e Local mode: automatic Home after idle (cancellable countdown in the twin, same guarded path, off by default); hardware STOP relay on the safeguard stop input (ESP32 firmware, polled latch, recov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
2026-10-26 Voice in the AI assistant: push-to-talk (Talk in the launcher or the mic) -> local Whisper base.en on the CPU (1.3-1.5 s, one at a time, camera unaffected) -> the normal question path; short spoken a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
2026-10-26 Audit fixes + priorities: booking race closed (per-lab advisory lock; two simultaneous overlapping bookings were both saved), /equipment fixed query count (was ~6 per device + all-time session scan),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
2026-10-26 Portal: camera 2 on the IoT Dashboard floor plan (own status + people count, never summed); screen share no longer waits forever when the shared window gives no picture (+ hint); voice questions on S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
2026-10-27 Scan the lab: picture QR markers (the icon IS the code: camera, shield, robot arm, door, PC, server, sensor, bin, tool; halftone modules, error correction H, every theme decode-tested), Print = A4 PD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
2026-10-27 Live camera target layer: structured live data per asset (UR5e six joints in deg + velocity, TCP, robot/safety mode, LIVE/STALE/OFFLINE/NO_TELEMETRY; consumables count only when calibrated; reusable-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
2026-10-27 Owner fixes: lab floor with the real PC numbering (engineer desk PC-01/04, front desk PC-02 + PC-03 removed, central table PC-05..09 and PC-15..10, names inside the boxes, camera/FANUC/windows labels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
2026-10-27 Markers redesigned: dark navy cards with circuit traces and a category glow, the asset motif built into the QR modules (robot arm, camera, door, PC, server stack, shield, consumables node, reusable-i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
2026-10-27 No more blank-then-appear: robot stills ship with the portal (instant picture on every browser/address, also in Full view, until the 3D has drawn the robot); Lab PCs drawn once both sources answered 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
2026-10-27 Live Smart Lab camera: live chips pinned to each marker / person in the picture (positioned every frame, smoothed), tap to select, expanded live panel (UR5e six joint bars in the twin's limits + velo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
2026-10-27 Asset-shaped QR markers: the code itself forms the object (camera body + viewfinder + lens ring of real modules, door frame + leaf + handle, robot base + arm links + joints + gripper, laptop screen +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
2026-10-27 Checkpoint 2026-10-27 14:10: live camera + shaped markers deployed
2026-10-27 Enclosure appearance matching (hint only): local ORB + RANSAC against owner reference photos (backend/data/asset_refs, manifest of the 4 enclosures, photo list); PROBABLE / AMBIGUOUS / UNKNOWN with c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
2026-10-27 Live camera: 'Which box is this?' - one frame against the enclosure photos, shown as a hint only (scan the marker for identity and live data)
2026-10-27 Advisory safety triage (15.2): one ranked list per lab from camera + robot + door + environment + access records (P1 hazard / robot moving with people on camera; P2 unattended or unsupervised robot m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
2026-10-27 Owner's QR marker pack integrated: payloads checked against the live registry - 6/8 exact (CAM_LAB01, FACESRV_01, MASTER_LAB01, PC_ADMIN_LAPTOP, UR5E_01, FANUC_01) used as supplied; SLAB:D:CONS_BIN_0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
2026-10-27 IoT Dashboard wall redesign: one-row header (5 columns - Portal/Esc, title, scope, health, clock + full screen; nothing wraps), three columns 25/47/28 - left: camera switch tabs + large camera previe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
2026-10-27 Whole-lab time slider backend (15.3): GET /labs/{id}/at?t= - the lab at time t rebuilt from recorded history only (door sessions open at t, last reading per metric with age, alerts open at t, robots'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
2026-10-27 Owner fixes: spoken answers on the laptop (audio unlocked inside the click, one reused player, first sentence synthesised alone, 'Play answer' button if the browser still blocks); laptop / front came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
2026-10-27 Phone live camera: spoken answers on iPhone (voice status read on every device, not only where recording works - answers had fallen to the browser voice, which Safari silences after an await; browser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
2026-10-27 Illustrated asset markers (owner: door ajar with the QR on the door, 3D 6-axis robots, camera lens = QR): 10 drawings around the real flat QR (ECC H, portal encoder), jsQR 80/80 + OpenCV 50/50 (lossl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
2026-10-27 Faster portal + more instant answers. Scrolling: no live backdrop blur behind every card / top bar / sidebar / lab chips and the page light on its own fixed layer (measured, real Chrome: frame p95 33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
2026-10-27 Agent upgrades: proactive suggestions (CONFIRMED offline / low stock / recurring vs POSSIBLE sensor anomaly / occupancy change, evidence + timestamps, de-duplicated, recomputed only when data changes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
2026-10-27 Reliability briefing: cache only the service probes 30 s (the briefing itself stays per call - it marks repeated items); full suite 704 + fix
2026-10-27 Phone scan: camera / face / appearance / voice-transcribe calls run on worker threads instead of the event loop (they held every other request - the spoken answer waited 14 s behind back-to-back fram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
2026-10-27 Instant 'how to improve / what is wrong with <device>' from its own records (status, 30-day use, faults, robot events, alerts + playbook steps, proactive findings); Download PDF prints the owner's pi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
2026-10-27 Navigation: pointing at a sidebar link also downloads that page's code, idle prefetch starts at 0.4 s (was 1.5 s); System analytics keeps the shown range while switching (no full-page spinner) and re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
2026-10-27 Load: short shared caches (one computation per key, concurrent callers wait for it) for the wall screen 2 s, camera list 2 s, issue summary 5 s, system analytics 20 s; session ramp tool (tools/perf/s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
2026-10-27 Backend concurrency: the sync-route worker threads (40) equalled the DB pool (40) - the auth dependency held a connection while the route waited for a thread (circular wait until the 10 s pool timeou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
2026-10-27 Welcome page: 3D scenes stay once built (were rebuilt - WebGL + shaders - every time they scrolled back in); no backdrop blur, no colour filter on the parallax photos. Real Chrome scroll: frames > 50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
2026-10-27 AI model down: fail fast with the real reason (connect timeout = not running; a model known down < 20 s ago answers at once), health probe connect 1 s. Fault test (isolated copy, every outside servic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
2026-10-27 Phone camera: Tell me more + mic float on the camera picture (owner: had to scroll down to press them)
2026-10-27 Box look-up: runs by itself every 3 s while no marker is in view (owner: 'it did not detect it, only the QR'), result shown on the picture; each verdict logged (decision + match points, never the fra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
2026-10-28 Phone camera: switching camera clears the selected target; a selected person who left the picture no longer blocks the marker in view (owner: back camera on the bin QR answered 'person not identified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
2026-10-28 Phone camera: box verdict fades after 5 s (a bin verdict stayed on screen over the owner's face); the automatic box check really runs every 3 s (its timer was re-created every render and never fired)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
2026-10-28 Box look-up draws a dashed frame around the matched points (owner: message but no frame); visual AI plan (owner's 12-class round one, data rules, YOLO11n vs YOLO26n comparison, deployment benchmarks,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
2026-10-28 Visual AI round one tooling: prepare.py (video -> frames per session, near-duplicates skipped; session-based 70/15/15 split with frozen 12 classes + manifest; unlabeled images kept as negatives) and 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
2026-10-28 Phone camera: 'Tell me more' under a fresh box look-up verdict answers at class level (what it looks like, unconfirmed, scan the marker for live data) instead of 'nothing identified' - no asset ID fr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
2026-10-28 Phone camera: a failed marker lookup retries after 2 s (was 5 s) - the owner's test hit a 30 s backend restart
2026-10-28 Box look-up frame wraps the WHOLE object: the owner-checked whole-station box of the matched reference photo is carried into the phone frame through the match's homography (owner: 'the frame is a sma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
2026-10-28 Box look-up learns only the object (reference keypoints inside the whole-station box): the owner's face had matched the bin at 58 points through the shared room background; now 4/4 face frames, 4/4 n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
2026-10-28 Phone camera Refresh: stopping speech now finishes the pending answer (the paused player never fired 'ended' - the page stayed on 'Speaking...'), the voice panel resets, and the fresh look is not blo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
2026-10-28 Phone camera Refresh: automatic box check waits 6 s after Refresh (the bin still in view was re-found at once), 'Refreshed' note
2026-10-28 Phone camera: watchdog resumes the live video when iPhone Safari pauses it as the spoken answer plays (picture stuck on the bin), also on Refresh
2026-10-28 Phone camera Refresh = Stop + Start camera (same camera): speech, frames, verdicts, tracks, selection and the voice panel all reset - a clean start (owner)
2026-10-28 Phone camera: Live history under the camera - one timed line per new detection (person / named person with face %, QR read, look-alike recognition) and per answer; repeats within 15 s skipped; kept a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
2026-10-28 Live history: a symbol per asset type (robot, door, cameras, PC, bins, environment, PLC, ...) and a face for a named person
2026-10-28 Phone camera: speech no longer cut mid-answer (the video watchdog waits while an answer plays and resumes the video after it; speech paused by iOS resumes); Refresh keeps the camera stream (restart d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
2026-10-28 Phone camera: live caption of the spoken answer on the picture; mic state shown on the picture (red while listening, clear message if blocked/unavailable); no scroll jump to the text on a new answer;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
2026-10-28 Phone camera: glass controls on the live picture (switch camera, pause, which box, stop at the side; refresh, Tell me more, mic at the bottom); centred glass caption with bold text and who is speakin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
2026-10-28 Phone camera: re-layout the video on every new stream/size (iPhone drew a switched camera small); glass buttons without backdrop blur (lag over live video), lighter caption blur
2026-10-28 Phone camera: live captions type each sentence in step with the voice (revealed by audio playback position; browser voice by word boundaries) and stay until the whole answer is spoken (was cleared af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
2026-10-28 Responsive portal: shared rules (controls never wider than the screen, long ids wrap, data tables scroll inside their card on phones, 40 px touch targets on coarse pointers, safe-area insets, chips m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
2026-10-28 Touch targets: header controls 40 px, inline text links and link-buttons get a taller tap area on coarse pointers
2026-10-28 Fix letter-by-letter text on phones (overflow-wrap anywhere shrank flex items to one letter; now break-word, ids/mono only anywhere) + audit check for it; IoT subsystem details full width on phones/t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
2026-10-29 Reusable-bin detector behind "which box?" + phone-path speed-ups
    - bin_detector: YOLO (owner's photos) via ONNX Runtime CPU (2 threads; GPU stays with the cameras), centred letterbox,
    OpenCV DNN fallback; /scan/appearance asks it only when the photo matcher says UNKNOWN (far / side views)
    - parity with Ultralytics: max confidence diff 0.029, box edge 0.007, same call 23/23; ORT 167 ms vs OpenCV DNN 525 ms
    - appearance matcher: reference photos compared on 4 cores, same decisions, p50 421 -> 333 ms; matcher + detector
    warmed at startup (first look waited ~6 s)
    - phone shows "detector NN% sure" for detector hits
    - e2e/phone_inference_bench.mjs: on-phone YOLO26s in ONNX Runtime Web (simulat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
2026-10-29 Deploy bin detector (round-3 YOLO26n, ONNX 9.8 MB, conf 0.6): unseen scenes 14/15, no-bin 5/429 (patches 0/8, lab frames 0/221, COCO 5/200); live container 14/15, 130 ms warm; eval_deployed.py tests 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
2026-10-29 Bin detector: round-4 YOLO11n (+ lab-camera negatives), conf 0.4 - unseen 14/15, no-bin 0/429 (top no-bin score 0.19), live 14/15 / 0/44 at 86 ms; beats round-3 YOLO26n (5/429) and the other four mod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
2026-10-29 Colab notebook for one-object training (default TP-Link switch): Drive zip -> HEIC->JPG (no GPS) -> YOLO-World boxes + contact sheets -> YOLO11n + 400 COCO negatives -> test report + ONNX to MyDrive/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
2026-10-29 Colab notebook: videos in the zip are used too (2 frames a second)
2026-10-29 Fix alert deadlock (one advisory lock for all alert writes - per-fingerprint locks deadlocked on two camera alerts and stalled the backend); appearance log says by=matcher|detector and the detector c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
2026-11-02 Monitoring-only robots, several detectors at once, bin round 5 + router/switch model
    - robots: Home/STOP panel and control API calls removed from the portal ("Monitoring only" note), ROBOT_CONTROL
    defaults to off, launch.bat no longer starts the UR5e control agent; twin larger (880 px page, 26 rem panel)
    - detectors: bin_detector runs the bin model plus every model in data/models/detectors.json (one-class or
    multi-class); unregistered objects answer as type:<class> with a label ("not a registered asset yet")
    - bin: round 5 (owner video) conf 0.45 - unseen 14/15, no-bin 1/429, hard video views 18/24 (round 4: 6/24)
    - all_detector.onnx (Colab, bin+switch+router): router 18/18 found / 1 fal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
2026-11-02 Lab-wide dataset (12 classes): contact-sheet review rejections, bin/switch/router from the hand-checked rounds (no train/test leak), cameras left out (same model, lens-only boxes), lab-camera frames 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
2026-11-02 Fixes from the Gemini review (docs/reviews in review/gemini): zoom crop = the on-screen part (portrait kept full height), zoom reset on stop/refresh, hardware-zoom fallback, overlay buttons no longer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
2026-11-03 P0/P1 post-lab fixes (Gemini MASTER-HANDOFF-20261103, verified item by item)
    - ACT-02: the lab engineer (LAB_STAFF) controls his own master PC; the admin's portal laptop stays admin-only
    and can never be put in EXAM / LOCKED; staff master access, staff shares skip the admin PC, admin = master of
    the master (staff cannot stop or override an admin's share), watch-only share links for lab PCs.
    - ACT-05: UR5e IN_USE no longer flickers: a detector miss < 3 s keeps the warm-up, a robot holds IN_USE 20 s
    after its operator was last seen, "near" uses the robot's working area (PCs unchanged).
    - ACT-06: cross-camera naming by elimination gated on matching name sets, a measured look, floor distan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
2026-11-08 Repository audit and maintenance release (2026-11-09)
    Consolidates the uncommitted work of 3-8 Nov and documents the existing system. No new product features.
    - Commits earlier improvements re-tested today: door relay boot fix (hardware-verified 8 Nov), per-PC
    agent keys + migration f1a7c3d9e250 (not yet deployed live), lab-wide detector, dual-NIC address
    preference, visibility-aware polling, PC agent tools, LAN relay, enclosure CAD sources and release STLs,
    robot meshes (licences in frontend/public/models/README.md), docs and Gemini review records.
    - Adds launch.ps1 / stop.ps1: one-command core stack start with .env validation and health wait; stop
    keeps all volumes.
    - Adds docs/re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
2026-11-08 docs: include the Obsidian vault, thesis figures, reports, CAD outputs, portal captures and PC-kit scripts
    - docs/knowledge/obsidian/vault: the project's Obsidian vault (322 notes, settings) and a README on how
    kb.py builds it and how the local knowledge agent answers from it with sources. Chat transcripts
    (History review) and third-party plugin code are not included.
    - docs/paper_figures (31 portal figures, every face detection reviewed: chat button and lab art only),
    docs/reports (status reports, dossiers, evidence and perf records).
    - tools/cad: SolidWorks parts, assemblies, STEP/STL outputs, drawings and earlier fit-test iterations
    (lock files and zips stay out).
    - docs/media/por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
2026-11-09 docs: full project documentation release (identity, architecture, hardware, vision, twin, AR, AI, knowledge, automation, software, network)
    - README rewritten around the platform title (old README kept as docs/PORTAL_GUIDE.md, links fixed)
    - docs/architecture: master architecture with Mermaid diagrams (components, access-to-presence sequence, network,
    data flow, AI/automation, twin/AR), every arrow checked against the code
    - docs/hardware: four nodes, door system, power, pinouts (from firmware constants), validation status
    - docs/computer-vision, docs/digital-twin, docs/augmented-reality, docs/ai, docs/knowledge, docs/automation:
    how each subsystem works, its limits and what has been ver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
2026-11-10 docs: defense brief, optimisation-phase remaining work, architecture decisions 12-15 (Docker/WSL split, no ROS, two cameras, GPU sharing)
2026-11-10 docs: architecture image composed from the real CAD renders, lab photos and portal screenshots; README opens with it
2026-11-10 docs: both cameras are floor-calibrated; the open item is the name handoff with hidden feet or a left view
2026-11-11 Closure and optimisation: security fixes, camera identity, faster portal and AI, monitoring
    Security (Argon SEC-01..05, verified against the code, patch not applied):
    - door reports: a device's own key speaks only for itself, door devices only
    - own key must report as its own kind (/equipment/state)
    - PC enrolment closed by default and passed through docker-compose
    - live-updates socket: one-time 30 s ticket instead of the token in the URL;
    nginx access log without query strings
    - /scan/appearance rate limit (6 frames / 2 s per user)
    - CI: issued booking QR tokens are checked through the door-camera model
    Cameras (simulation-tested; lab walk test pending):
    - no cross-camera name from the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
2026-11-11 Fix camera event snapshots and reduce background CPU load
    - FG-02: an alert whose stored picture is older than 0.3 s draws the newest
    camera frame in the sender thread; snapshot_age_ms travels with the alert.
    - FG-03: detector CPU-fallback threads 8 -> 3 (SV_DET_THREADS); measured
    1.66 vs 1.25 passes/s with both camera services on the CPU.
    - FG-05: default OLLAMA_MODEL qwen2.5:1.5b in .env.example and compose.
    - Knowledge builds embed with 3 Ollama threads (build_embed_threads, 0 = old).
    Tests: security_vision 332 passed (py -3.14), knowledge 49 passed.
2026-11-11 Status window: show CPU, paging rate, disk latency, GPU load and top CPU users (FG-08)
    Free RAM alone hid the real cause of slowness on 11 Nov: paging to the D: hard
    disk (~1,170 pages/s, 16-31 ms per transfer) and Explorer/OneDrive at 5-7 cores.
    One 1 s counter sample per refresh; warns when paging exceeds 500 pages/s.
2026-11-11 Accept the notification kinds workflows 13-21 send (n8n 422 every 5 min)
    ENVIRONMENT_HAZARD, LOW_STOCK, STOCK_CHANGE, ASSET_OVERDUE, ROBOT and
    EXAM_VIOLATION were rejected by /api/automation/notify, so those workflows lost
    their alerts whenever they found something (workflow 18 failed every 5 min).
    New test reads the repo workflow copies and checks every kind is accepted.
    Tests: automation suites 26 passed, 1 skipped (workflow JSON not mounted in the
    container); test_automation_kinds passes locally (--noconftest).
2026-11-11 Answer "which PCs are free?" from the device records; fix one-argument test runner
    - agent.py: pcs_status also matches free/busy/available/occupied; the answer
    ends with free (online, nobody signed in) / in use / offline counts. Before,
    the question went to the model: 14-30 s and a wrong, repeating list. Now 0.41 s.
    - test_backend_fast.ps1: a single pytest argument was splatted per character.
    Tests: full backend 776 passed, 3 skipped (test_backend_fast.ps1, 7 min 24 s).
2026-11-11 Keep a name through a dead zone (60 s), faster AR scan, one live line per named person
    - vision.py: HANDBACK_S 20 -> 60 s; past 20 s the hand-back also needs a look margin
    over every other unnamed person in view (two equal looks -> nobody).
    scenario_bench: new 07c/07d (25 s dead zone, look-alike at the spot) and 11 (leaves
    view 3 min): 0 false names; correct name 0.90 -> 0.97 of frames.
    - detectors.json: all_detector.onnx no longer run; lab_detector switch threshold 0.35.
    Same test set: 153/171 found, 0/221 false (was 150-154); 205 -> 104 ms per image,
    live detect_all 58 ms p50.
    - Security.tsx: live bar shows "N people in view" and merges a named person seen by
    both cameras into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
2026-11-11 Pillow 13.0.0 (13 CVEs), AI model kept loaded 30 min, camera password out of the docs
    - requirements.txt: Pillow 12.3.0 -> 13.0.0 (pip-audit: 13 advisories fixed in 13.0.0;
    the backend decodes uploaded snapshots and scan frames).
    - ai.py / compose: OLLAMA_KEEP_ALIVE setting, default 30m (was 10m): a question after an
    unload waited 30 s (portal) / 63 s (direct Ollama).
    - camera2.env.example, TWO_CAMERAS.md: the real camera-2 RTSP password was in both;
    replaced by <password>. It remains in git history - change it on the camera.
    Tests: full backend 776 passed, 3 skipped (test_backend_fast.ps1, Pillow 13 image).
2026-11-12 Cameras align their boxes by themselves after power-on: stability check, status, seats, masks
    - security_vision.py: the fixed 180 s wait became a 45 s minimum; within the first 5 minutes boxes move only
    after the predicted positions held 20 s (checks every 3 s) on a strong match; no new reference in that window;
    per-camera status offline/settling/calibrating/calibrated/needs_review with reason, sent with the state report.
    - realign.py: PC screens (inner 70 %) and robot cells are masked while matching; seat boxes follow the same
    transform, always from the recorded seats (no drift); the accepted transform is kept with the anchor.
    - n8n/staggered: copies of the five 5-minute workflows on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
2026-11-12 Calibration status in the portal; python-jose -> PyJWT 2.15.1 (no ecdsa); private reports git-ignored
    - security.py (route): StateReport carries the camera's calibration status (5 known states, numbers only, no
    paths); a state change pushes a live update; Security.tsx shows a chip per camera (reason as tooltip).
    - JWT: python-jose[cryptography] (pulled the unfixed ecdsa) replaced by PyJWT 2.15.1 (2.10.1 has 4 advisories);
    same HS256 tokens and claims. test_jwt_rules: wrong key, expired, HS512, alg=none, garbage all rejected.
    - .gitignore: laptop audit + local-only report folders (personal paths) never public.
    Tests: full backend 779 passed, 3 skipped (test_backend_fast.ps1, PyJWT image)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
